TheTrueTom/GLINCS-KiCAD-Libraries/3D/BBL-105-G-E.stp

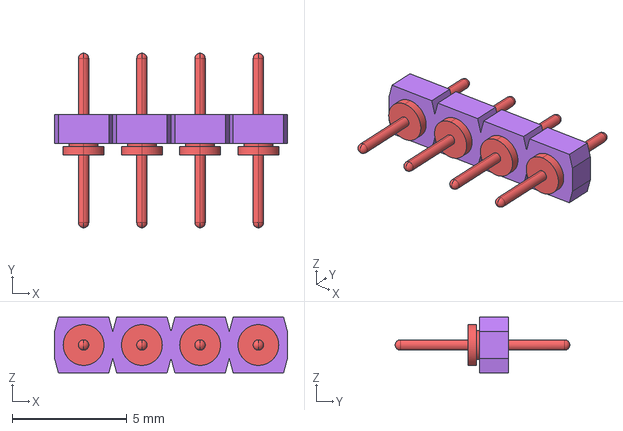
[picture p1: CAD file, 2020-01-22]
3D/BBL-105-G-E.stp
10.2 x 7.62 x 2.44 mm
