TheTrueTom/GLINCS-KiCAD-Libraries/3D/centrale AXINTDETECT/disjoncteur_legrand_007850.stp

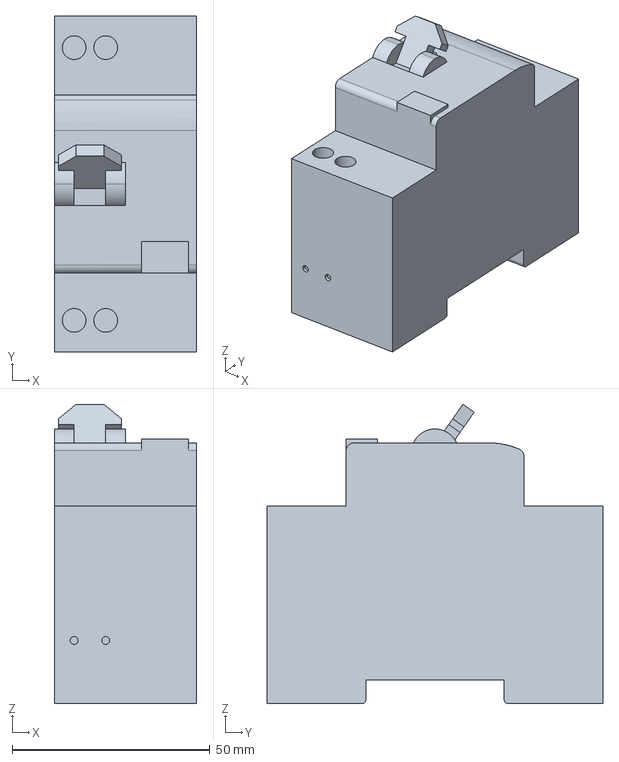
[picture p2: CAD file, 2023-04-24]
3D/centrale AXINTDETECT/disjoncteur_legrand_007850.stp
36.0 x 85.0 x 75.7 mm
