TheTrueTom/GLINCS-KiCAD-Libraries/3D/GLINCS/EVQ-Q2D03W.stp

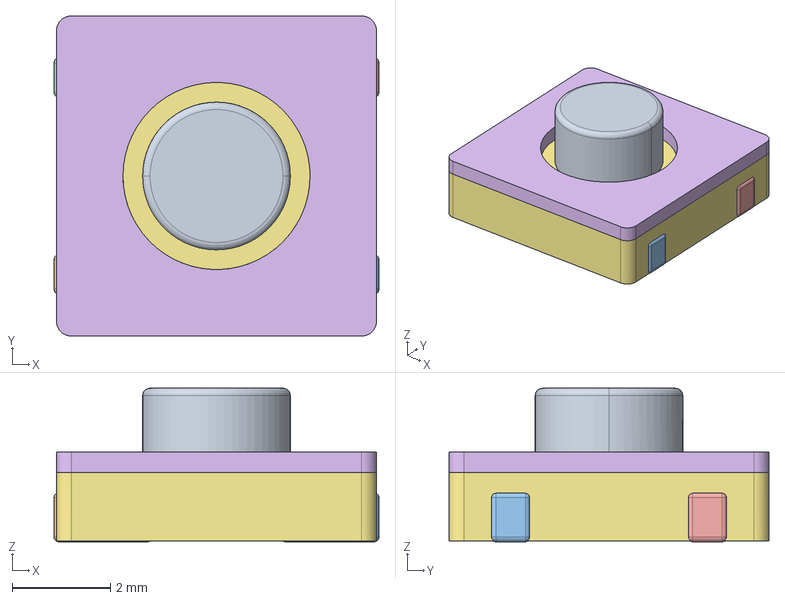
[picture p3: CAD file, 2026-05-20]
3D/GLINCS/EVQ-Q2D03W.stp
6.60 x 6.50 x 3.12 mm
