TheTrueTom/GLINCS-KiCAD-Libraries/3D/GLINCS_C/CAPA0603.step

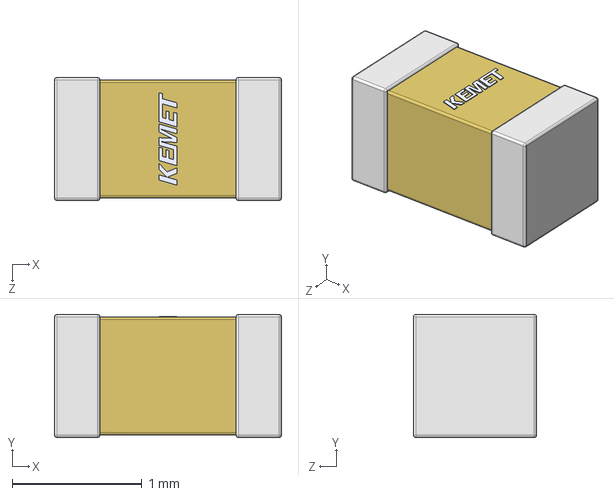
[picture p4: CAD file, 2025-09-26]
3D/GLINCS_C/CAPA0603.step
1.75 x 0.95 x 0.95 mm
