TheTrueTom/GLINCS-KiCAD-Libraries/3D/GLINCS_Connectors/B3B-ZR.STEP

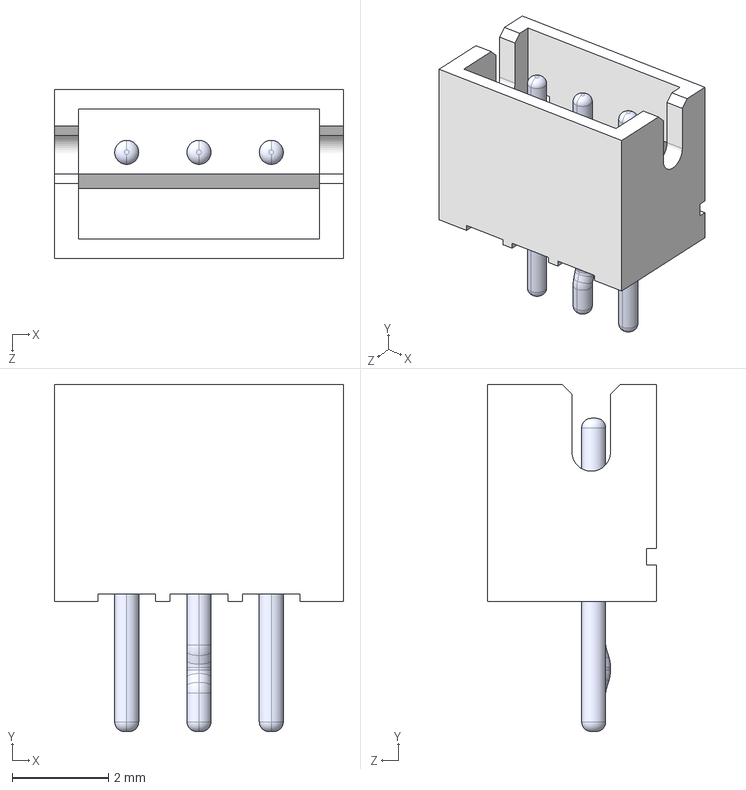
[picture p5: CAD file, 2026-04-17]
3D/GLINCS_Connectors/B3B-ZR.STEP
6.00 x 7.20 x 3.50 mm
BxB-ZR_3
pin_straight x 2
pin_Bent
