TheTrueTom/GLINCS-KiCAD-Libraries/3D/GLINCS_Connectors/JST-GH/BM02B-GHS-TBT/BM02B-GHS-TBT.STEP

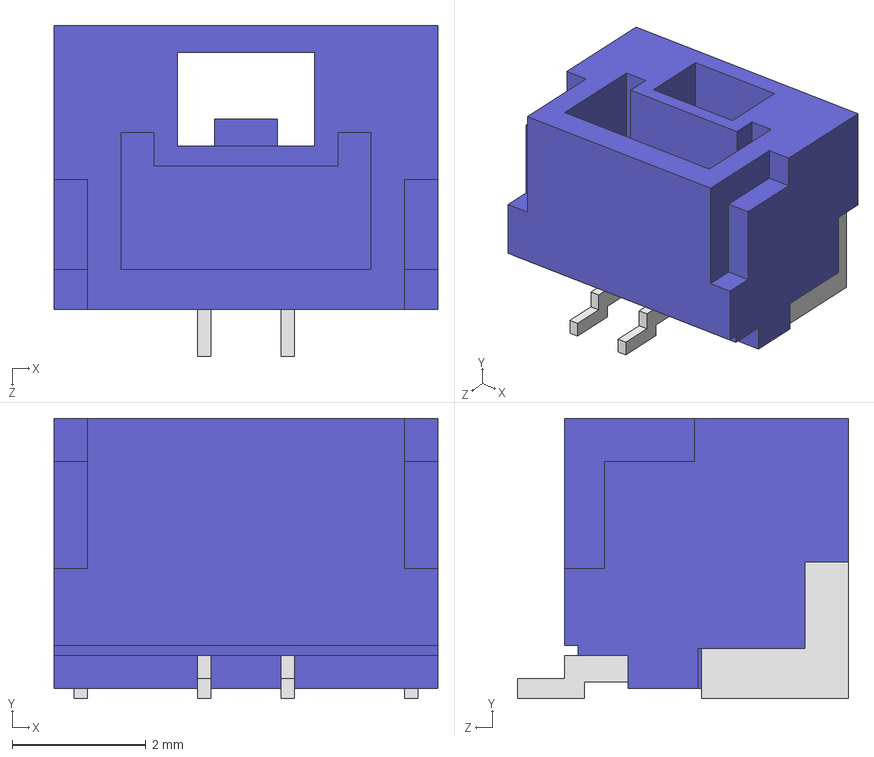
[picture p6: CAD file, 2021-05-18]
3D/GLINCS_Connectors/JST-GH/BM02B-GHS-TBT/BM02B-GHS-TBT.STEP
5.75 x 4.20 x 4.95 mm
