TheTrueTom/GLINCS-KiCAD-Libraries/3D/GLINCS_Connectors/JST-GH/BM03B-GHS-TBT/BM03B-GHS-TBT.STEP

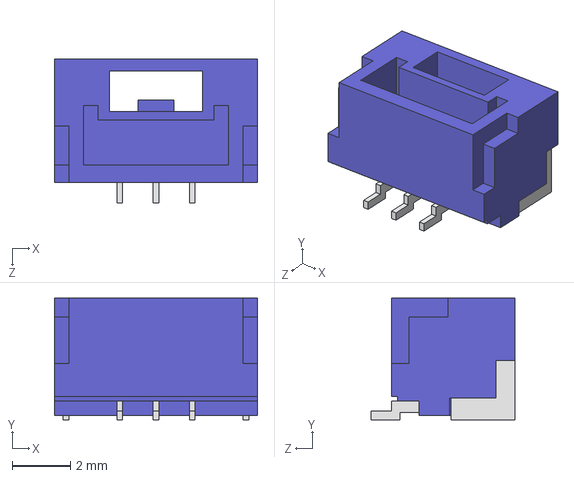
[picture p7: CAD file, 2021-05-18]
3D/GLINCS_Connectors/JST-GH/BM03B-GHS-TBT/BM03B-GHS-TBT.STEP
7.00 x 4.20 x 4.95 mm
