TheTrueTom/GLINCS-KiCAD-Libraries/3D/GLINCS_Connectors/JST-GH/BM04B-GHS-TBT/BM04B-GHS-TBT.STEP

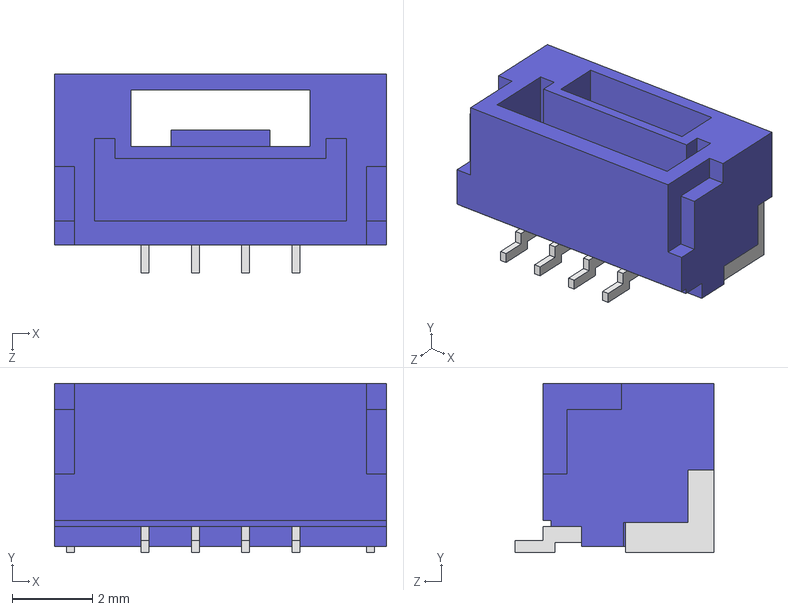
[picture p8: CAD file, 2021-05-18]
3D/GLINCS_Connectors/JST-GH/BM04B-GHS-TBT/BM04B-GHS-TBT.STEP
8.25 x 4.20 x 4.95 mm
