TheTrueTom/GLINCS-KiCAD-Libraries/3D/GLINCS_Connectors/JST-GH/GHR-02V-S/GHR-02V-S.STEP

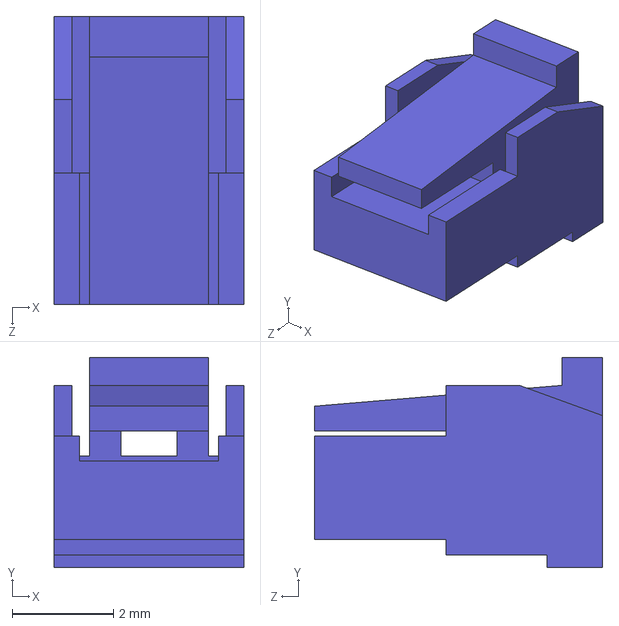
[picture p9: CAD file, 2021-05-18]
3D/GLINCS_Connectors/JST-GH/GHR-02V-S/GHR-02V-S.STEP
3.75 x 4.15 x 5.70 mm
