TheTrueTom/GLINCS-KiCAD-Libraries/3D/GLINCS_Connectors/JST-GH/GHR-03V-S/GHR-03V-S.STEP

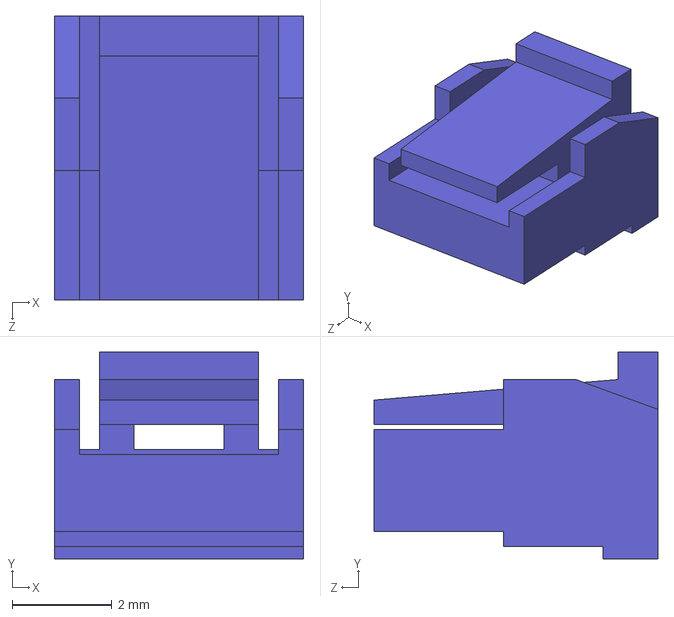
[picture p10: CAD file, 2021-05-18]
3D/GLINCS_Connectors/JST-GH/GHR-03V-S/GHR-03V-S.STEP
5.00 x 4.15 x 5.70 mm
