TheTrueTom/GLINCS-KiCAD-Libraries/3D/GLINCS_Connectors/JST-GH/GHR-04V-S/GHR-04V-S.STEP

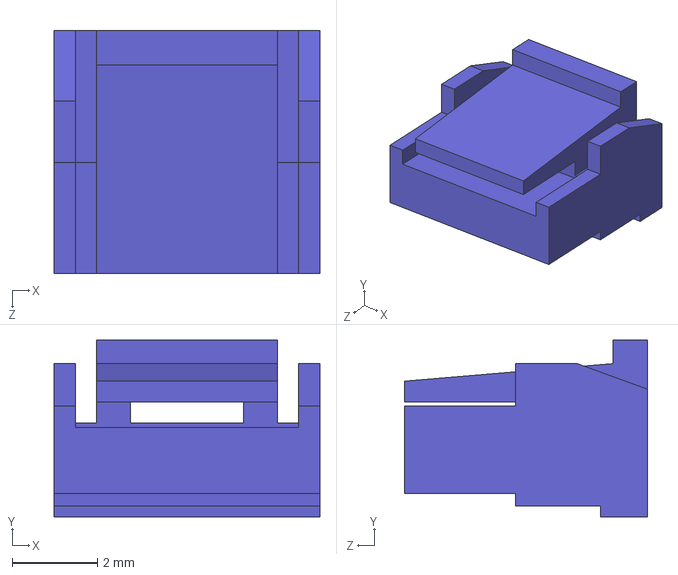
[picture p11: CAD file, 2021-05-18]
3D/GLINCS_Connectors/JST-GH/GHR-04V-S/GHR-04V-S.STEP
6.25 x 4.15 x 5.70 mm
