TheTrueTom/GLINCS-KiCAD-Libraries/3D/GLINCS_Connectors/JST-GH/SM02B-GHS-TB/SM02B-GHS-TB.STEP

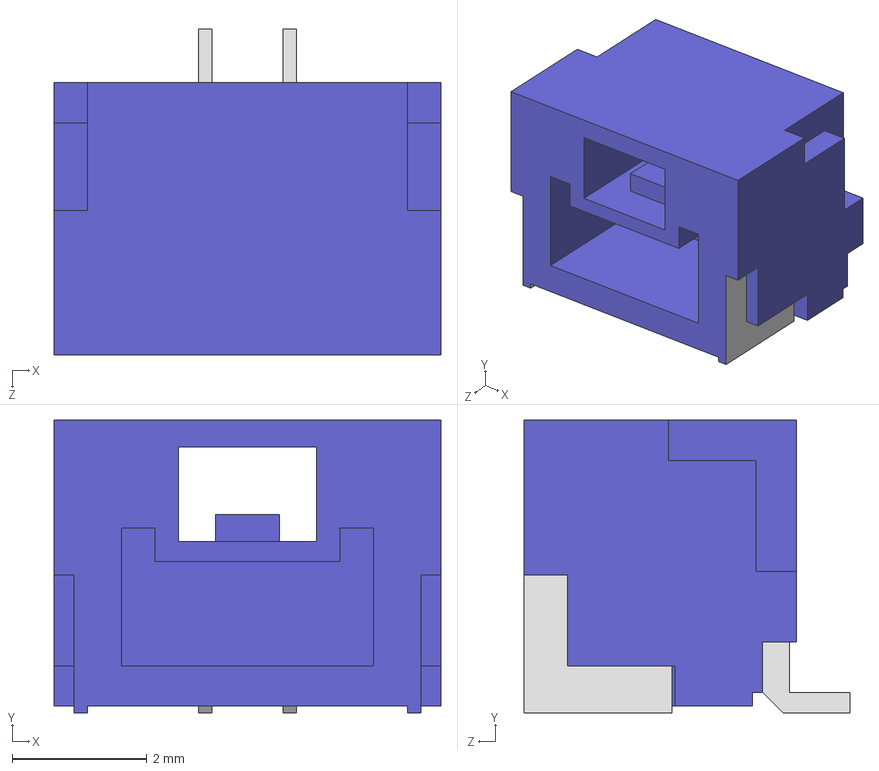
[picture p12: CAD file, 2021-05-18]
3D/GLINCS_Connectors/JST-GH/SM02B-GHS-TB/SM02B-GHS-TB.STEP
5.75 x 4.35 x 4.85 mm
