TheTrueTom/GLINCS-KiCAD-Libraries/3D/GLINCS_Connectors/JST-GH/SM03B-GHS-TB/SM03B-GHS-TB.STEP

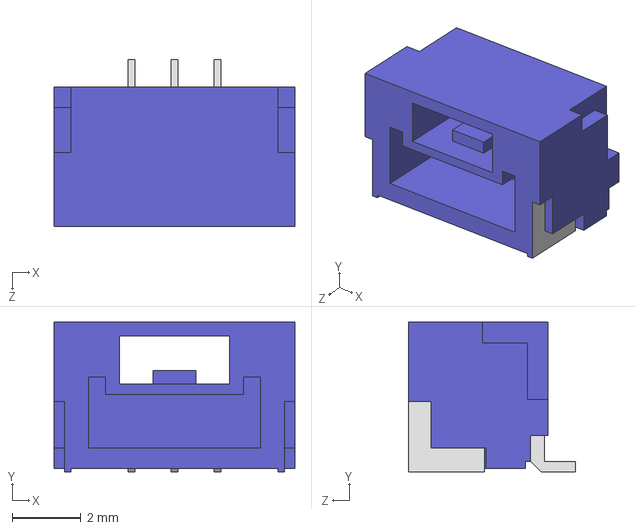
[picture p13: CAD file, 2021-05-18]
3D/GLINCS_Connectors/JST-GH/SM03B-GHS-TB/SM03B-GHS-TB.STEP
7.00 x 4.35 x 4.85 mm
