TheTrueTom/GLINCS-KiCAD-Libraries/3D/GLINCS_Connectors/JST-GH/SM04B-GHS-TB/SM08B-GHS-TB.STEP

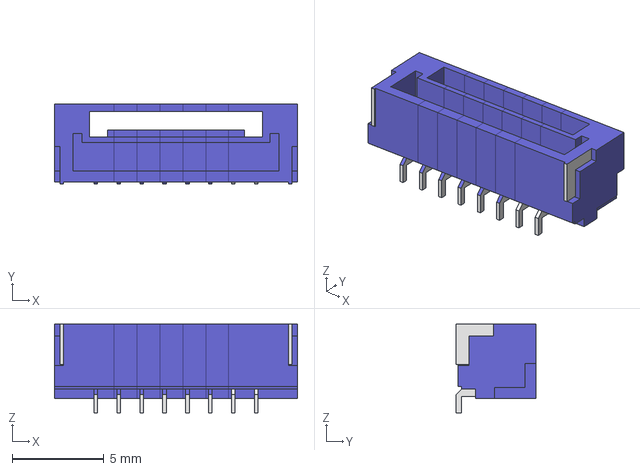
[picture p14: CAD file, 2021-05-18]
3D/GLINCS_Connectors/JST-GH/SM04B-GHS-TB/SM08B-GHS-TB.STEP
13.2 x 4.35 x 4.85 mm
