TheTrueTom/GLINCS-KiCAD-Libraries/3D/GLINCS_Connectors/JST-GH/SM06B-GHS-TB(LF)(SN)--3DModel-STEP-56544.STEP

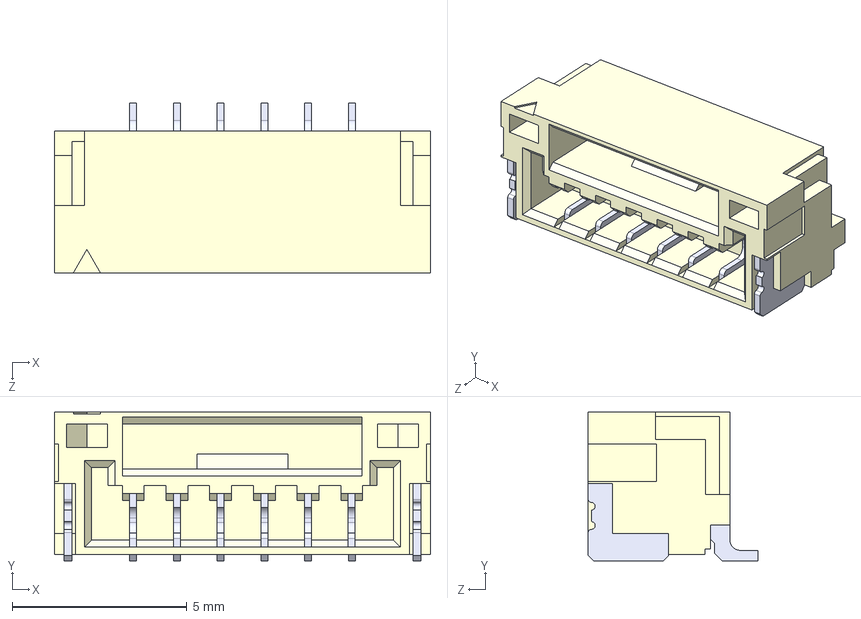
[picture p15: CAD file, 2021-05-18]
3D/GLINCS_Connectors/JST-GH/SM06B-GHS-TB(LF)(SN)--3DModel-STEP-56544.STEP
10.8 x 4.25 x 4.85 mm
