TheTrueTom/GLINCS-KiCAD-Libraries/3D/GLINCS_D/ESD5Z5V0.STEP

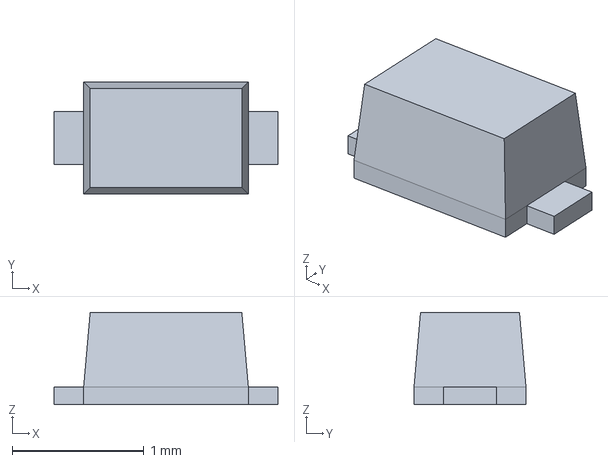
[picture p16: CAD file, 2026-05-20]
3D/GLINCS_D/ESD5Z5V0.STEP
1.70 x 0.85 x 0.7 mm
