TheTrueTom/GLINCS-KiCAD-Libraries/3D/GLINCS_R/RES0603.step

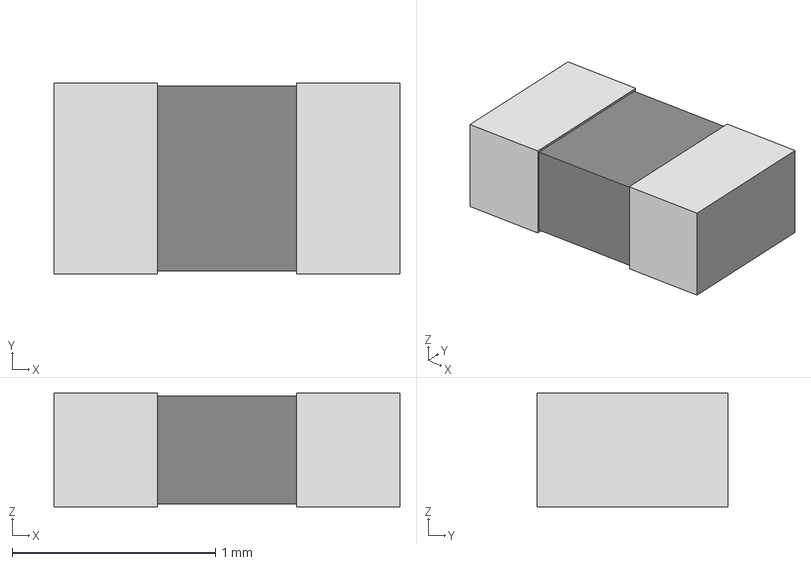
[picture p17: CAD file, 2025-09-26]
3D/GLINCS_R/RES0603.step
1.70 x 0.94 x 0.559 mm
