TheTrueTom/GLINCS-KiCAD-Libraries/3D/centrale AXINTDETECT/ 2320306_Batterie_24V_3.4AH.stp

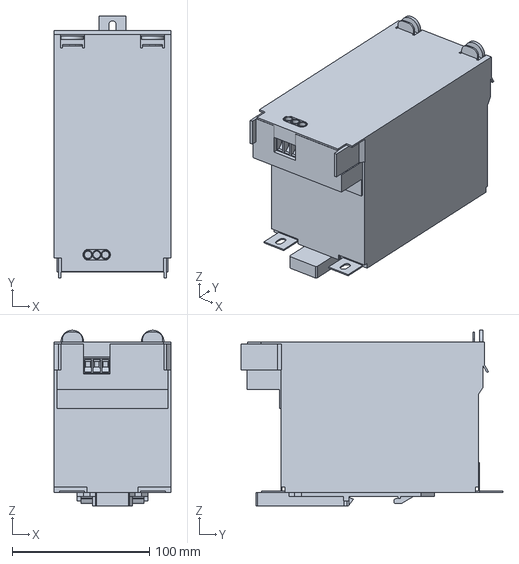
[picture p18: CAD file, 2023-04-24]
3D/centrale AXINTDETECT/ 2320306_Batterie_24V_3.4AH.stp
85.0 x 191.0 x 128.0 mm
