TheTrueTom/GLINCS-KiCAD-Libraries/3D/GLINCS/RKA2SGM055SMTR_LFS.stp

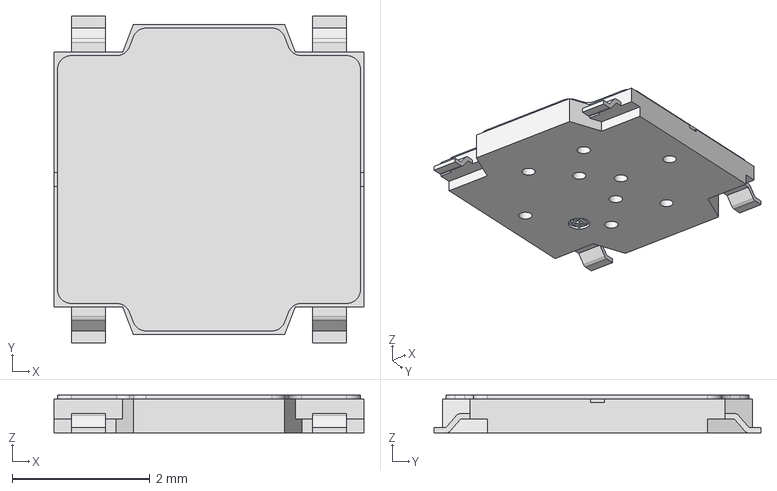
[picture p19: CAD file, 2026-05-20]
3D/GLINCS/RKA2SGM055SMTR_LFS.stp
4.50 x 4.75 x 0.55 mm
