TheTrueTom/GLINCS-KiCAD-Libraries/3D/GLINCS_Connectors/JST-GH/BM06B-GHS-TBT.stp

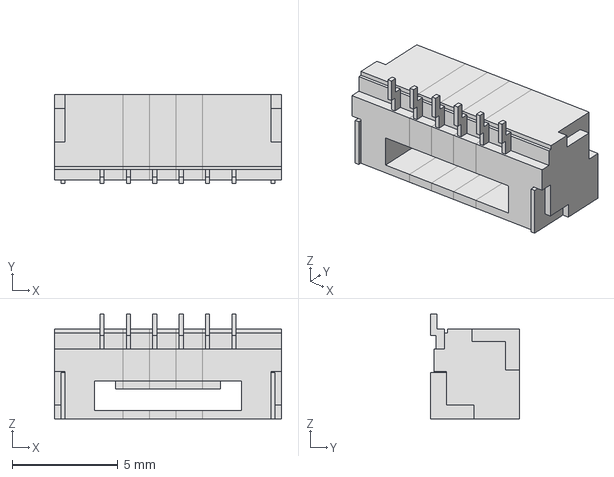
[picture p20: CAD file, 2020-12-03]
3D/GLINCS_Connectors/JST-GH/BM06B-GHS-TBT.stp
10.8 x 4.20 x 4.95 mm
