TheTrueTom/GLINCS-KiCAD-Libraries/3D/GLINCS_Connectors/JST-GH/SM04B-GHS-TB/SM04B-GHS-TB.STEP

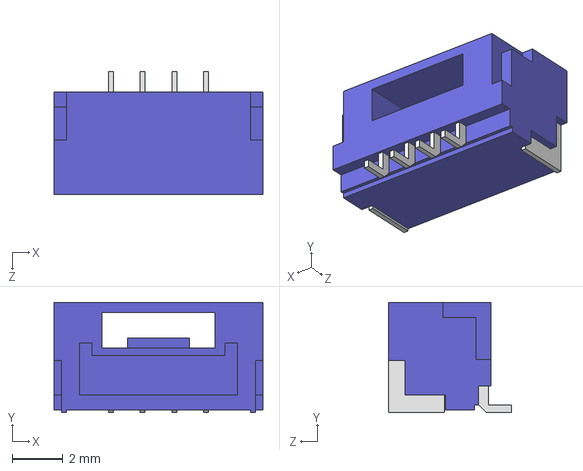
[picture p21: CAD file, 2021-05-18]
3D/GLINCS_Connectors/JST-GH/SM04B-GHS-TB/SM04B-GHS-TB.STEP
8.25 x 4.35 x 4.85 mm
