TheTrueTom/GLINCS-KiCAD-Libraries/3D/GLINCS_L/IND_1210-WE-LQ_WRE.step

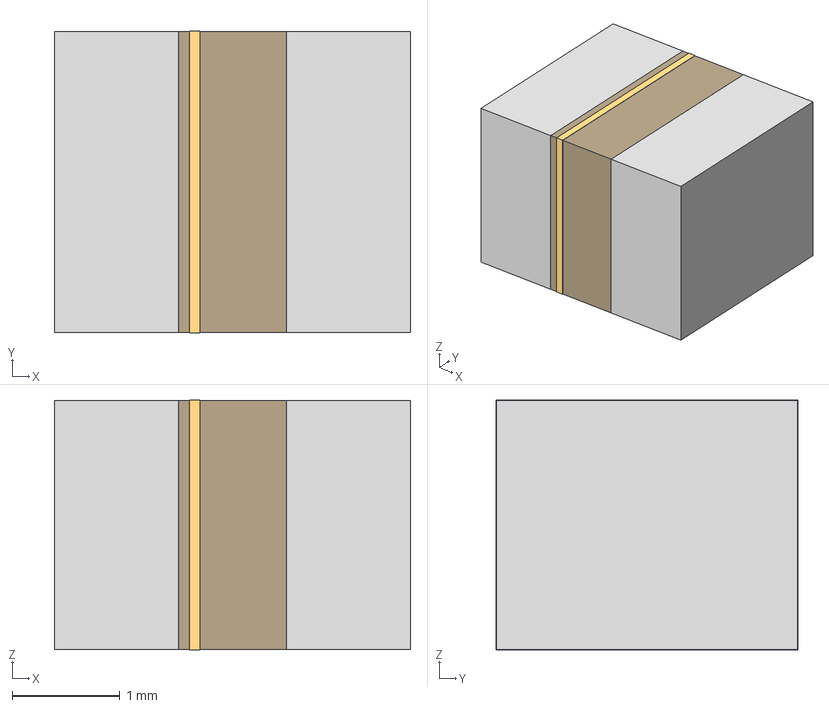
[picture p22: CAD file, 2023-04-24]
3D/GLINCS_L/IND_1210-WE-LQ_WRE.step
3.30 x 2.80 x 2.32 mm
