TheTrueTom/GLINCS-KiCAD-Libraries/3D/centrale AXINTDETECT/INTERRUPTEUR SECTEUR.stp

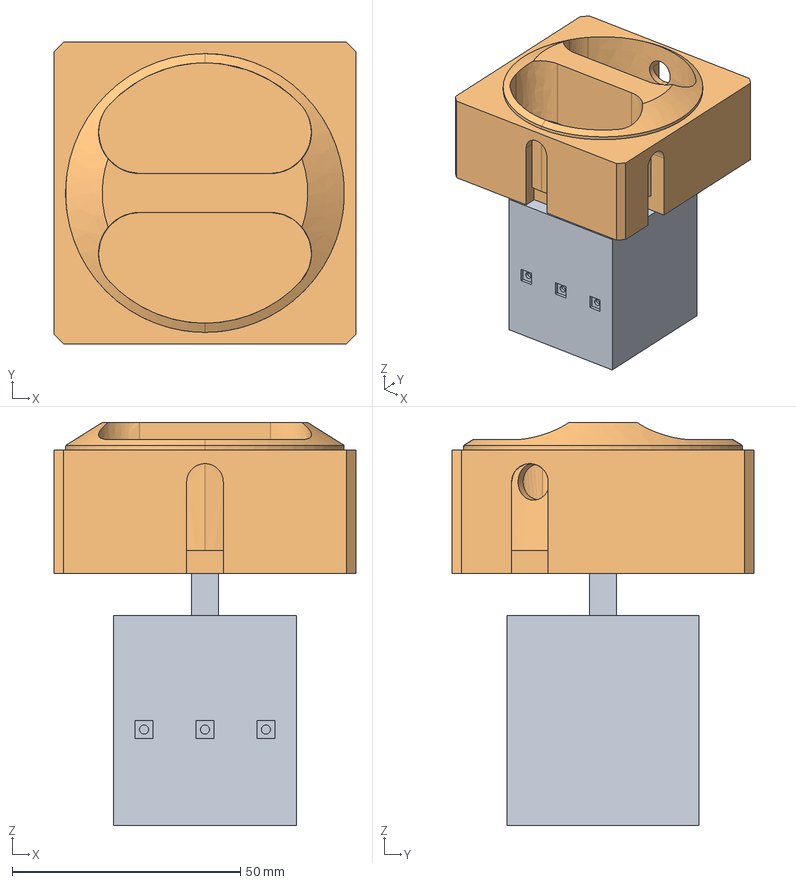
[picture p23: CAD file, 2023-04-24]
3D/centrale AXINTDETECT/INTERRUPTEUR SECTEUR.stp
66.0 x 66.0 x 88.2 mm
