TheTrueTom/GLINCS-KiCAD-Libraries/3D/GLINCS/MICROFJ_60035_COLOR.stp

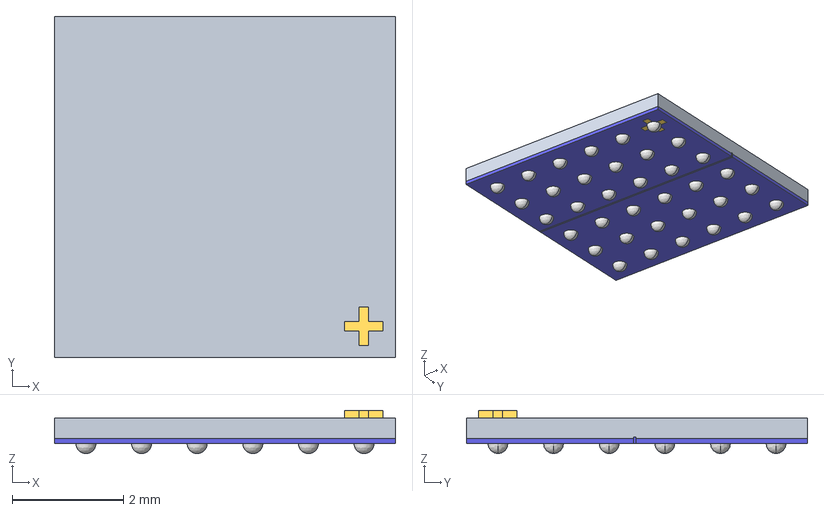
[picture p24: CAD file, 2026-03-02]
3D/GLINCS/MICROFJ_60035_COLOR.stp
6.13 x 6.13 x 0.776 mm
