TheTrueTom/GLINCS-KiCAD-Libraries/3D/GLINCS_L/IND_TAIYO_NRS4018_TAY.step

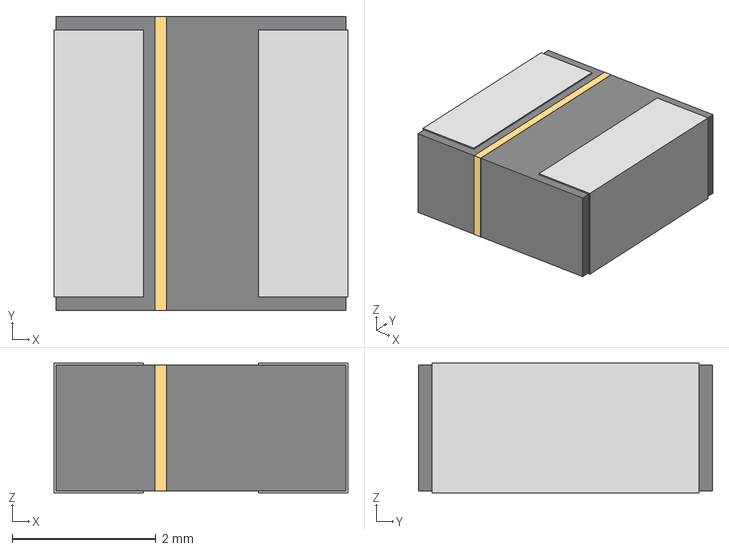
[picture p25: CAD file, 2022-11-09]
3D/GLINCS_L/IND_TAIYO_NRS4018_TAY.step
4.09 x 4.09 x 1.80 mm
