TheTrueTom/GLINCS-KiCAD-Libraries/3D/centrale AXINTDETECT/VOYANT_SOUS_TENSION_023770.stp

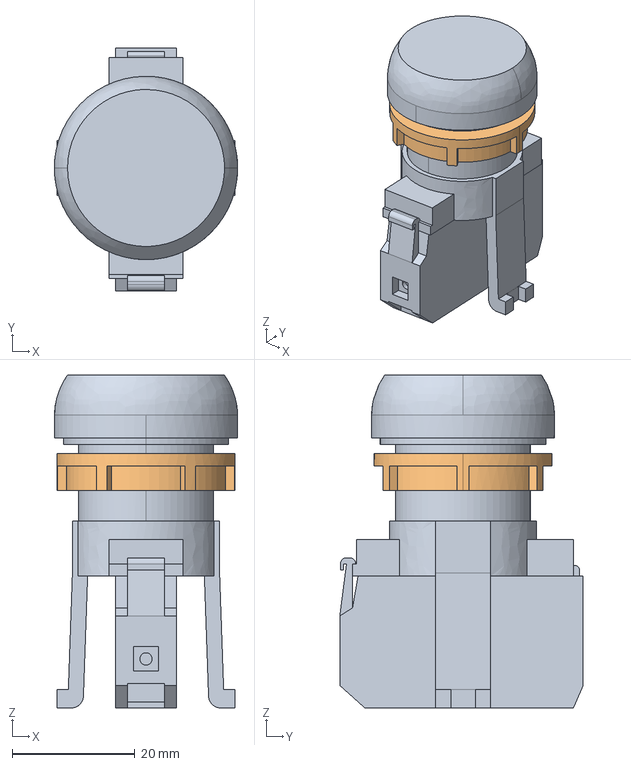
[picture p26: CAD file, 2023-04-24]
3D/centrale AXINTDETECT/VOYANT_SOUS_TENSION_023770.stp
29.9 x 39.7 x 54.3 mm
