TheTrueTom/GLINCS-KiCAD-Libraries/3D/GLINCS_L/srr5018.stp

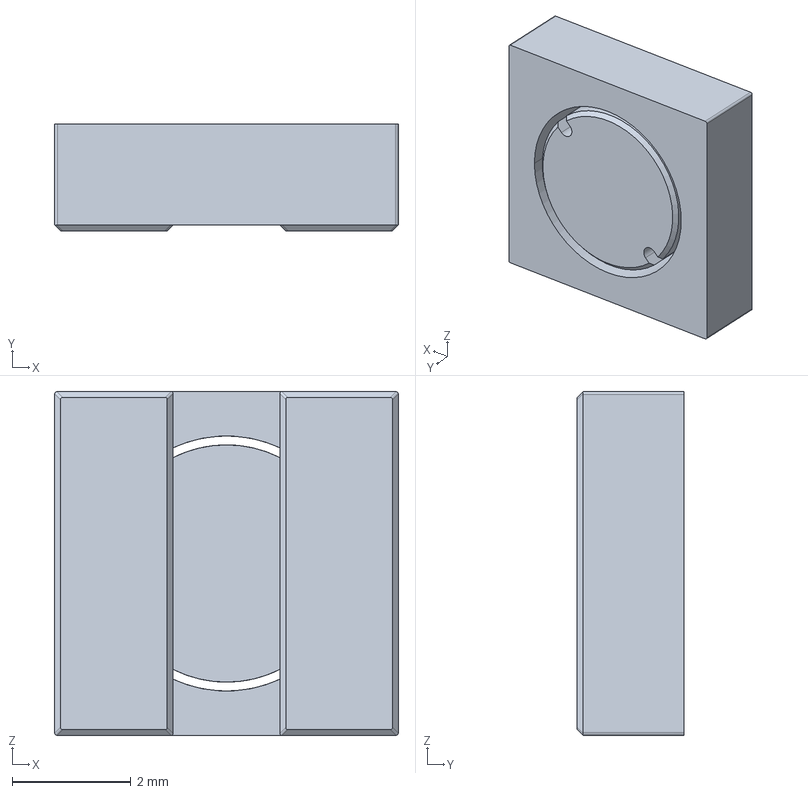
[picture p27: CAD file, 2021-05-18]
3D/GLINCS_L/srr5018.stp
5.80 x 1.80 x 5.80 mm
