TheTrueTom/GLINCS-KiCAD-Libraries/3D/centrale AXINTDETECT/disjoncteurDC_scbhneider_MGN61506.stp

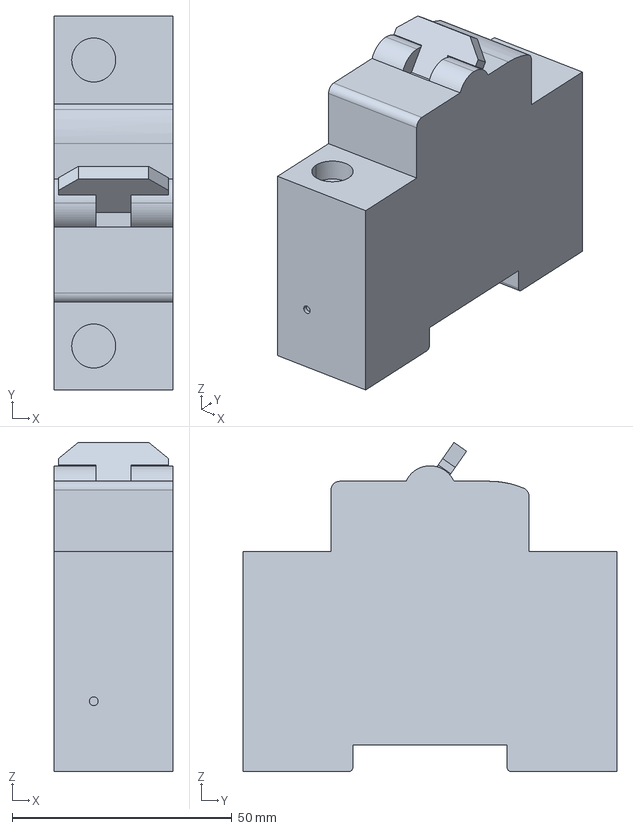
[picture p28: CAD file, 2023-04-24]
3D/centrale AXINTDETECT/disjoncteurDC_scbhneider_MGN61506.stp
27.0 x 85.0 x 74.8 mm
