TheTrueTom/GLINCS-KiCAD-Libraries/3D/GLINCS/D0008A.stp

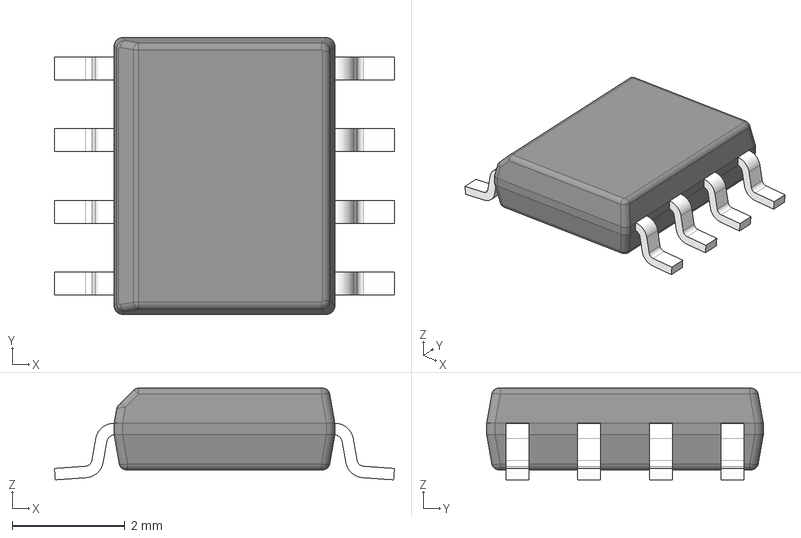
[picture p29: CAD file, 2025-09-26]
3D/GLINCS/D0008A.stp
6.02 x 4.90 x 1.63 mm
BODY-SO
LEAD-D0008A x 8
