TheTrueTom/GLINCS-KiCAD-Libraries/3D/GLINCS_Connectors/B10B-ZR-SM4-TF--3DModel-STEP-56544.STEP

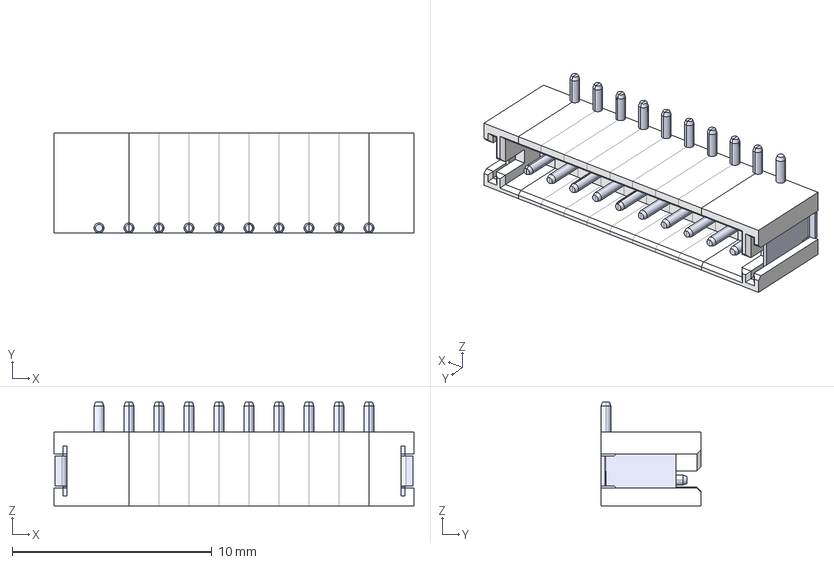
[picture p30: CAD file, 2026-04-14]
3D/GLINCS_Connectors/B10B-ZR-SM4-TF--3DModel-STEP-56544.STEP
18.0 x 5.00 x 5.20 mm
