TheTrueTom/GLINCS-KiCAD-Libraries/3D/GLINCS/RU_24_ADI.step

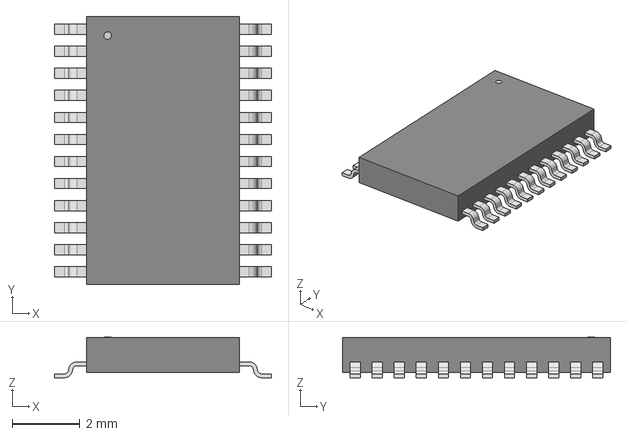
[picture p31: CAD file, 2025-09-26]
3D/GLINCS/RU_24_ADI.step
6.40 x 7.90 x 1.20 mm
