TheTrueTom/GLINCS-KiCAD-Libraries/3D/GLINCS_Connectors/BM03B-SRSS-TB-LFSN.STEP

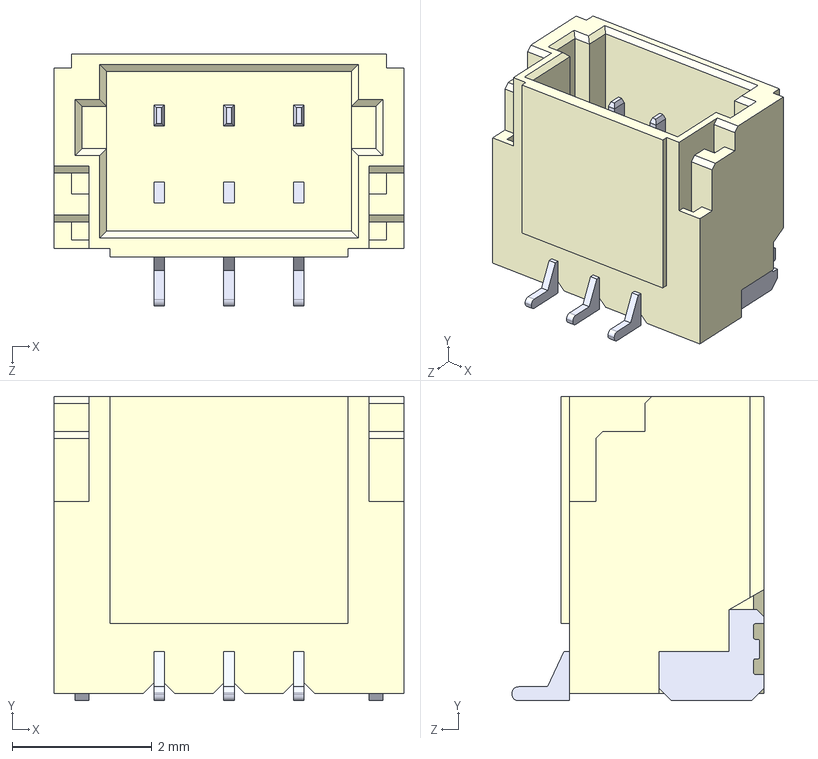
[picture p32: CAD file, 2026-04-14]
3D/GLINCS_Connectors/BM03B-SRSS-TB-LFSN.STEP
5.00 x 4.35 x 3.60 mm
