TheTrueTom/GLINCS-KiCAD-Libraries/3D/GLINCS_L/MSS1260-104MLD.stp

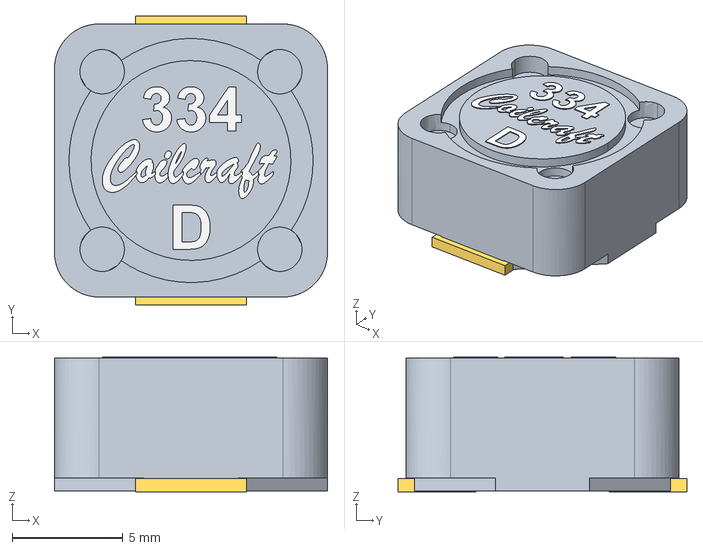
[picture p33: CAD file, 2020-12-03]
3D/GLINCS_L/MSS1260-104MLD.stp
12.3 x 13.0 x 6.07 mm
