TheTrueTom/GLINCS-KiCAD-Libraries/3D/GLINCS/SOT23_3_BC817.step

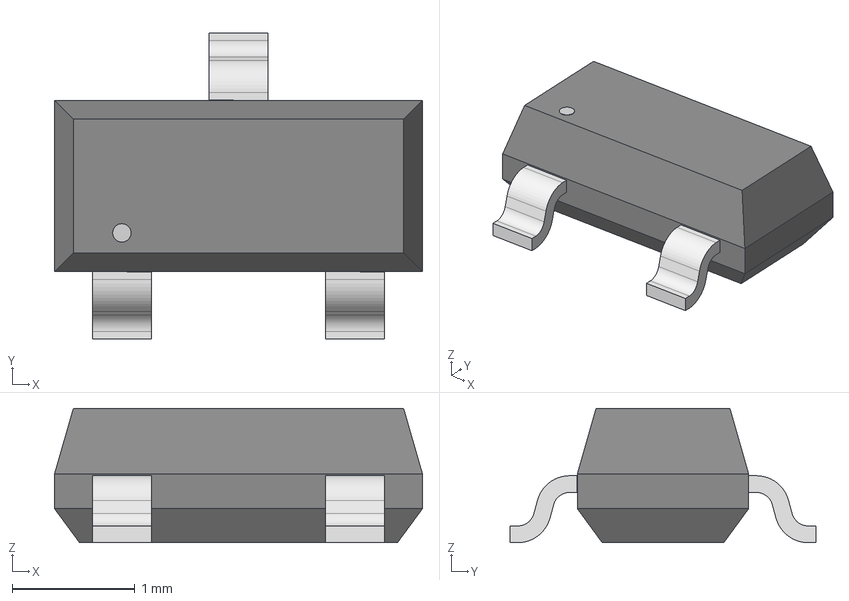
[picture p34: CAD file, 2025-09-26]
3D/GLINCS/SOT23_3_BC817.step
3.00 x 2.49 x 1.09 mm
