TheTrueTom/GLINCS-KiCAD-Libraries/3D/GLINCS_Connectors/SFW16S-2STE1LF.step

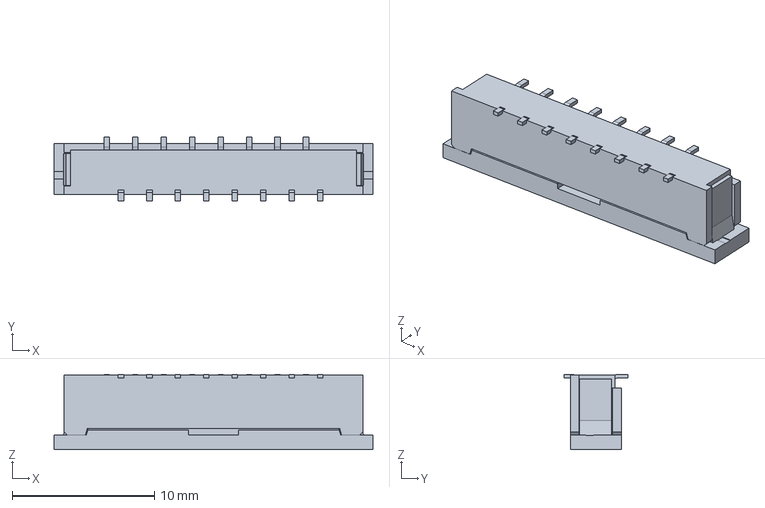
[picture p35: CAD file, 2026-04-14]
3D/GLINCS_Connectors/SFW16S-2STE1LF.step
22.4 x 4.50 x 5.30 mm
