TheTrueTom/GLINCS-KiCAD-Libraries/3D/GLINCS_L/TCK-048.stp

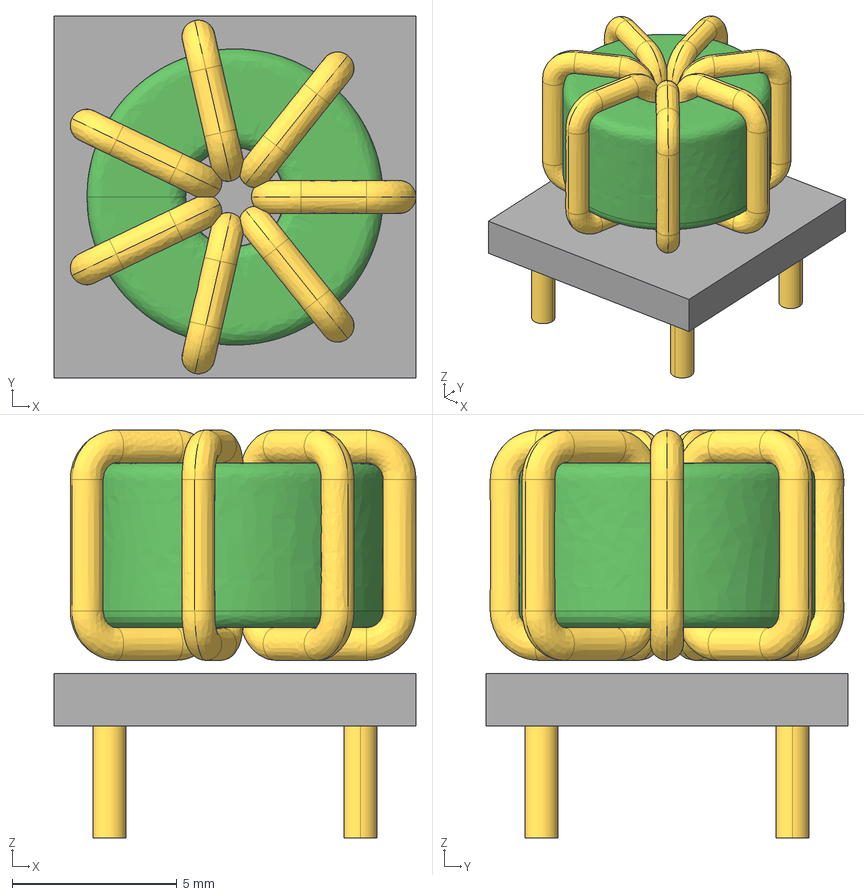
[picture p36: CAD file, 2019-10-25]
3D/GLINCS_L/TCK-048.stp
11.0 x 11.0 x 12.4 mm
