TheTrueTom/GLINCS-KiCAD-Libraries/3D/GLINCS/21-0041B_8.step

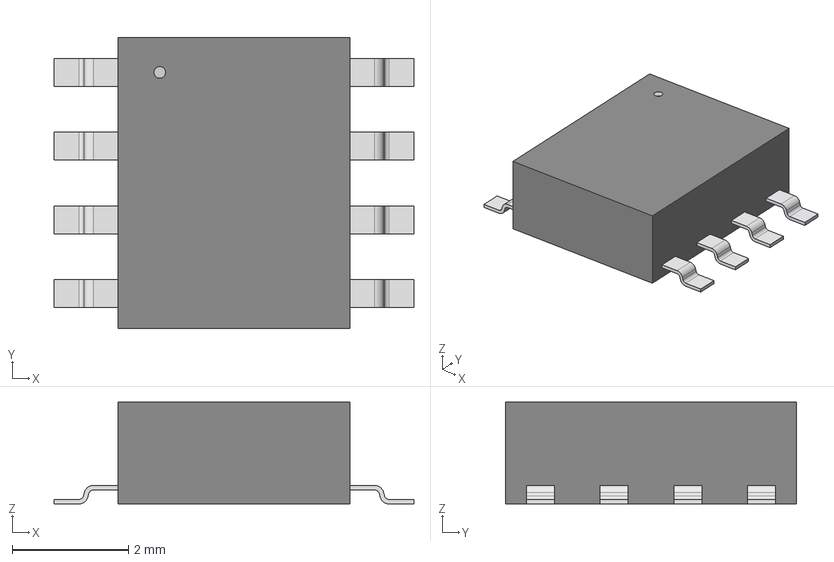
[picture p37: CAD file, 2025-09-26]
3D/GLINCS/21-0041B_8.step
6.20 x 5.00 x 1.75 mm
