TheTrueTom/GLINCS-KiCAD-Libraries/3D/GLINCS_Connectors/SFW16R-2STE1LF.step

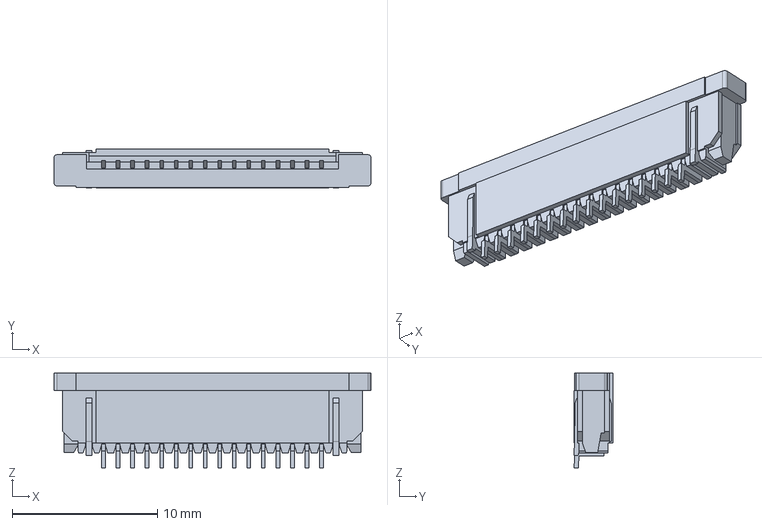
[picture p38: CAD file, 2026-04-14]
3D/GLINCS_Connectors/SFW16R-2STE1LF.step
21.8 x 2.70 x 6.50 mm
