TheTrueTom/GLINCS-KiCAD-Libraries/3D/GLINCS_L/BOURNS SDR1006.stp

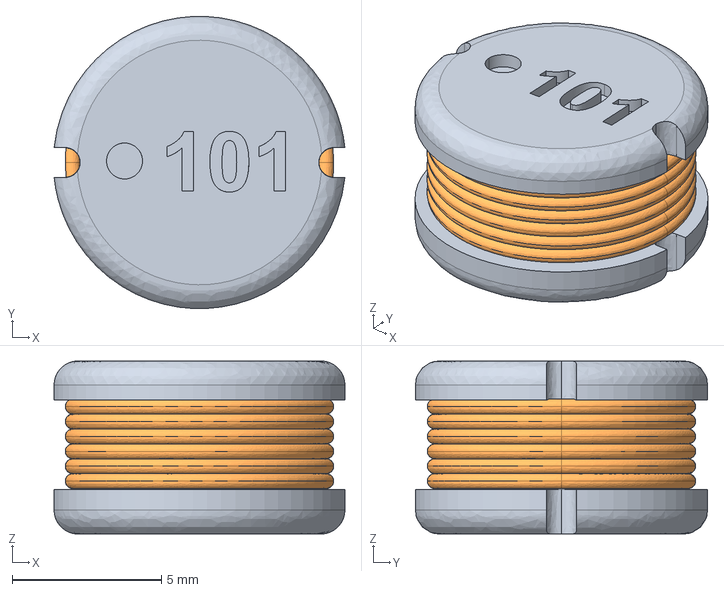
[picture p39: CAD file, 2019-08-28]
3D/GLINCS_L/BOURNS SDR1006.stp
9.75 x 9.79 x 5.80 mm
