TheTrueTom/GLINCS-KiCAD-Libraries/3D/GLINCS/DSBGA8-YBG_TEX.step

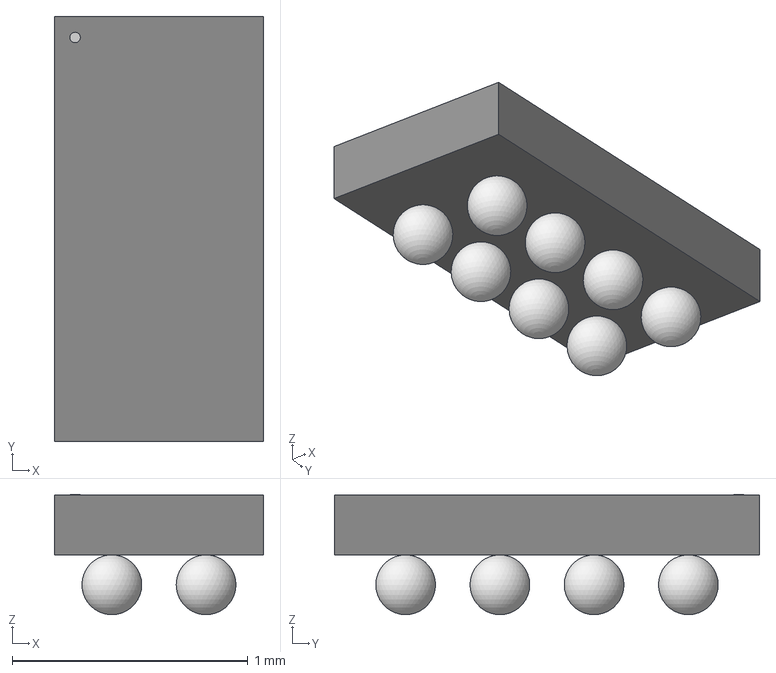
[picture p40: CAD file, 2025-09-26]
3D/GLINCS/DSBGA8-YBG_TEX.step
0.888 x 1.80 x 0.511 mm
