TheTrueTom/GLINCS-KiCAD-Libraries/3D/GLINCS_Connectors/SFW16R-1STE1LF.STEP

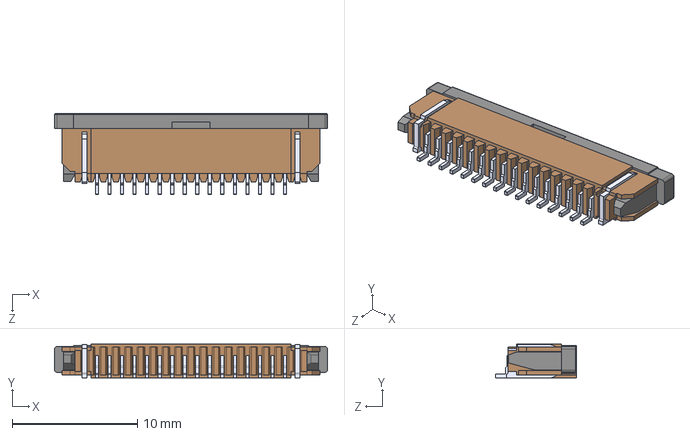
[picture p41: CAD file, 2026-04-14]
3D/GLINCS_Connectors/SFW16R-1STE1LF.STEP
21.8 x 2.70 x 6.50 mm
