TheTrueTom/GLINCS-KiCAD-Libraries/3D/GLINCS_L/bobine Tayo yuden.stp

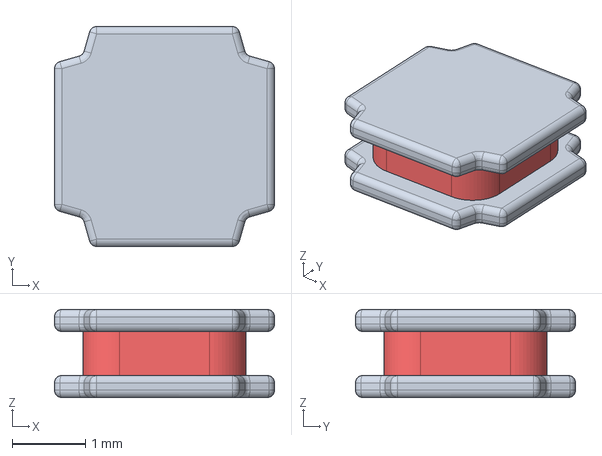
[picture p42: CAD file, 2019-08-28]
3D/GLINCS_L/bobine Tayo yuden.stp
3.00 x 3.00 x 1.20 mm
