TheTrueTom/GLINCS-KiCAD-Libraries/3D/GLINCS/SOT26-420_DIO.step

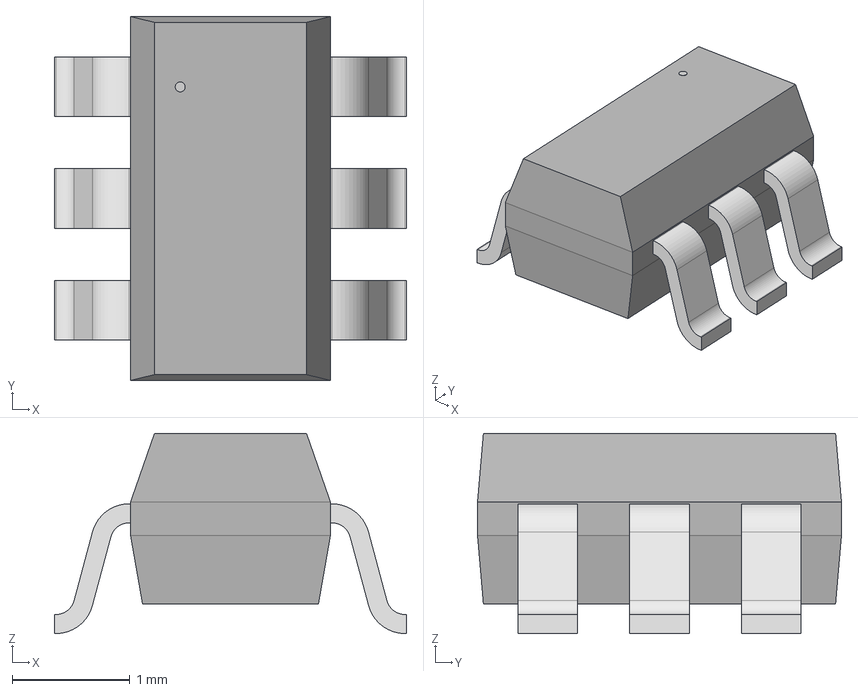
[picture p43: CAD file, 2025-09-26]
3D/GLINCS/SOT26-420_DIO.step
3.00 x 3.10 x 1.70 mm
