TheTrueTom/GLINCS-KiCAD-Libraries/3D/GLINCS_L/Coilcraft-XAL1010.step

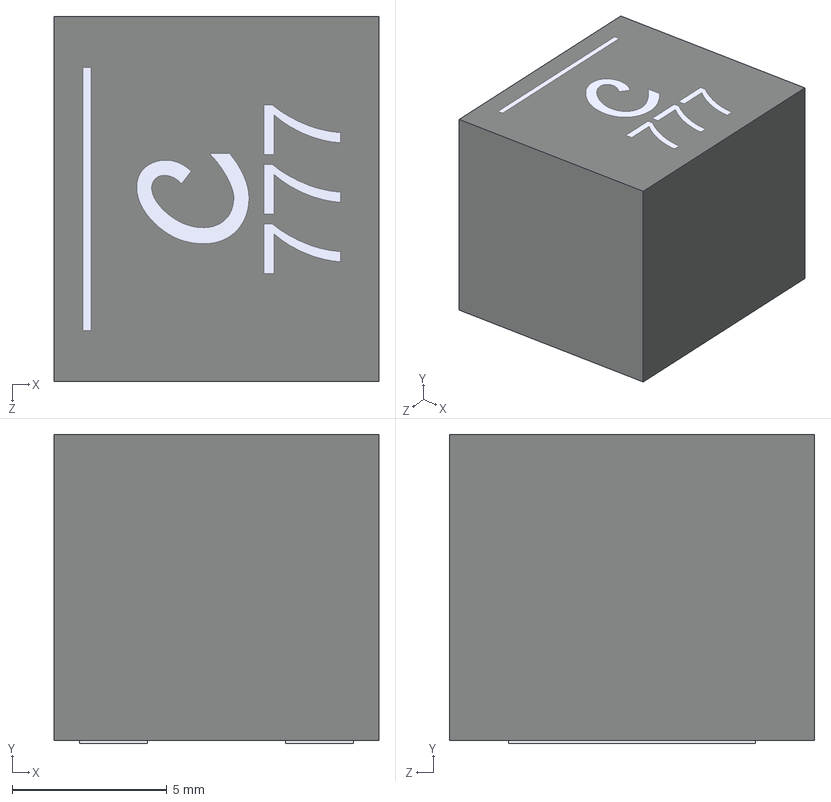
[picture p44: CAD file, 2018-11-21]
3D/GLINCS_L/Coilcraft-XAL1010.step
10.5 x 10.0 x 11.8 mm
