TheTrueTom/GLINCS-KiCAD-Libraries/3D/GLINCS/Analog_LFCSP-16-1EP_4x4mm_P0.65mm_EP2.1x2.1mm.step

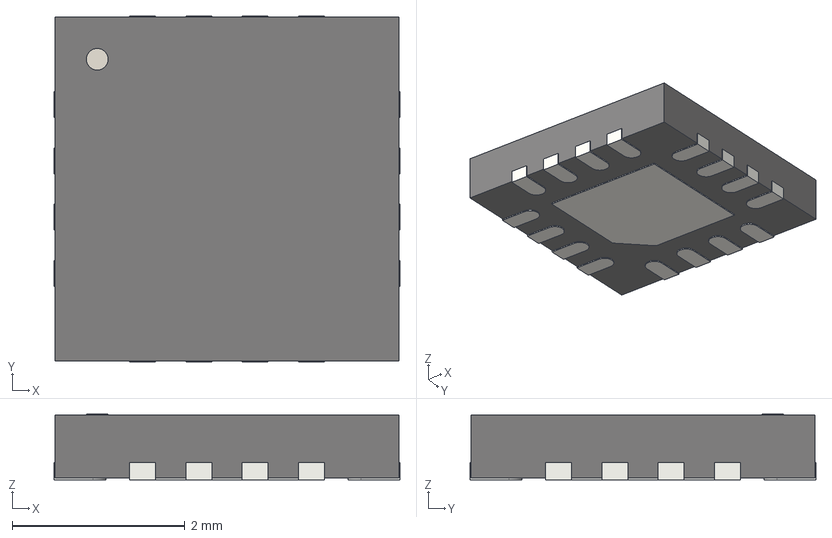
[picture p45: CAD file, 2025-09-26]
3D/GLINCS/Analog_LFCSP-16-1EP_4x4mm_P0.65mm_EP2.1x2.1mm.step
4.00 x 4.00 x 0.76 mm
1dbc6228-aab6-11ed-a8a3-acde48001122_part
1dbc66ba-aab6-11ed-a8a3-acde48001122_part
1dbc6796-aab6-11ed-a8a3-acde48001122_part
1dbc6822-aab6-11ed-a8a3-acde48001122_part
