TheTrueTom/GLINCS-KiCAD-Libraries/3D/GLINCS_Connectors/housing.stp

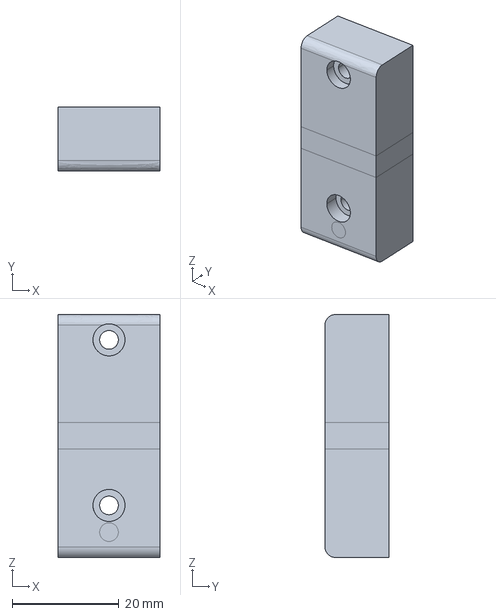
[picture p46: CAD file, 2026-04-14]
3D/GLINCS_Connectors/housing.stp
19.1 x 12.0 x 45.5 mm
