TheTrueTom/GLINCS-KiCAD-Libraries/3D/GLINCS/TL2233OA.stp

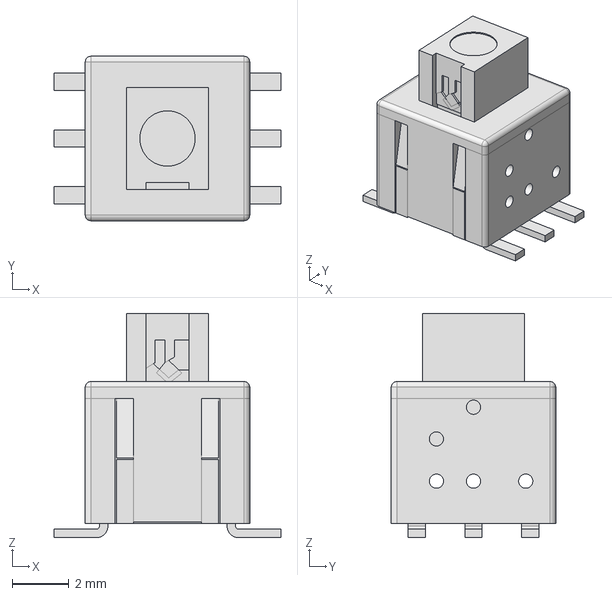
[picture p47: CAD file, 2025-09-26]
3D/GLINCS/TL2233OA.stp
8.00 x 5.80 x 7.90 mm
