TheTrueTom/GLINCS-KiCAD-Libraries/3D/GLINCS_Connectors/B3B-ZR-SM4-TF--3DModel-STEP-56544.STEP

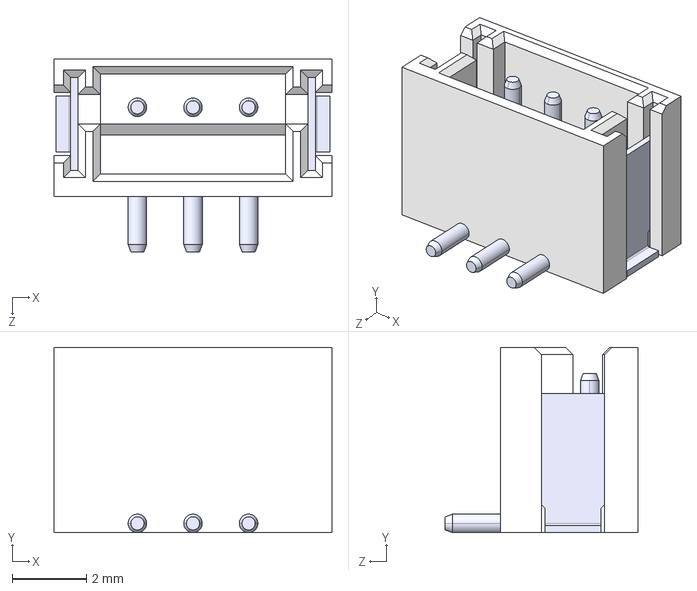
[picture p48: CAD file, 2026-03-03]
3D/GLINCS_Connectors/B3B-ZR-SM4-TF--3DModel-STEP-56544.STEP
7.50 x 5.00 x 5.20 mm
BxB-ZR-SM4_3
BxB-ZR-SM4 pins_3
