TheTrueTom/GLINCS-KiCAD-Libraries/3D/GLINCS/RJ_8_ADI.step

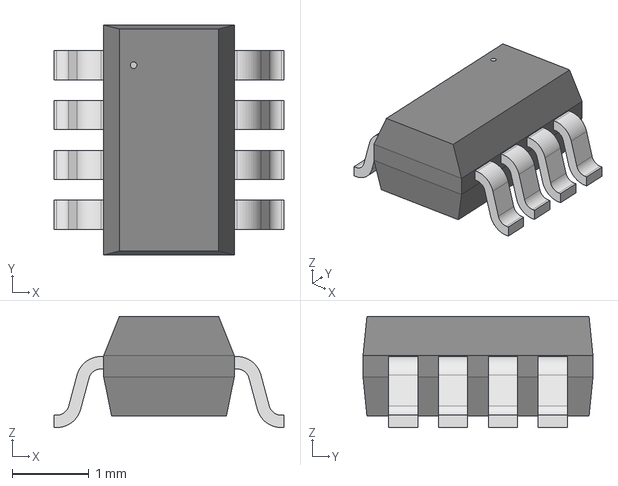
[picture p49: CAD file, 2025-09-26]
3D/GLINCS/RJ_8_ADI.step
3.00 x 3.00 x 1.45 mm
