TheTrueTom/GLINCS-KiCAD-Libraries/3D/GLINCS_Connectors/S3B-ZR-SM4A-TF.STEP.stl

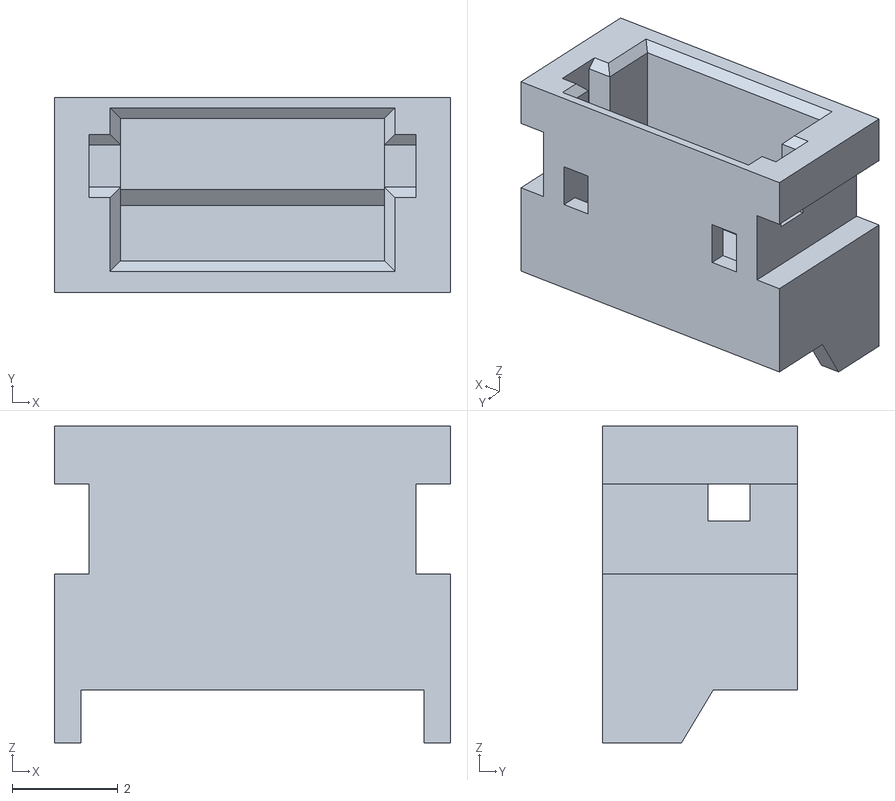
[picture p50: CAD file, 2026-03-02]
3D/GLINCS_Connectors/S3B-ZR-SM4A-TF.STEP.stl
7.50 x 3.70 x 6.00
