TheTrueTom/GLINCS-KiCAD-Libraries/3D/GLINCS/G3VM_61VR.step

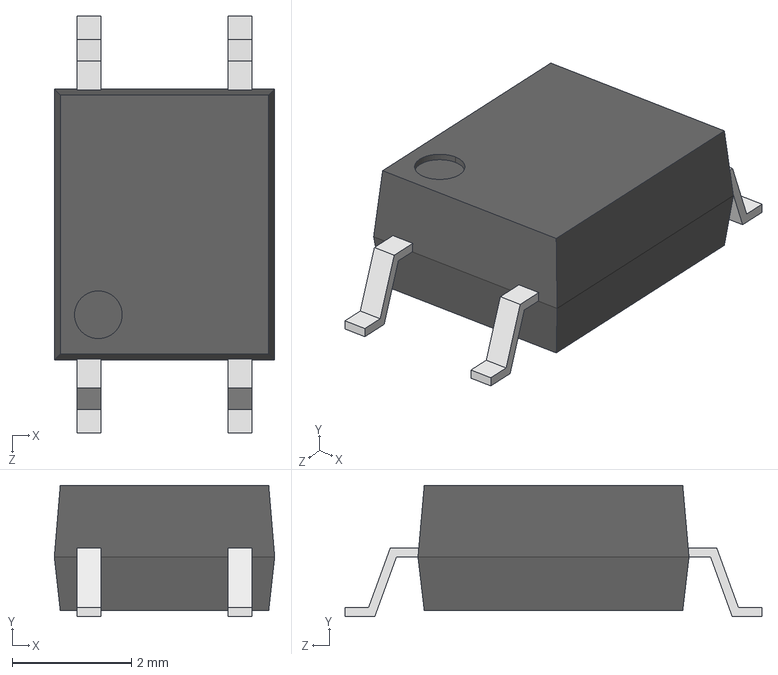
[picture p51: CAD file, 2025-09-26]
3D/GLINCS/G3VM_61VR.step
3.70 x 2.20 x 7.00 mm
