TheTrueTom/GLINCS-KiCAD-Libraries/3D/GLINCS_Connectors/S3B-ZR-SM4A-TF-rhino.stp

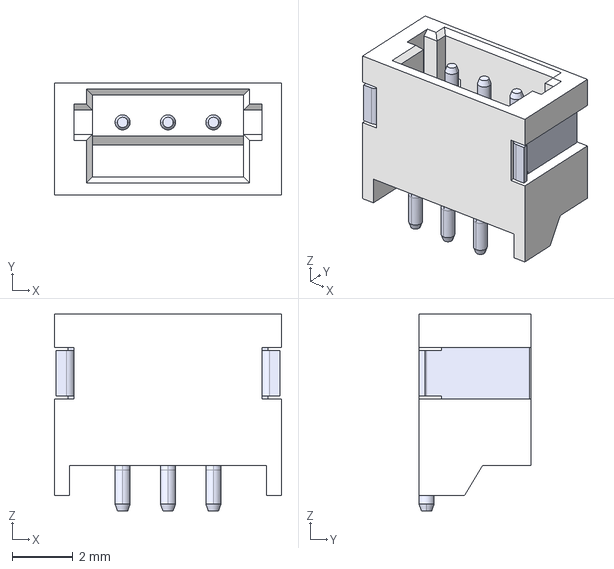
[picture p52: CAD file, 2026-03-02]
3D/GLINCS_Connectors/S3B-ZR-SM4A-TF-rhino.stp
7.50 x 3.70 x 6.50 mm
