TheTrueTom/GLINCS-KiCAD-Libraries/3D/GLINCS/MSE_12_ADI.step

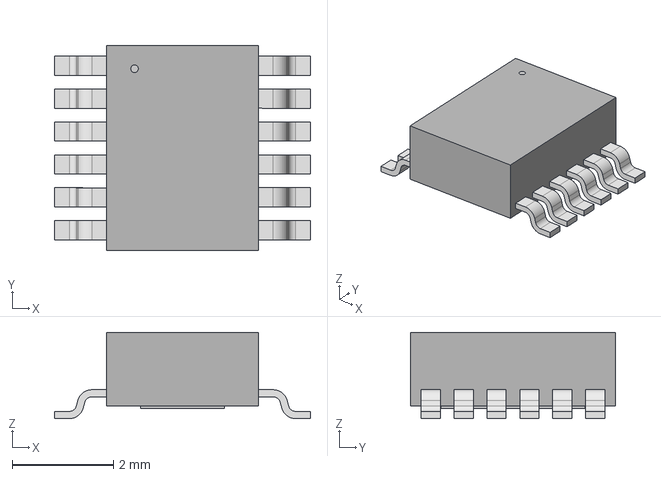
[picture p53: CAD file, 2025-09-26]
3D/GLINCS/MSE_12_ADI.step
5.05 x 4.04 x 1.70 mm
