TheTrueTom/GLINCS-KiCAD-Libraries/3D/GLINCS/QFN20_4x4MC_MCH.step

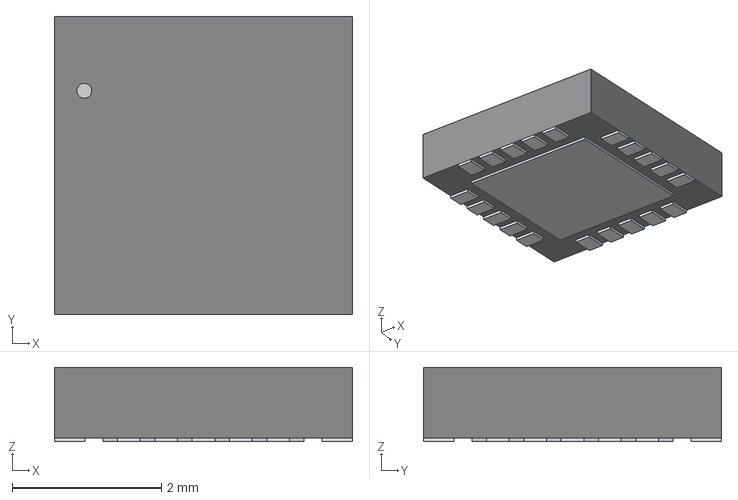
[picture p54: CAD file, 2025-09-26]
3D/GLINCS/QFN20_4x4MC_MCH.step
3.99 x 3.99 x 0.993 mm
