TheTrueTom/GLINCS-KiCAD-Libraries/3D/GLINCS_Connectors/pcb_connector_802-10-004-30-507101.stp

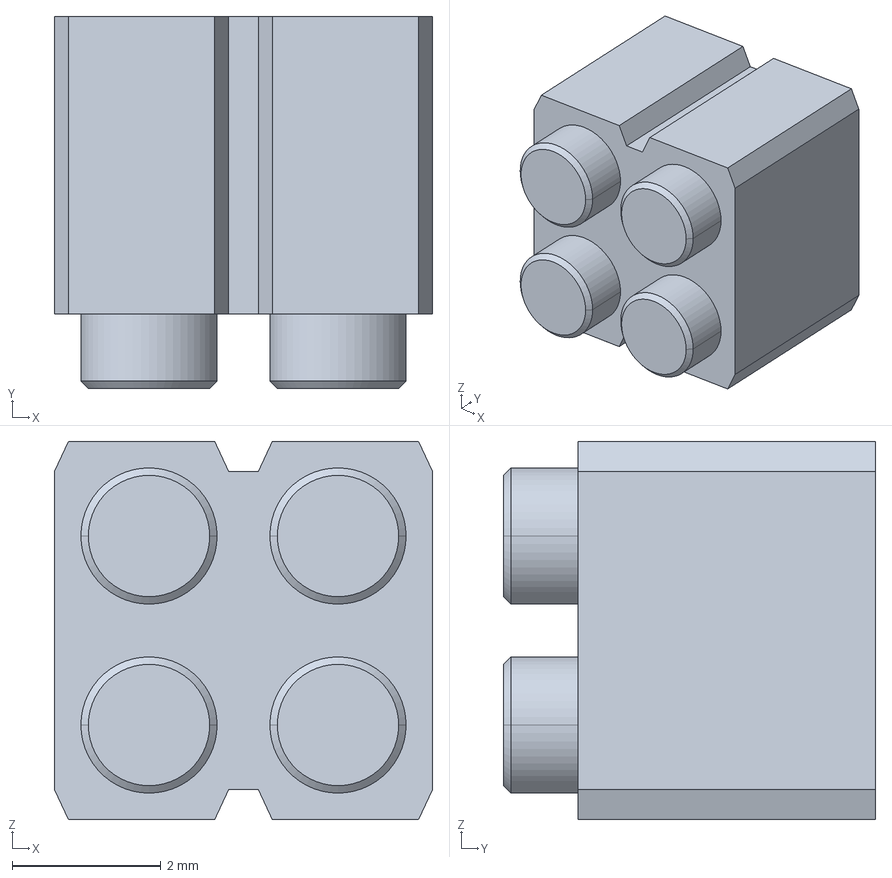
[picture p55: CAD file, 2025-09-26]
3D/GLINCS_Connectors/pcb_connector_802-10-004-30-507101.stp
5.08 x 5.00 x 5.08 mm
