TheTrueTom/GLINCS-KiCAD-Libraries/3D/GLINCS/SPW0878LR5H-1.stp

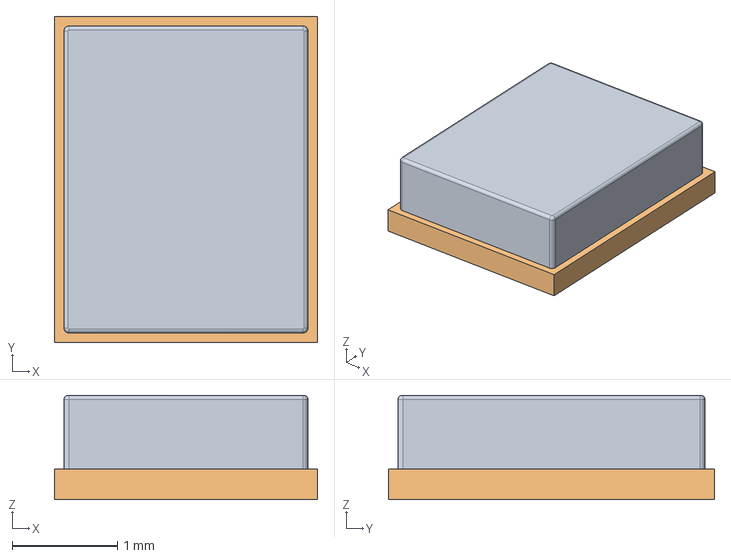
[picture p56: CAD file, 2025-09-26]
3D/GLINCS/SPW0878LR5H-1.stp
2.50 x 3.10 x 0.99 mm
