TheTrueTom/GLINCS-KiCAD-Libraries/3D/GLINCS_Connectors/S6B-XH-A.STEP

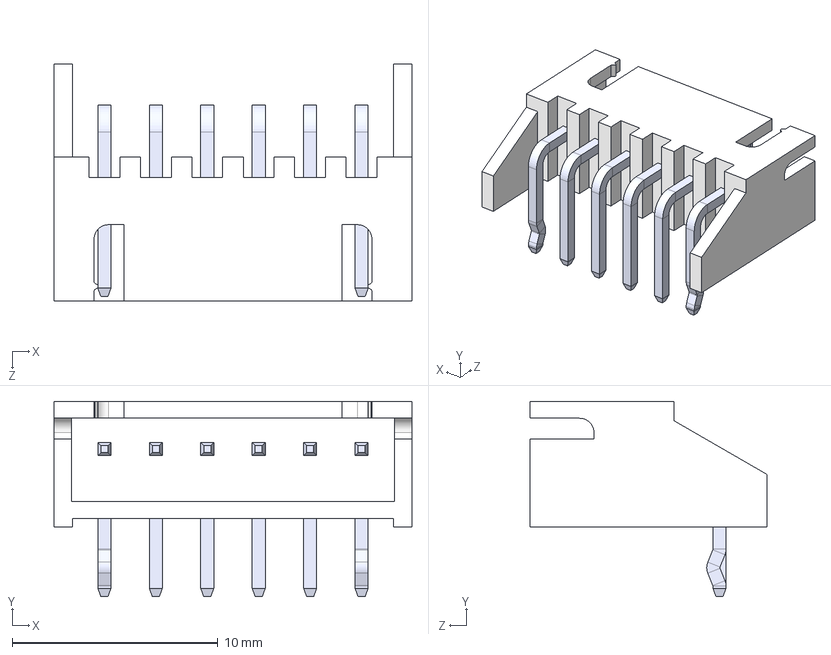
[picture p57: CAD file, 2025-09-26]
3D/GLINCS_Connectors/S6B-XH-A.STEP
17.4 x 9.50 x 11.5 mm
SxB-XH-A_6
pin^SxB-XH-A ass_bent x 2
pin^SxB-XH-A ass x 4
