TheTrueTom/GLINCS-KiCAD-Libraries/3D/GLINCS/SOT-23-5_MC_MCH.step

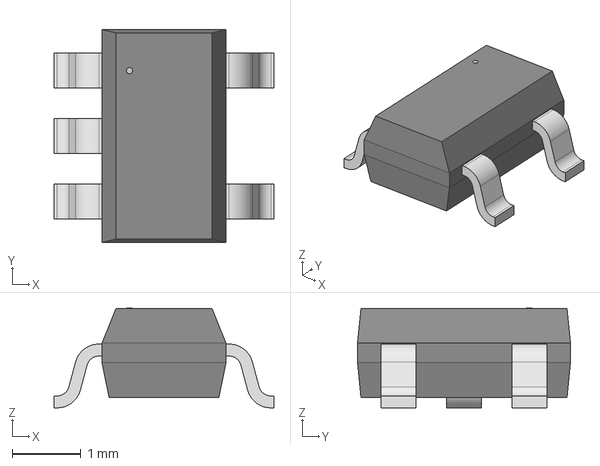
[picture p58: CAD file, 2025-09-26]
3D/GLINCS/SOT-23-5_MC_MCH.step
3.20 x 3.10 x 1.45 mm
