TheTrueTom/GLINCS-KiCAD-Libraries/3D/GLINCS_Connectors/Sans titre.stp

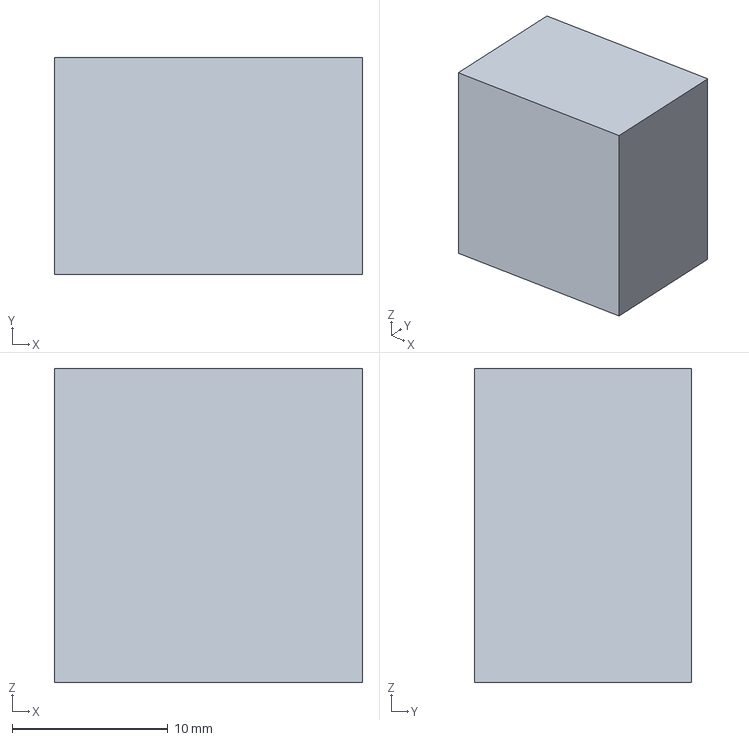
[picture p59: CAD file, 2025-09-26]
3D/GLINCS_Connectors/Sans titre.stp
19.8 x 14.0 x 20.2 mm
