TheTrueTom/GLINCS-KiCAD-Libraries/3D/GLINCS/LGA.stp

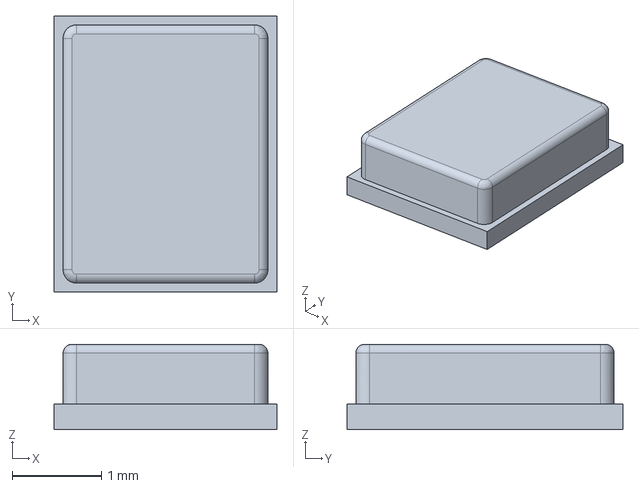
[picture p60: CAD file, 2025-09-26]
3D/GLINCS/LGA.stp
2.50 x 3.10 x 0.96 mm
