TheTrueTom/GLINCS-KiCAD-Libraries/3D/GLINCS_Connectors/SM02B-SRSS-TB.step

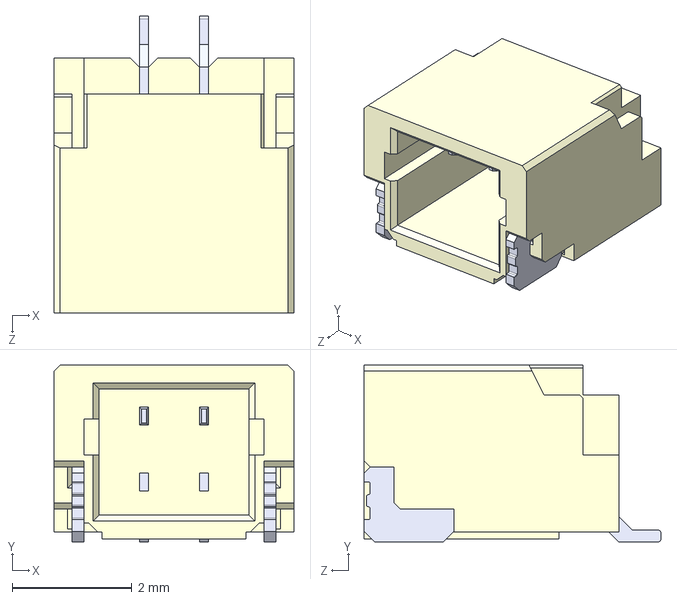
[picture p61: CAD file, 2025-09-26]
3D/GLINCS_Connectors/SM02B-SRSS-TB.step
4.00 x 2.95 x 4.95 mm
