TheTrueTom/GLINCS-KiCAD-Libraries/3D/GLINCS/820M1-0100.stp

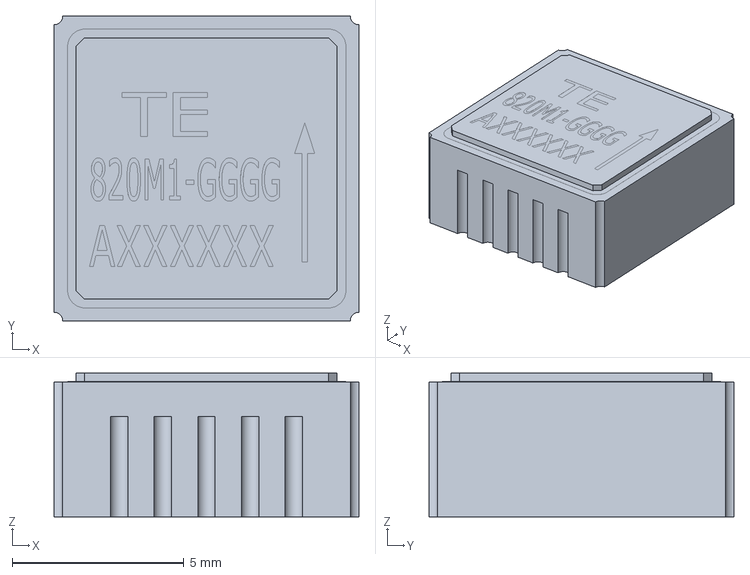
[picture p62: CAD file, 2025-09-26]
3D/GLINCS/820M1-0100.stp
8.89 x 8.89 x 4.20 mm
