TheTrueTom/GLINCS-KiCAD-Libraries/3D/GLINCS_Connectors/70AAJ-4-MO.stp

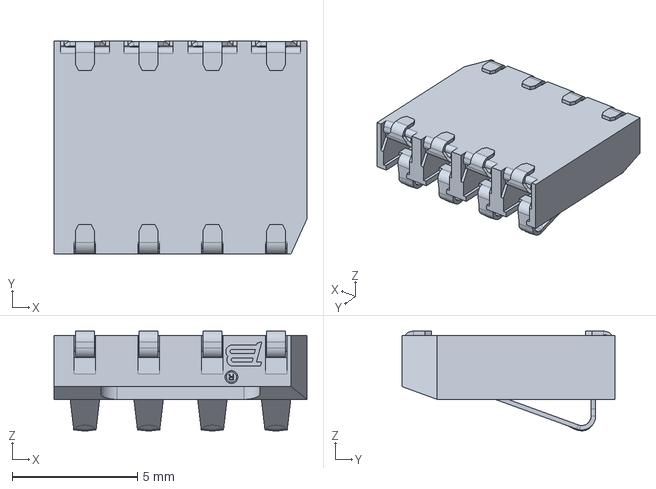
[picture p63: CAD file, 2025-09-26]
3D/GLINCS_Connectors/70AAJ-4-MO.stp
10.1 x 8.48 x 3.97 mm
