TheTrueTom/GLINCS-KiCAD-Libraries/3D/GLINCS/QFN-16_UD_LIT.step

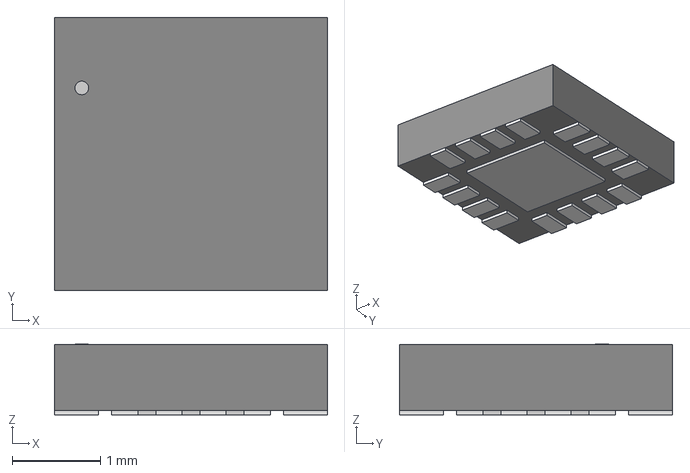
[picture p64: CAD file, 2025-09-26]
3D/GLINCS/QFN-16_UD_LIT.step
3.10 x 3.10 x 0.803 mm
