TheTrueTom/GLINCS-KiCAD-Libraries/3D/GLINCS/T1_34.STEP

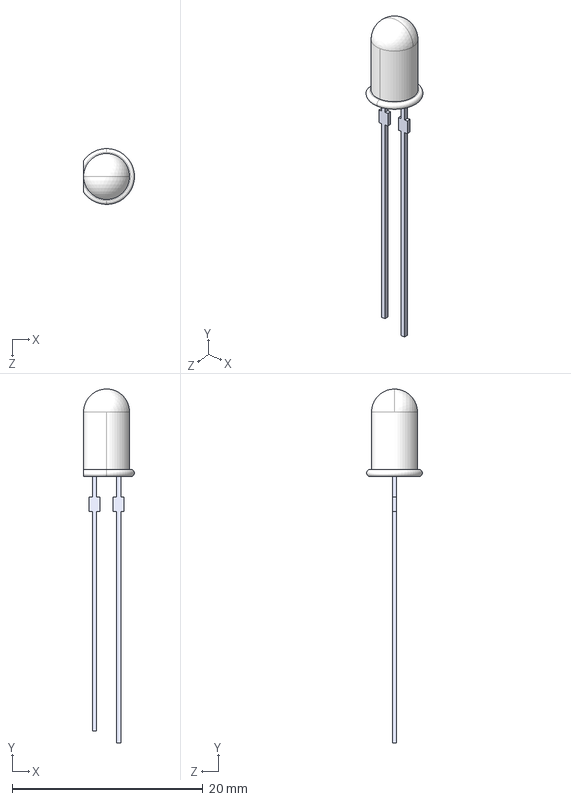
[picture p66: CAD file, 2025-09-26]
3D/GLINCS/T1_34.STEP
5.34 x 37.1 x 5.85 mm
