TheTrueTom/GLINCS-KiCAD-Libraries/3D/GLINCS_Connectors/orange3.stp

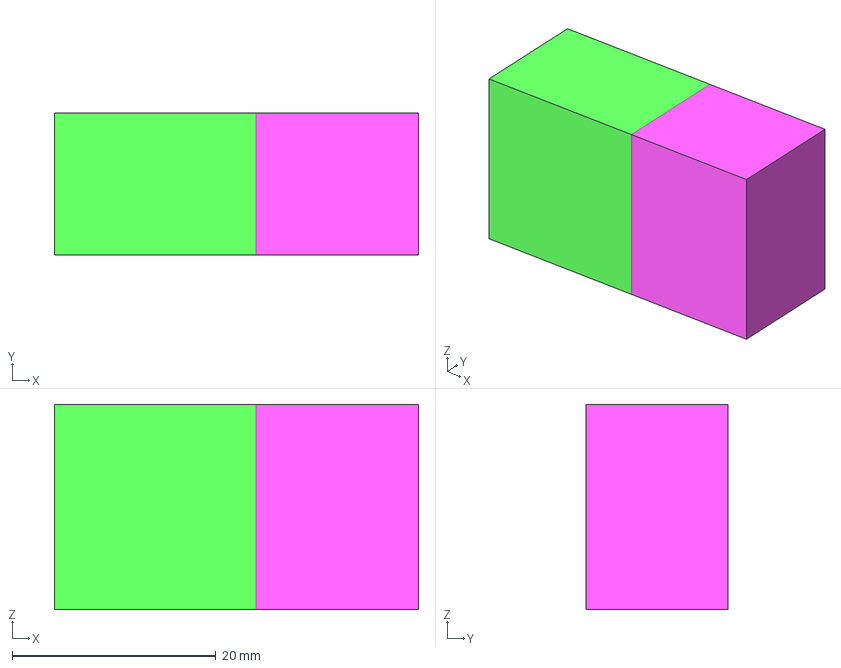
[picture p67: CAD file, 2025-09-26]
3D/GLINCS_Connectors/orange3.stp
35.8 x 14.0 x 20.2 mm
