TheTrueTom/GLINCS-KiCAD-Libraries/3D/GLINCS/TMC5130-BOB.stp

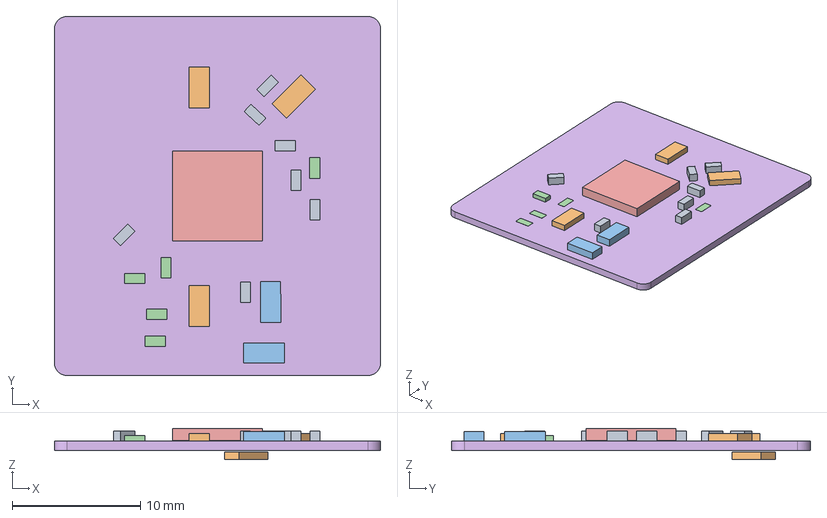
[picture p68: CAD file, 2023-06-19]
3D/GLINCS/TMC5130-BOB.stp
25.4 x 27.9 x 2.44 mm
