TheTrueTom/GLINCS-KiCAD-Libraries/3D/GLINCS_Connectors/S4B-PH-SM4-TB.STEP

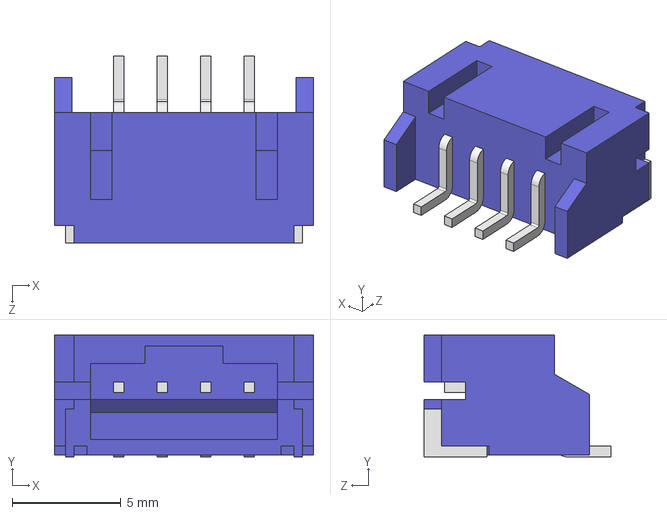
[picture p69: CAD file, 2025-09-26]
3D/GLINCS_Connectors/S4B-PH-SM4-TB.STEP
11.9 x 5.60 x 8.60 mm
