TheTrueTom/GLINCS-KiCAD-Libraries/3D/GLINCS/PW0014A.stp

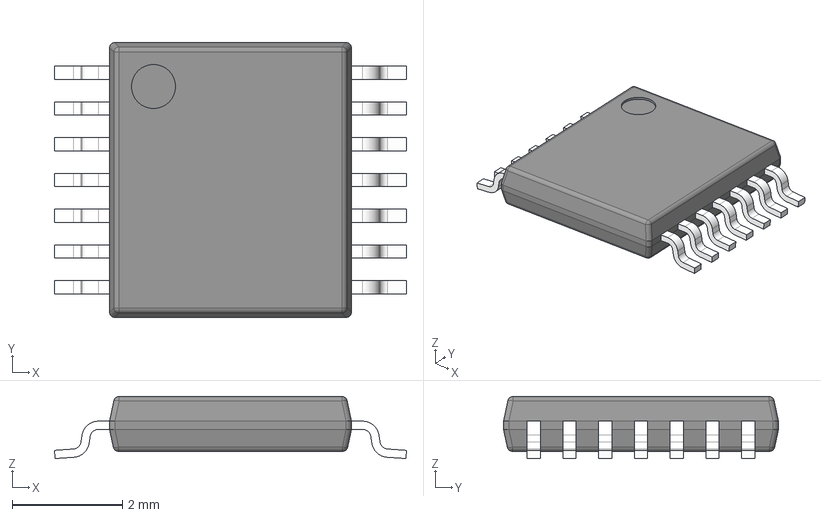
[picture p70: CAD file, 2023-06-19]
3D/GLINCS/PW0014A.stp
6.40 x 5.00 x 1.13 mm
BODY-TSSOP
LEAD-TSSOP x 14
PIN1
