TheTrueTom/GLINCS-KiCAD-Libraries/3D/GLINCS/DW0024B.stp

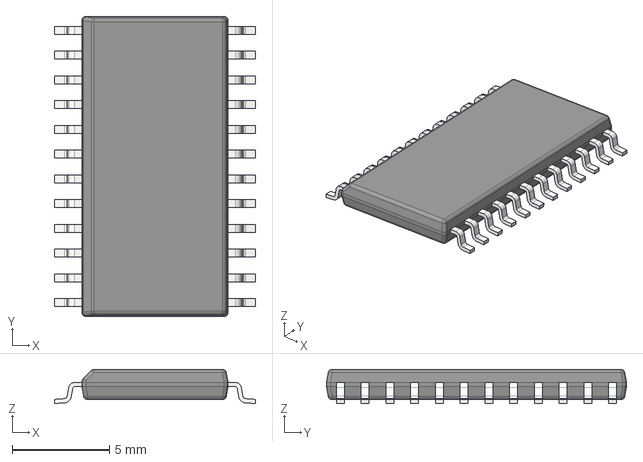
[picture p71: CAD file, 2023-06-19]
3D/GLINCS/DW0024B.stp
10.3 x 15.4 x 1.75 mm
BODY-SO
LEAD-SO x 24
