TheTrueTom/GLINCS-KiCAD-Libraries/3D/GLINCS/TSOT-23-6_D6_MCH.step

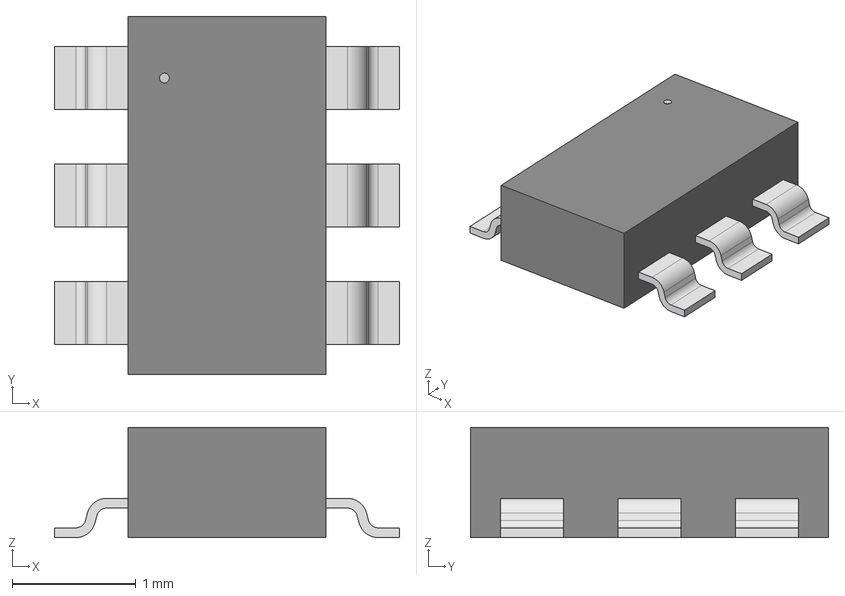
[picture p72: CAD file, 2023-04-24]
3D/GLINCS/TSOT-23-6_D6_MCH.step
2.79 x 2.90 x 0.892 mm
