TheTrueTom/GLINCS-KiCAD-Libraries/3D/GLINCS_Connectors/BM02B-SRSS-TB_LF__SN_.step

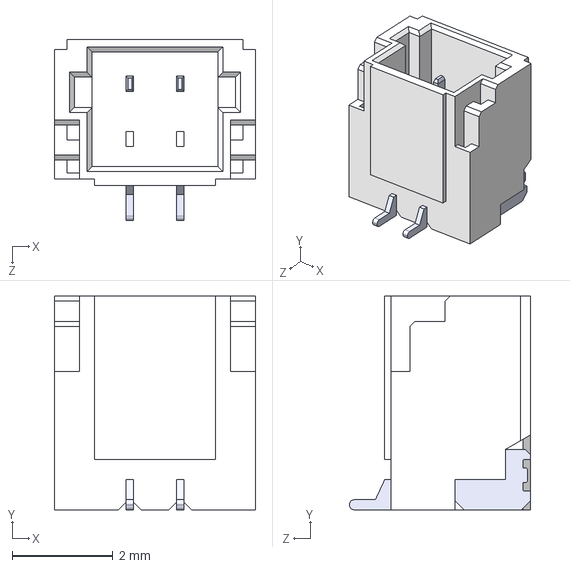
[picture p73: CAD file, 2025-09-26]
3D/GLINCS_Connectors/BM02B-SRSS-TB_LF__SN_.step
4.00 x 4.25 x 3.60 mm
