TheTrueTom/GLINCS-KiCAD-Libraries/3D/GLINCS/RS3_RCP.step

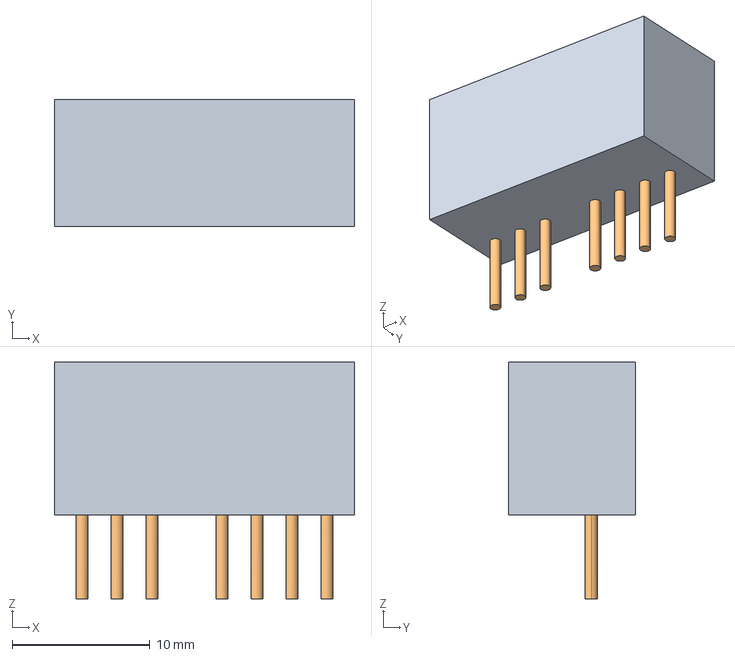
[picture p74: CAD file, 2023-04-24]
3D/GLINCS/RS3_RCP.step
21.8 x 9.19 x 17.2 mm
