TheTrueTom/GLINCS-KiCAD-Libraries/3D/GLINCS/THN-2030-2425WIR.STEP

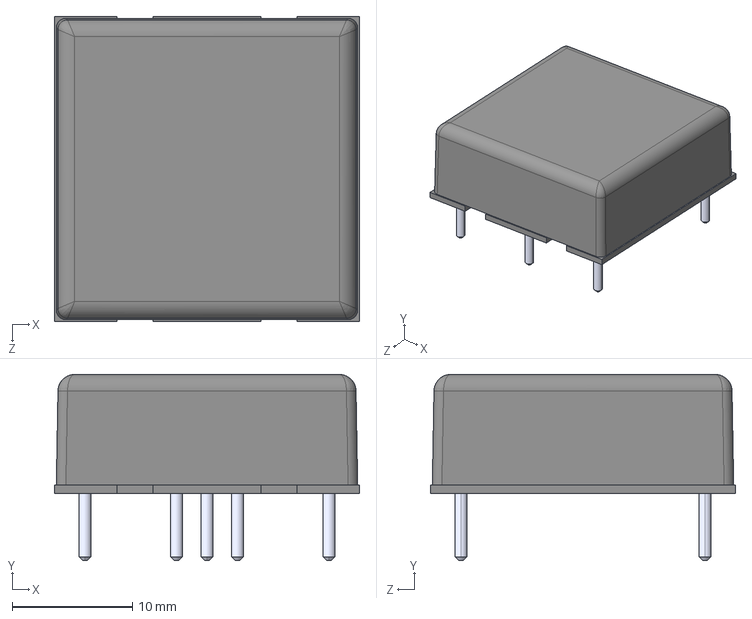
[picture p75: CAD file, 2023-04-24]
3D/GLINCS/THN-2030-2425WIR.STEP
25.4 x 15.5 x 25.4 mm
