TheTrueTom/GLINCS-KiCAD-Libraries/3D/GLINCS_Connectors/BM03B-SRSS-TB.STEP

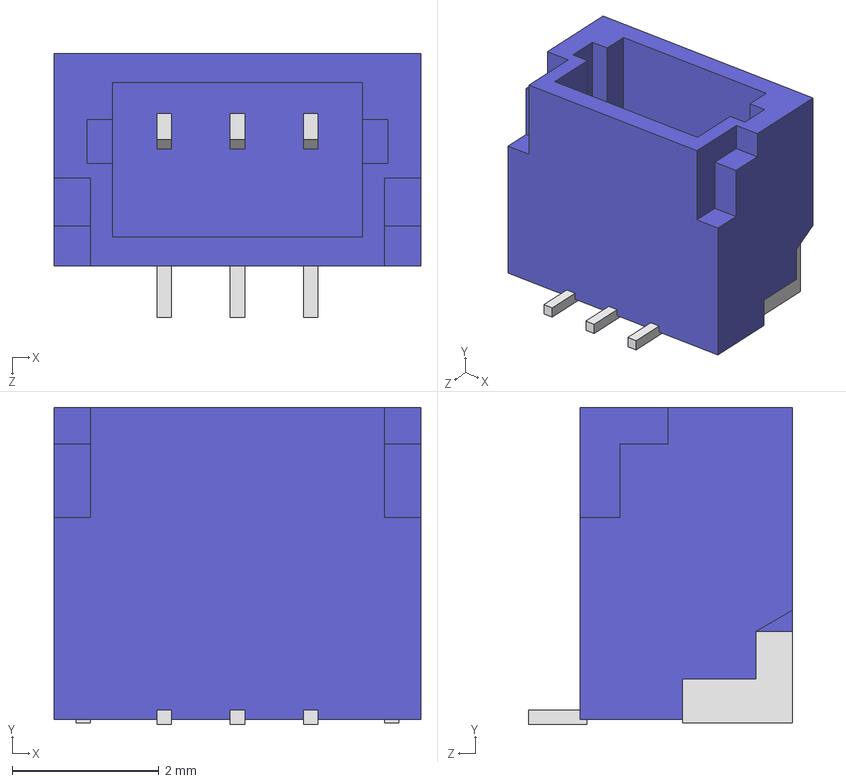
[picture p76: CAD file, 2025-09-26]
3D/GLINCS_Connectors/BM03B-SRSS-TB.STEP
5.00 x 4.32 x 3.60 mm
