TheTrueTom/GLINCS-KiCAD-Libraries/3D/GLINCS/SSOP-16_GN_LIT.step

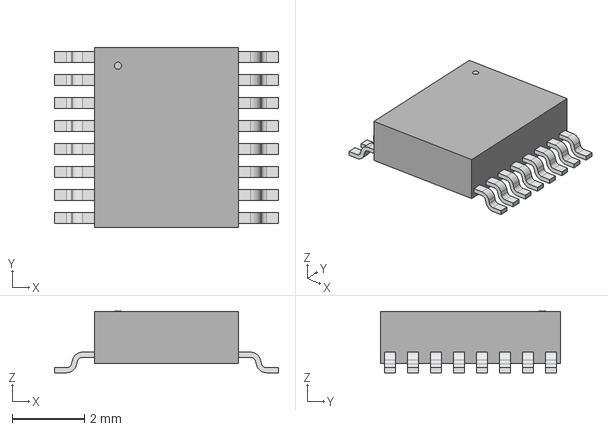
[picture p77: CAD file, 2023-04-24]
3D/GLINCS/SSOP-16_GN_LIT.step
6.20 x 4.98 x 1.70 mm
