TheTrueTom/GLINCS-KiCAD-Libraries/3D/GLINCS_Connectors/70AAJ-4-F0.stp

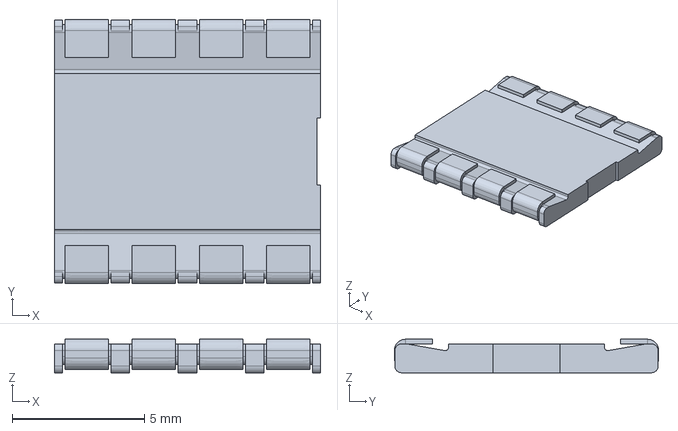
[picture p78: CAD file, 2025-09-26]
3D/GLINCS_Connectors/70AAJ-4-F0.stp
10.1 x 10.00 x 1.27 mm
