TheTrueTom/GLINCS-KiCAD-Libraries/3D/GLINCS/R0.25D-053.3.step

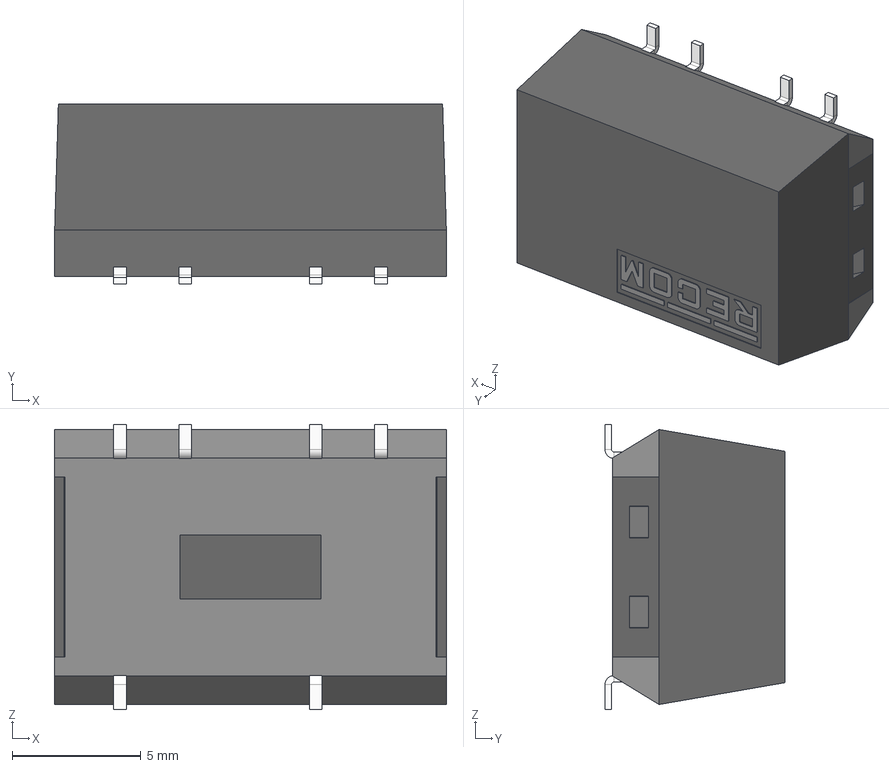
[picture p79: CAD file, 2023-04-24]
3D/GLINCS/R0.25D-053.3.step
15.2 x 7.00 x 11.1 mm
