TheTrueTom/GLINCS-KiCAD-Libraries/3D/GLINCS/IND_TCK-097_TRP.step

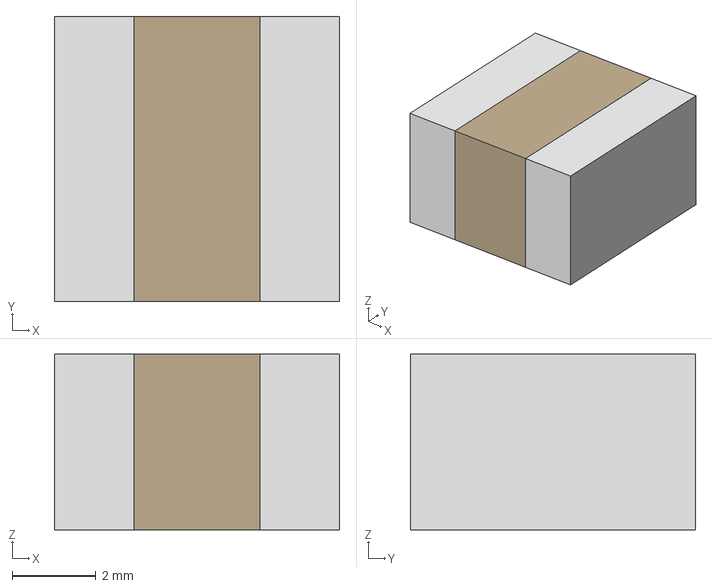
[picture p80: CAD file, 2023-04-24]
3D/GLINCS/IND_TCK-097_TRP.step
6.81 x 6.81 x 4.20 mm
