TheTrueTom/GLINCS-KiCAD-Libraries/3D/GLINCS_Connectors/USB4125-GF-A.stp

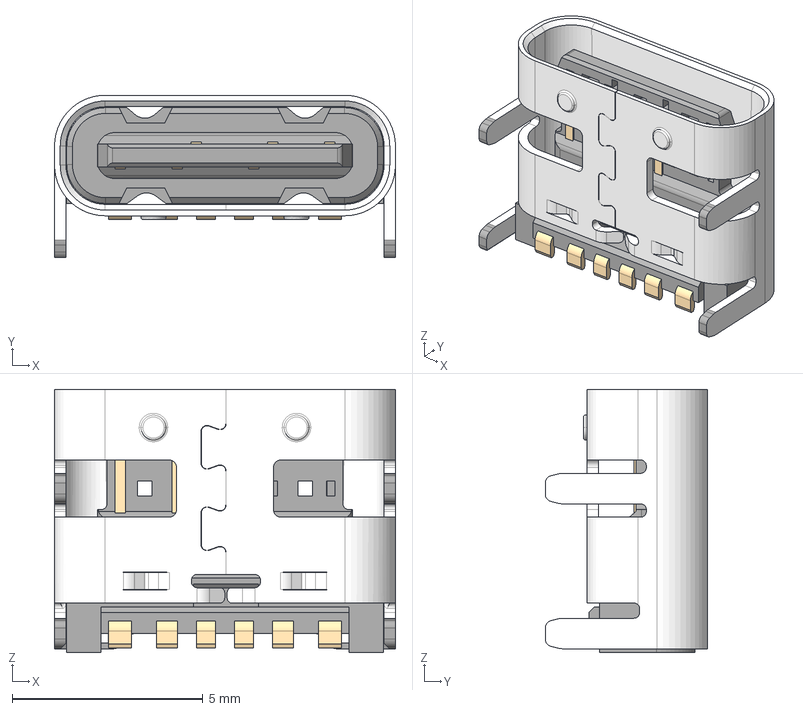
[picture p81: CAD file, 2025-09-26]
3D/GLINCS_Connectors/USB4125-GF-A.stp
8.94 x 4.26 x 6.90 mm
