TheTrueTom/GLINCS-KiCAD-Libraries/3D/GLINCS/LED_PA01_PLL.step

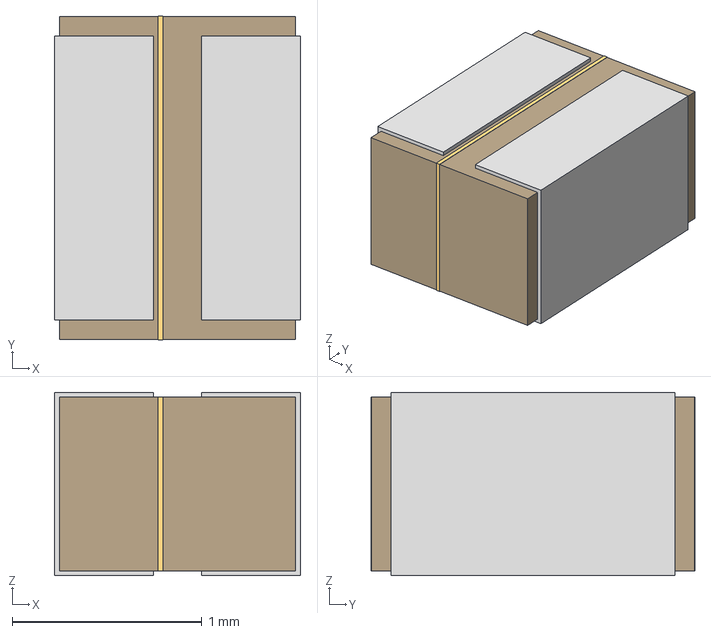
[picture p82: CAD file, 2022-11-09]
3D/GLINCS/LED_PA01_PLL.step
1.30 x 1.71 x 0.965 mm
