TheTrueTom/GLINCS-KiCAD-Libraries/3D/GLINCS_Connectors/SW4POS.stp

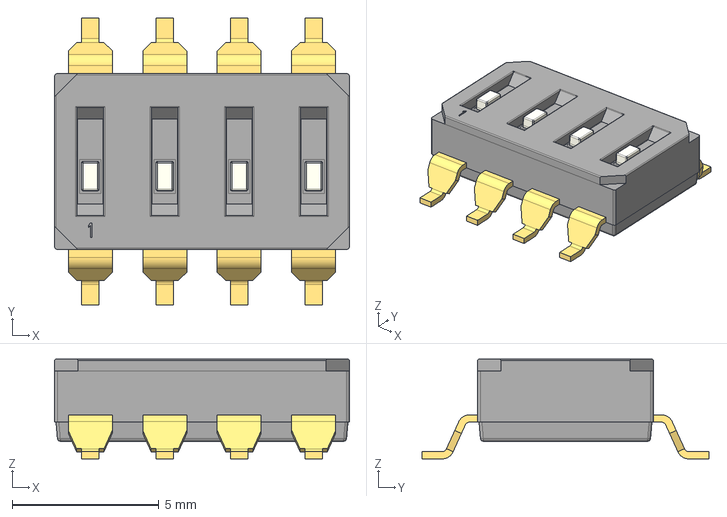
[picture p83: CAD file, 2025-09-26]
3D/GLINCS_Connectors/SW4POS.stp
10.1 x 9.80 x 3.40 mm
