TheTrueTom/GLINCS-KiCAD-Libraries/3D/GLINCS/LED_APT1608_KNB.step

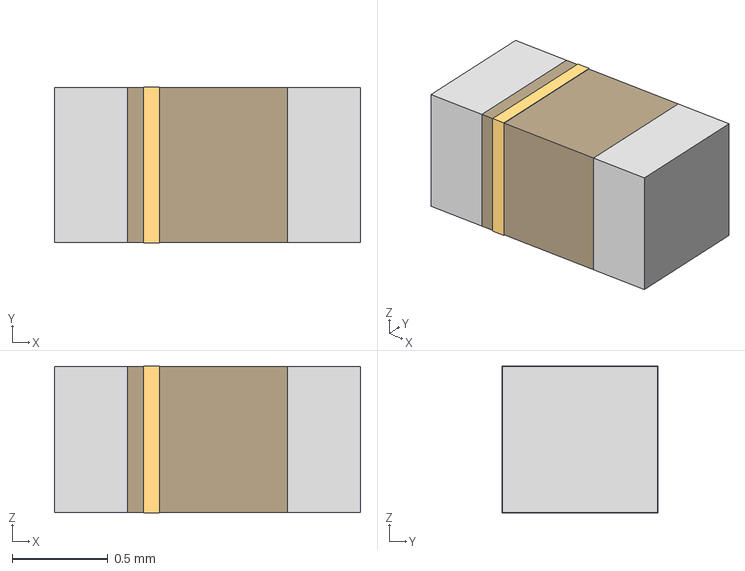
[picture p84: CAD file, 2022-11-09]
3D/GLINCS/LED_APT1608_KNB.step
1.60 x 0.818 x 0.768 mm
