TheTrueTom/GLINCS-KiCAD-Libraries/3D/GLINCS_Connectors/TSM-104-01-L-SV-P-TR.step

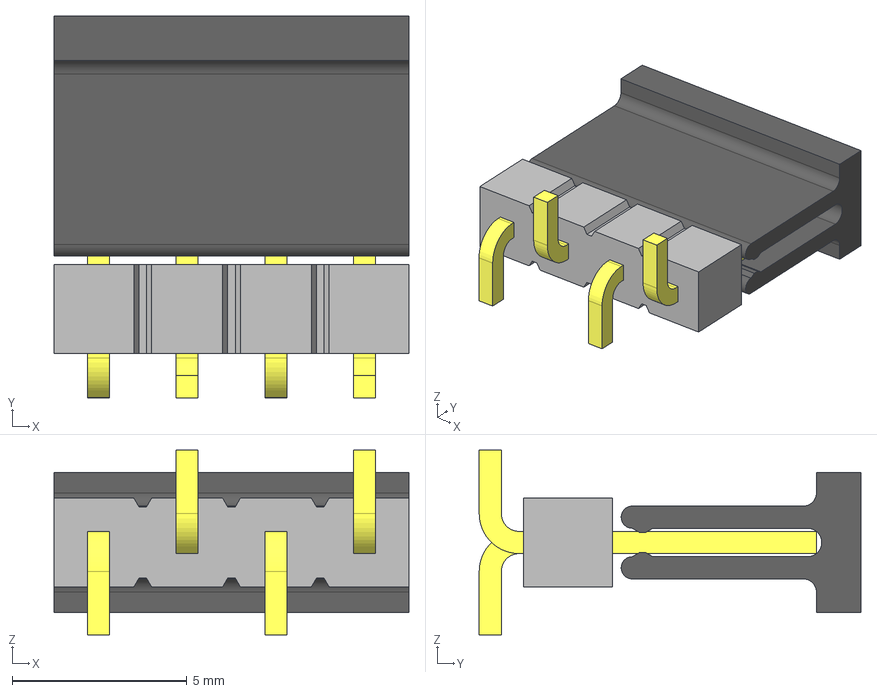
[picture p85: CAD file, 2025-09-26]
3D/GLINCS_Connectors/TSM-104-01-L-SV-P-TR.step
10.2 x 10.9 x 5.28 mm
T-1S6-16(-01-4-SV)
PPP-07-01-4--SV
TSM-104-01-SV_body
