TheTrueTom/GLINCS-KiCAD-Libraries/3D/GLINCS/DBV0005A.stp

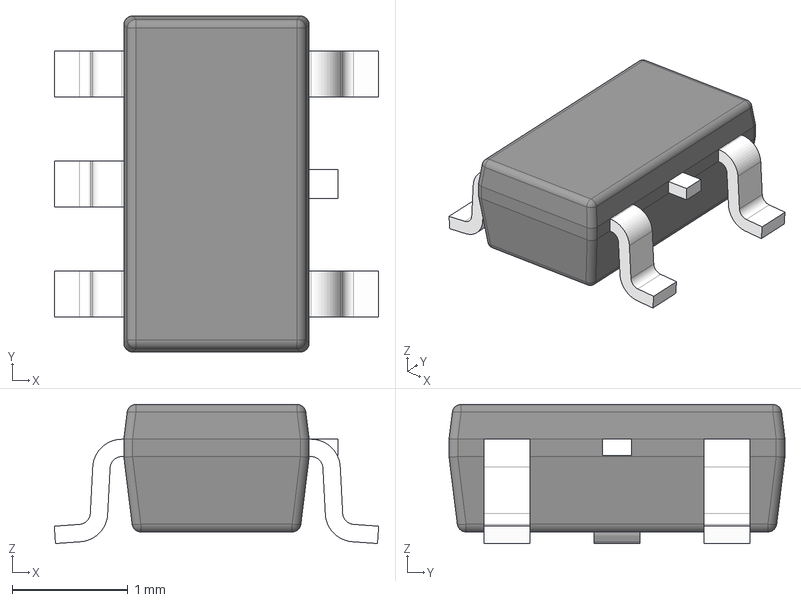
[picture p86: CAD file, 2022-11-09]
3D/GLINCS/DBV0005A.stp
2.80 x 2.90 x 1.20 mm
BODY-SOT
LEAD-SOT x 5
LEAD-DUMMY
