TheTrueTom/GLINCS-KiCAD-Libraries/3D/GLINCS_Connectors/S2B-ZR-SM4A-TF.step

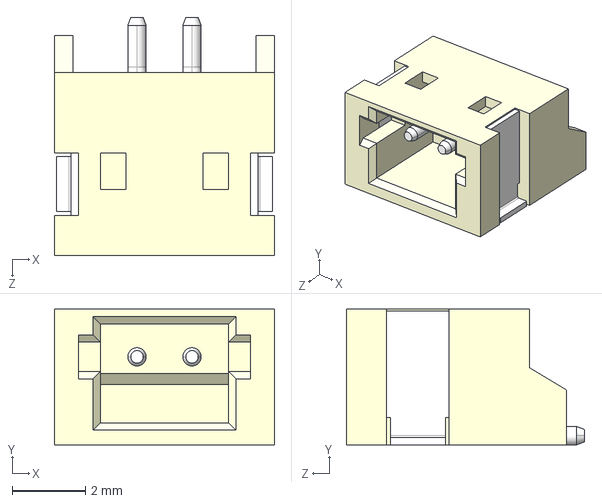
[picture p87: CAD file, 2025-09-26]
3D/GLINCS_Connectors/S2B-ZR-SM4A-TF.step
6.00 x 3.70 x 6.50 mm
