TheTrueTom/GLINCS-KiCAD-Libraries/3D/GLINCS/CAP_1206.step

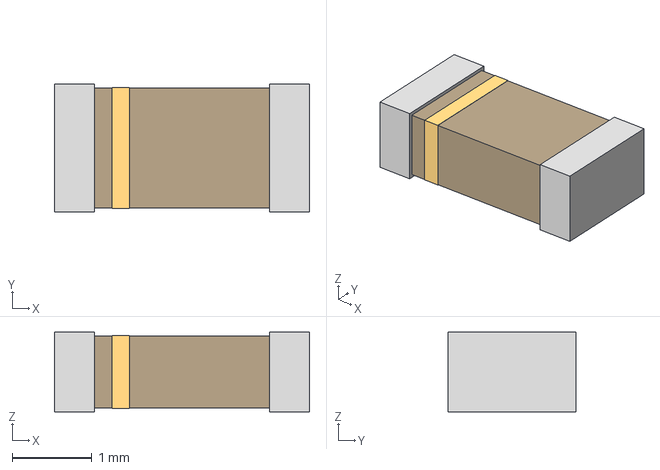
[picture p88: CAD file, 2022-11-09]
3D/GLINCS/CAP_1206.step
3.20 x 1.60 x 1.00 mm
