TheTrueTom/GLINCS-KiCAD-Libraries/3D/GLINCS_Connectors/B12B-PH-SM4-TB.STEP

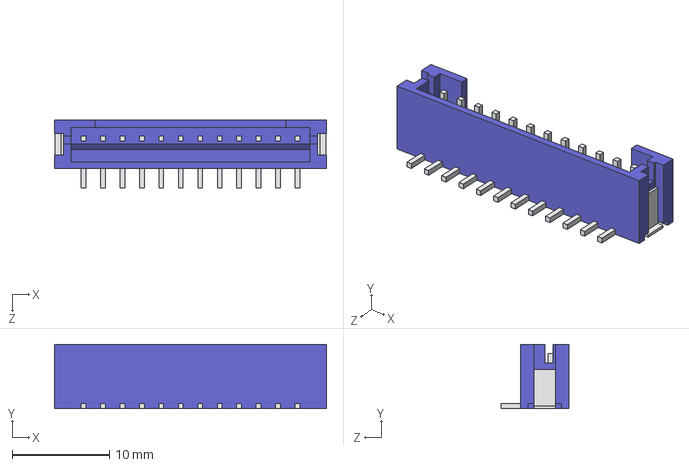
[picture p89: CAD file, 2025-09-26]
3D/GLINCS_Connectors/B12B-PH-SM4-TB.STEP
28.0 x 6.60 x 7.00 mm
