TheTrueTom/GLINCS-KiCAD-Libraries/3D/GLINCS/R_8_ADI.step

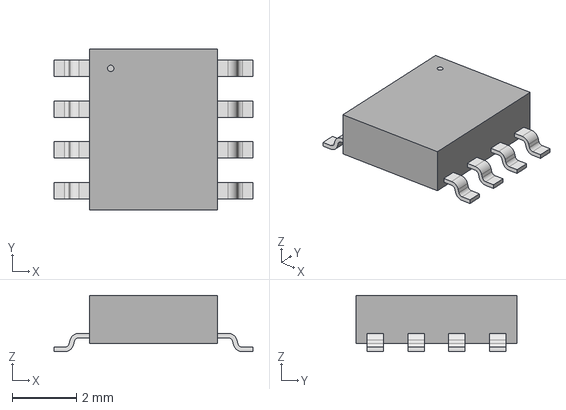
[picture p90: CAD file, 2022-11-09]
3D/GLINCS/R_8_ADI.step
6.20 x 5.00 x 1.75 mm
