TheTrueTom/GLINCS-KiCAD-Libraries/3D/GLINCS/LXZ1-PR01 with reflector.stp

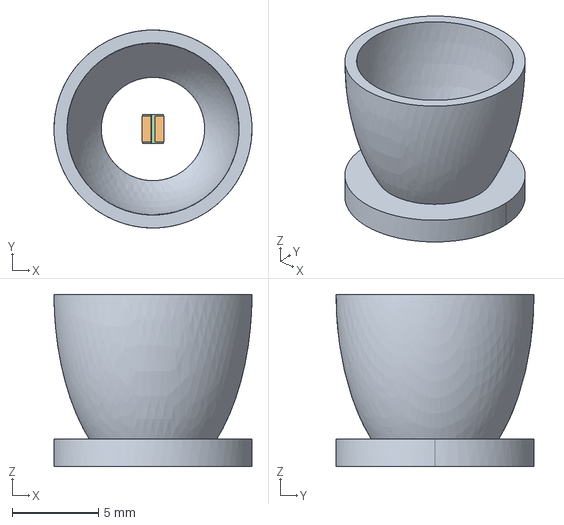
[picture p91: CAD file, 2022-11-09]
3D/GLINCS/LXZ1-PR01 with reflector.stp
11.5 x 11.5 x 10.0 mm
