TheTrueTom/GLINCS-KiCAD-Libraries/3D/GLINCS/IRFZ34PBF.stp

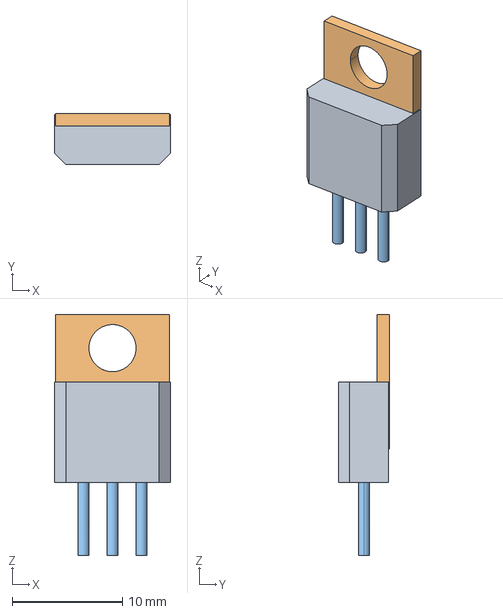
[picture p92: CAD file, 2022-11-09]
3D/GLINCS/IRFZ34PBF.stp
10.5 x 4.65 x 21.8 mm
