TheTrueTom/GLINCS-KiCAD-Libraries/3D/GLINCS/RCD-24.stp

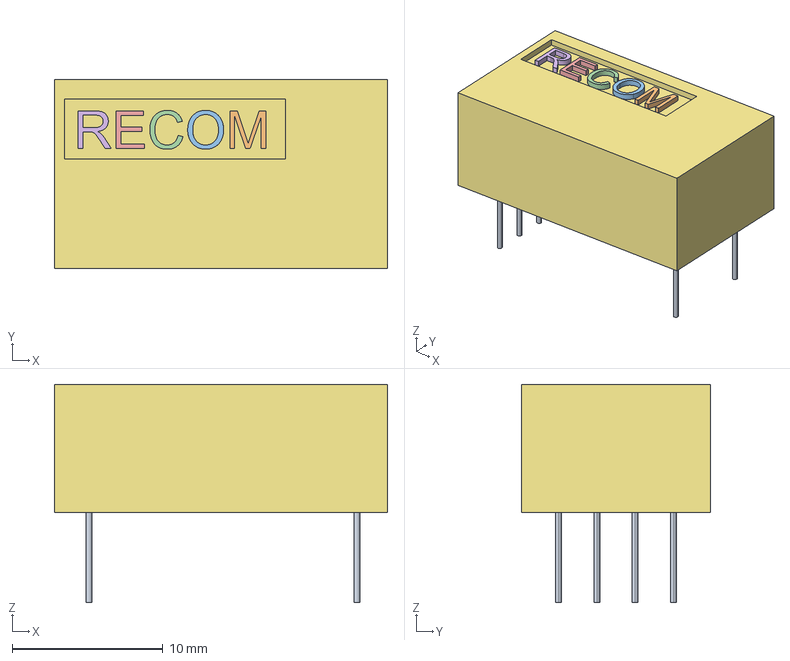
[picture p93: CAD file, 2022-11-09]
3D/GLINCS/RCD-24.stp
22.1 x 12.6 x 14.5 mm
