TheTrueTom/GLINCS-KiCAD-Libraries/3D/GLINCS/ptr901.stp

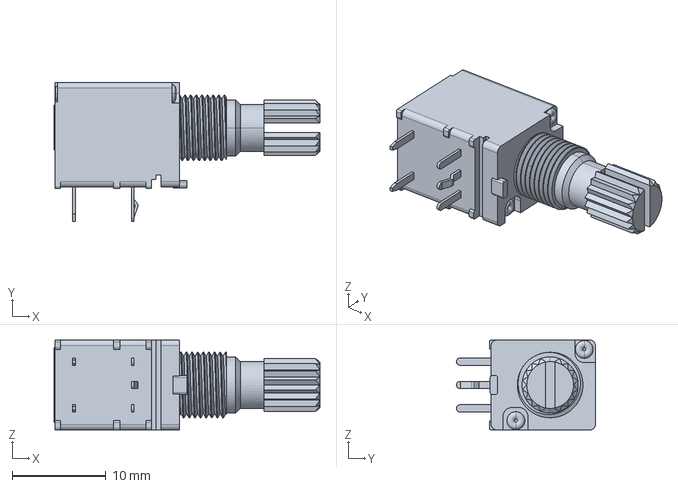
[picture p94: CAD file, 2022-11-09]
3D/GLINCS/ptr901.stp
28.4 x 14.9 x 9.60 mm
