TheTrueTom/GLINCS-KiCAD-Libraries/3D/GLINCS_Connectors/813-S1-004-10-014101.stp

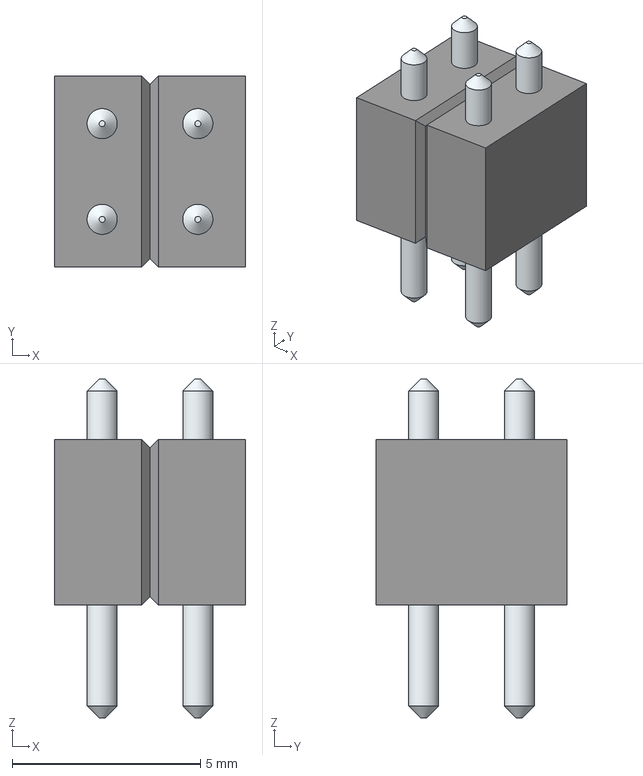
[picture p95: CAD file, 2025-09-26]
3D/GLINCS_Connectors/813-S1-004-10-014101.stp
5.08 x 5.08 x 9.00 mm
LeadsArray
