TheTrueTom/GLINCS-KiCAD-Libraries/3D/GLINCS/TO-236_VIS.step

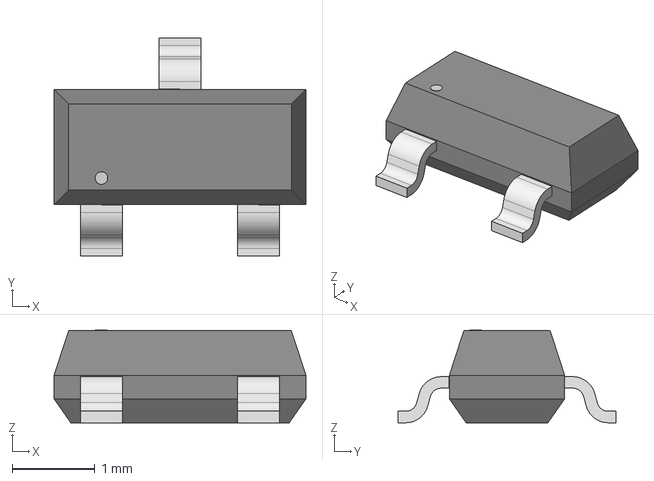
[picture p96: CAD file, 2022-11-09]
3D/GLINCS/TO-236_VIS.step
3.05 x 2.64 x 1.12 mm
