TheTrueTom/GLINCS-KiCAD-Libraries/3D/GLINCS/Relay_Module.stp

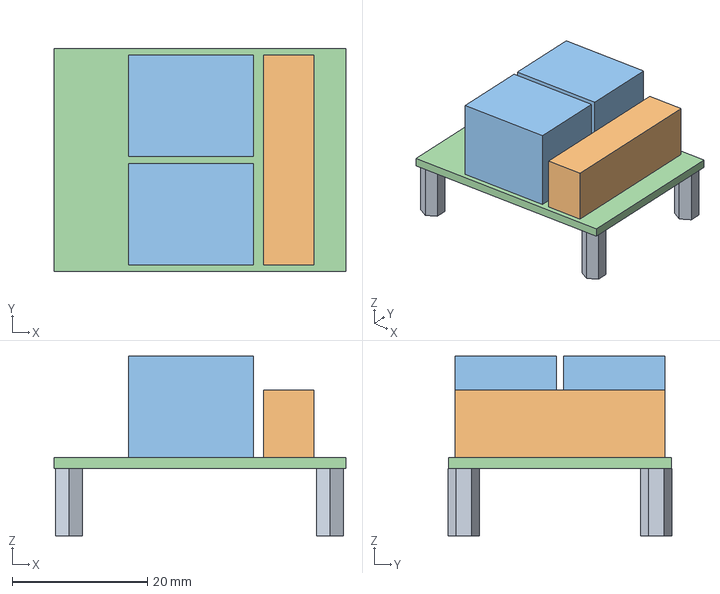
[picture p97: CAD file, 2022-04-06]
3D/GLINCS/Relay_Module.stp
43.2 x 33.1 x 26.6 mm
