TheTrueTom/GLINCS-KiCAD-Libraries/3D/GLINCS_Connectors/POGO receptacle.stp

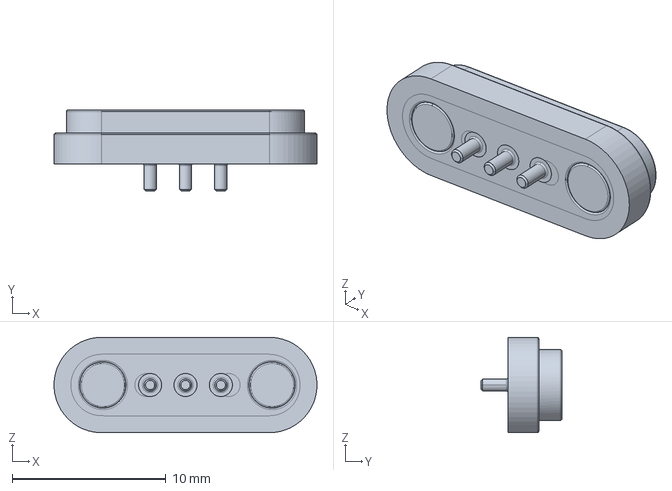
[picture p98: CAD file, 2025-09-26]
3D/GLINCS_Connectors/POGO receptacle.stp
17.1 x 5.25 x 6.20 mm
