TheTrueTom/GLINCS-KiCAD-Libraries/3D/GLINCS/LTC1983-6.step

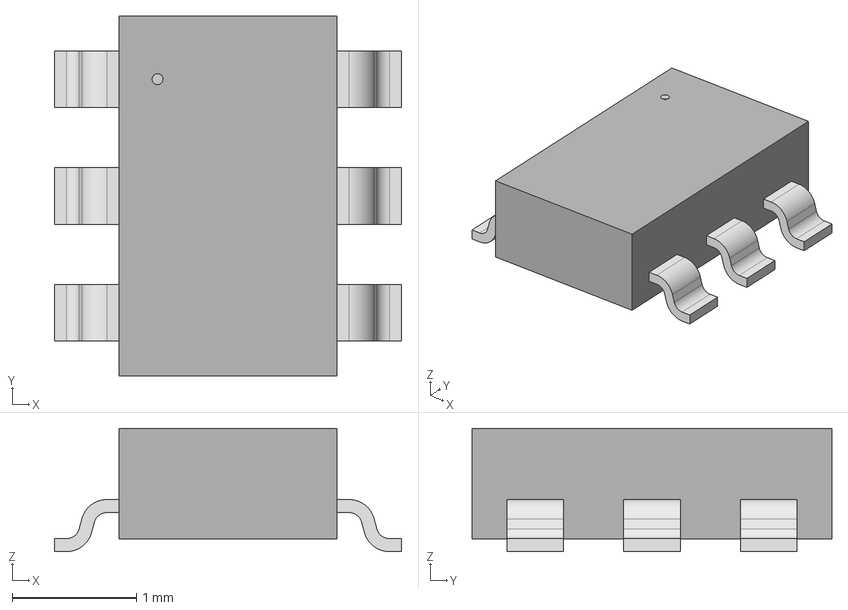
[picture p99: CAD file, 2022-04-06]
3D/GLINCS/LTC1983-6.step
2.79 x 2.90 x 0.993 mm
