TheTrueTom/GLINCS-KiCAD-Libraries/3D/GLINCS_Connectors/S2B-PH-SM4-TB.STEP

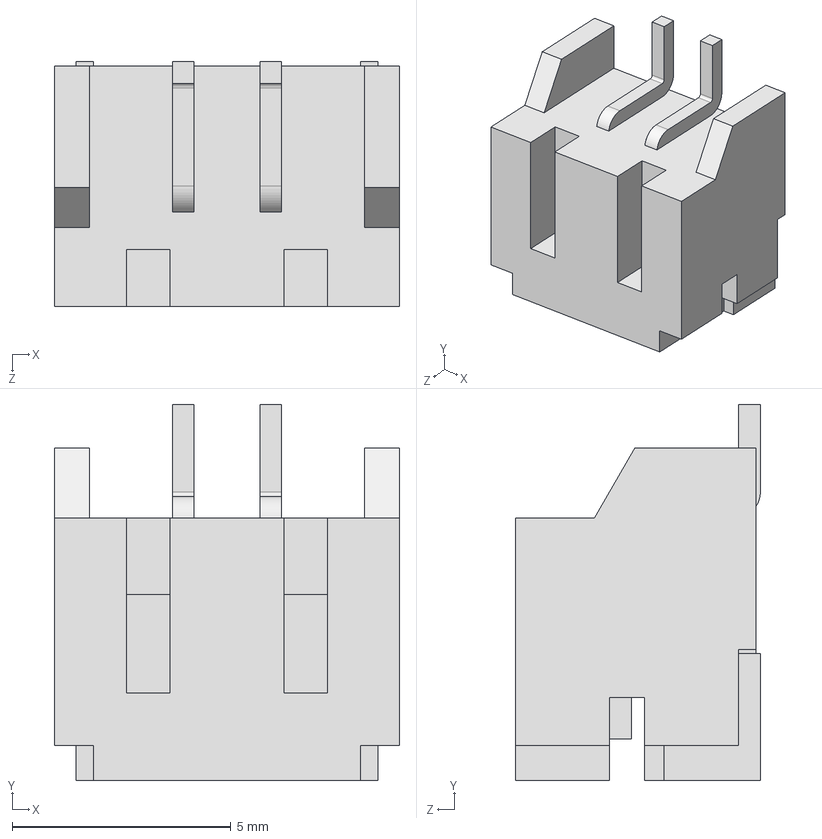
[picture p100: CAD file, 2025-09-26]
3D/GLINCS_Connectors/S2B-PH-SM4-TB.STEP
7.90 x 8.60 x 5.60 mm
