TheTrueTom/GLINCS-KiCAD-Libraries/3D/GLINCS/LED _3MM_RA.stp

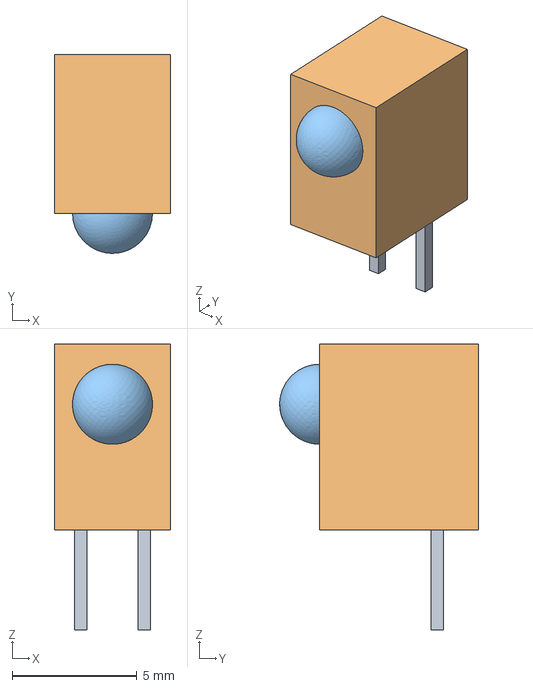
[picture p101: CAD file, 2021-11-29]
3D/GLINCS/LED _3MM_RA.stp
4.65 x 7.95 x 11.4 mm
