TheTrueTom/GLINCS-KiCAD-Libraries/3D/GLINCS_Connectors/B12B-PH-K-S.STEP

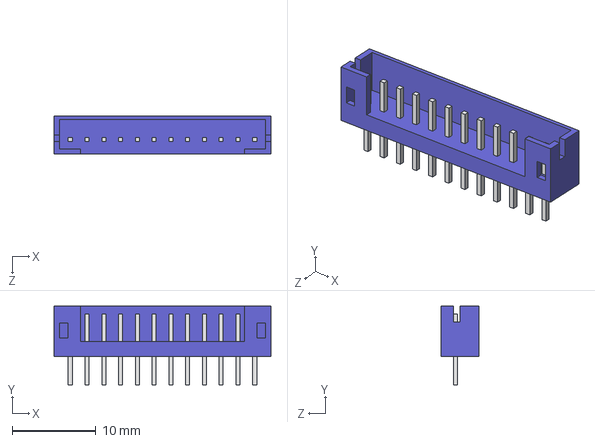
[picture p102: CAD file, 2025-09-26]
3D/GLINCS_Connectors/B12B-PH-K-S.STEP
25.9 x 9.40 x 4.50 mm
