TheTrueTom/GLINCS-KiCAD-Libraries/3D/GLINCS/TQFP44_10x10MC_MCH.step

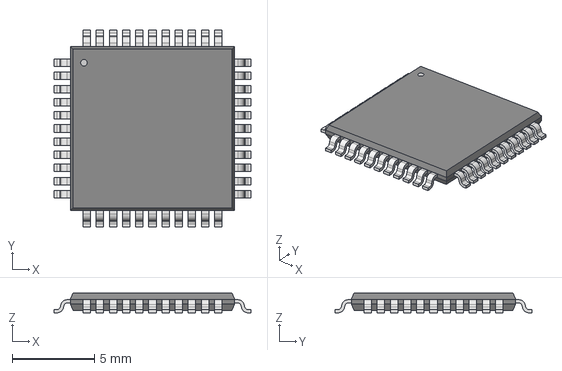
[picture p103: CAD file, 2021-10-29]
3D/GLINCS/TQFP44_10x10MC_MCH.step
12.0 x 12.0 x 1.20 mm
