TheTrueTom/GLINCS-KiCAD-Libraries/3D/GLINCS_Connectors/POGO pins.stp

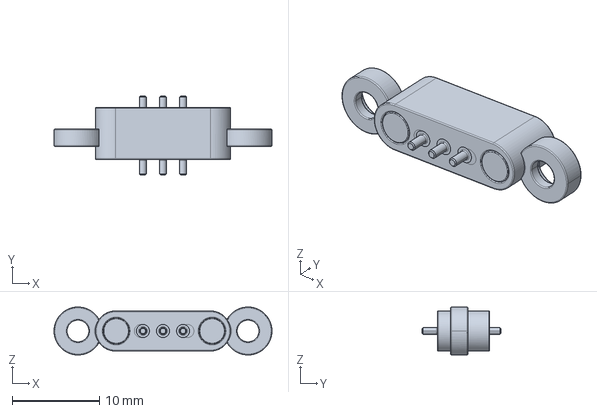
[picture p104: CAD file, 2025-09-26]
3D/GLINCS_Connectors/POGO pins.stp
25.0 x 9.02 x 5.50 mm
