TheTrueTom/GLINCS-KiCAD-Libraries/3D/GLINCS/ten40e_3d_drawing.stp

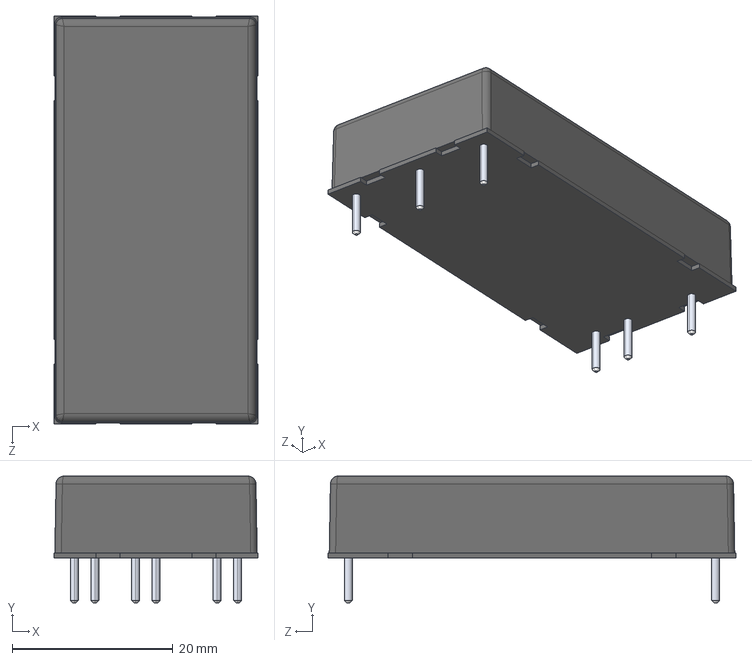
[picture p105: CAD file, 2021-10-29]
3D/GLINCS/ten40e_3d_drawing.stp
25.4 x 15.8 x 50.8 mm
