TheTrueTom/GLINCS-KiCAD-Libraries/3D/GLINCS_Connectors/S8B-PH-SM4-TB.STEP

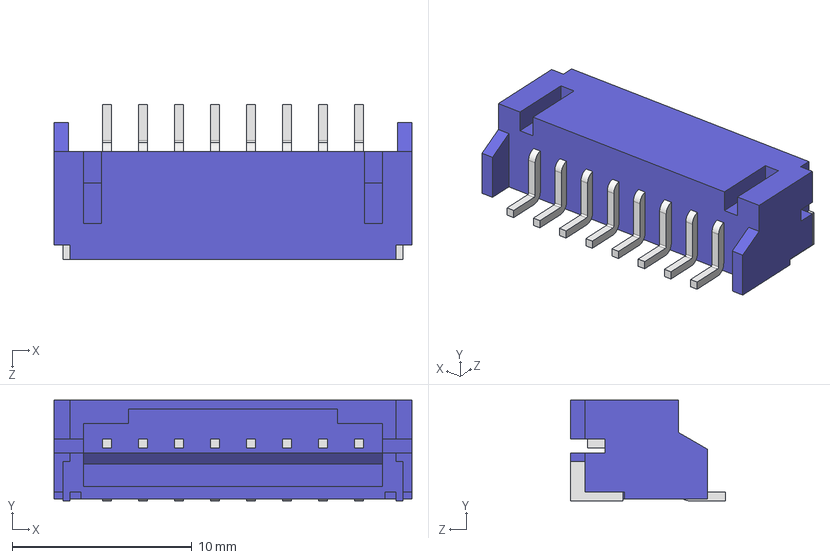
[picture p106: CAD file, 2023-06-19]
3D/GLINCS_Connectors/S8B-PH-SM4-TB.STEP
19.9 x 5.60 x 8.60 mm
