TheTrueTom/GLINCS-KiCAD-Libraries/3D/GLINCS/QFN-S28_6x6MC_MCH.step

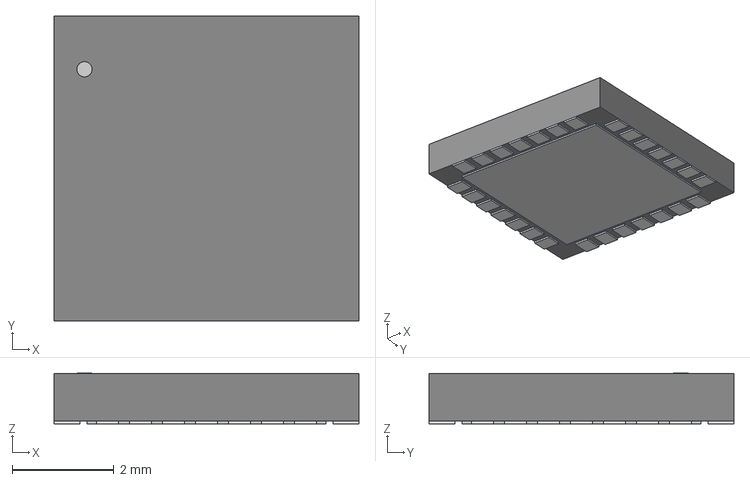
[picture p108: CAD file, 2021-10-21]
3D/GLINCS/QFN-S28_6x6MC_MCH.step
5.99 x 5.99 x 0.993 mm
