TheTrueTom/GLINCS-KiCAD-Libraries/3D/GLINCS_Connectors/B4B-PH-SM4-TB.STEP

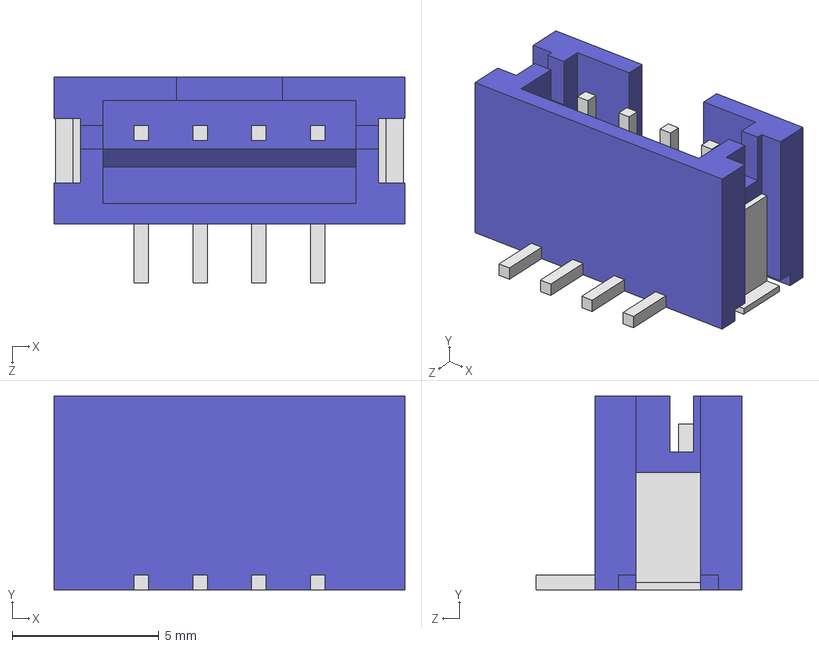
[picture p109: CAD file, 2023-06-19]
3D/GLINCS_Connectors/B4B-PH-SM4-TB.STEP
12.0 x 6.60 x 7.00 mm
