TheTrueTom/GLINCS-KiCAD-Libraries/3D/GLINCS/tmr4_3d_drawing.step

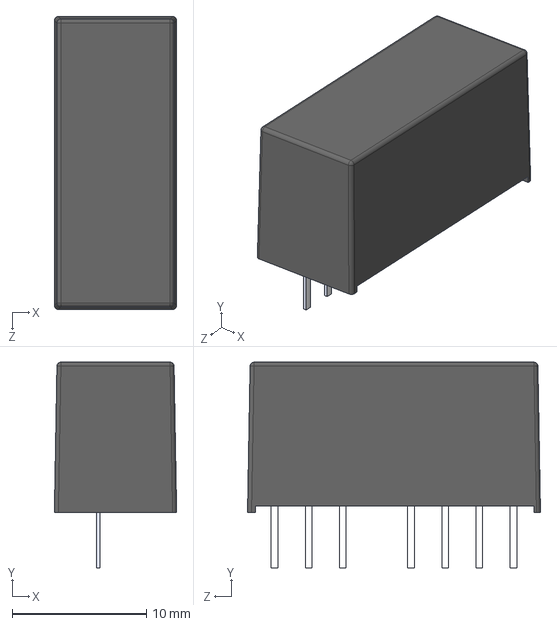
[picture p110: CAD file, 2021-05-18]
3D/GLINCS/tmr4_3d_drawing.step
9.10 x 15.3 x 21.8 mm
