TheTrueTom/GLINCS-KiCAD-Libraries/3D/GLINCS/S5160.stp

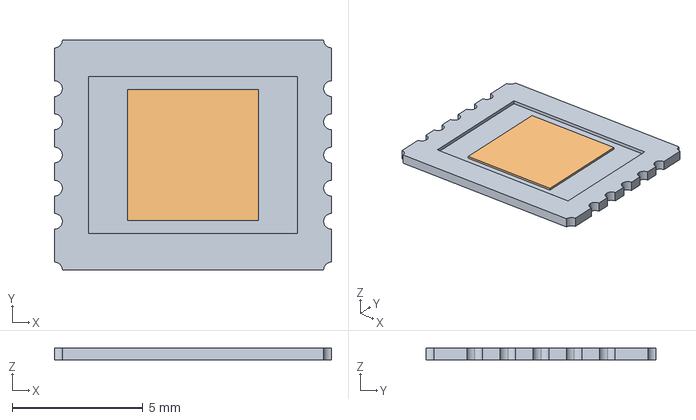
[picture p111: CAD file, 2021-05-18]
3D/GLINCS/S5160.stp
10.6 x 8.80 x 0.46 mm
