TheTrueTom/GLINCS-KiCAD-Libraries/3D/GLINCS_Connectors/Switch_2_pos.stp

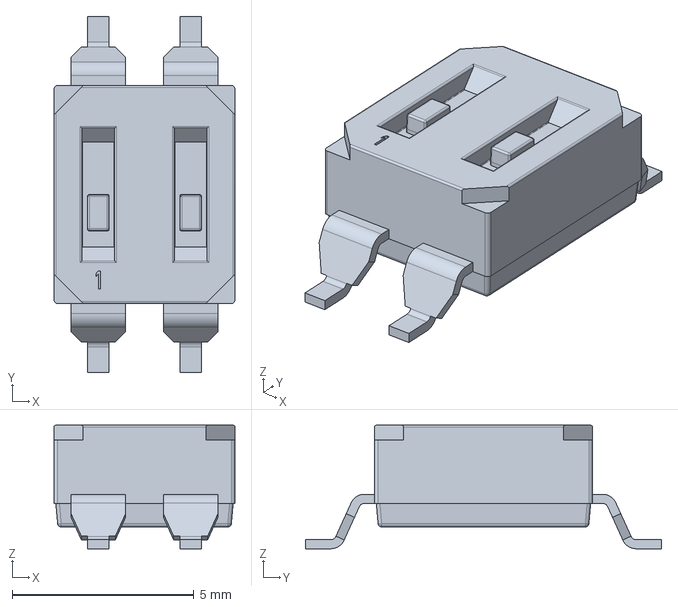
[picture p112: CAD file, 2022-04-06]
3D/GLINCS_Connectors/Switch_2_pos.stp
4.98 x 9.80 x 3.40 mm
