TheTrueTom/GLINCS-KiCAD-Libraries/3D/GLINCS/KS_6_ADI.step

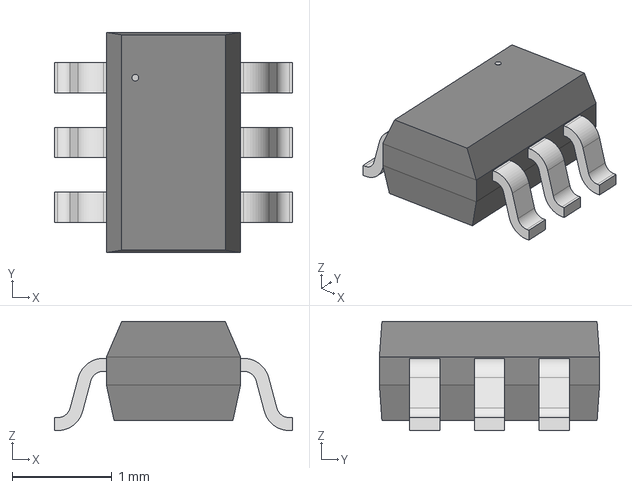
[picture p113: CAD file, 2021-05-18]
3D/GLINCS/KS_6_ADI.step
2.39 x 2.21 x 1.09 mm
