TheTrueTom/GLINCS-KiCAD-Libraries/3D/GLINCS_Connectors/HARTING_64_M.stp

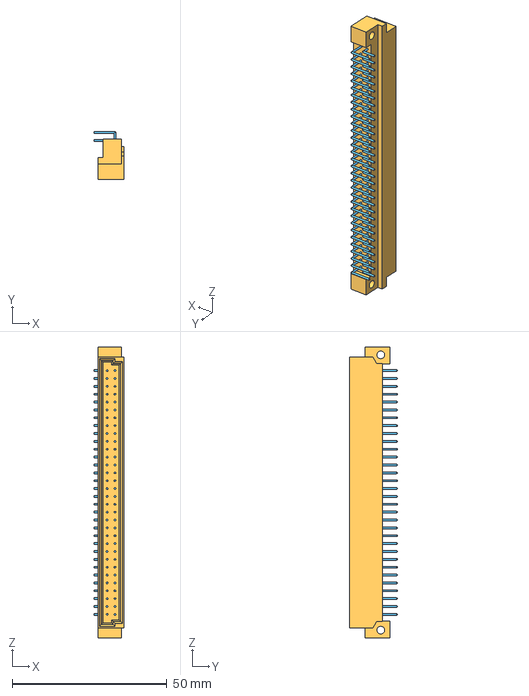
[picture p114: CAD file, 2021-11-29]
3D/GLINCS_Connectors/HARTING_64_M.stp
9.83 x 15.5 x 94.0 mm
