TheTrueTom/GLINCS-KiCAD-Libraries/3D/GLINCS/KS_5_ADI.step

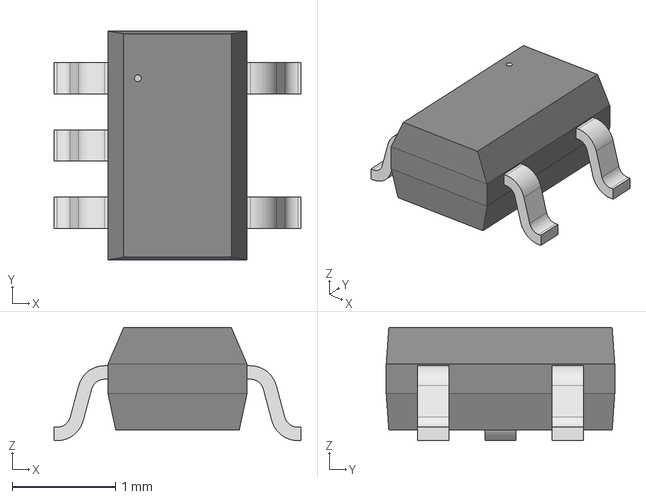
[picture p115: CAD file, 2021-05-18]
3D/GLINCS/KS_5_ADI.step
2.39 x 2.21 x 1.09 mm
