TheTrueTom/GLINCS-KiCAD-Libraries/3D/GLINCS_Connectors/HARTING_64_F.stp

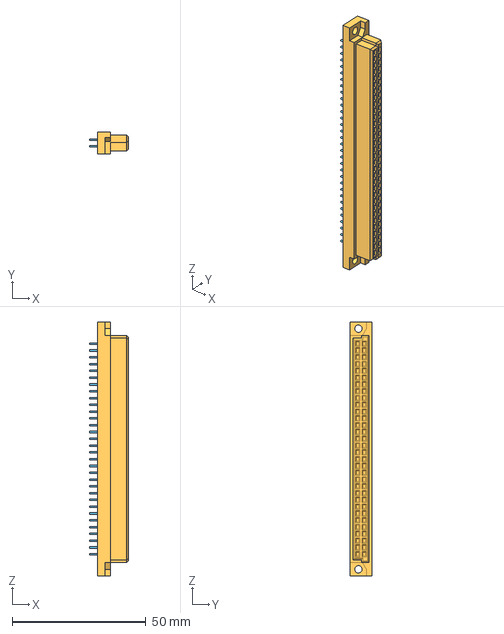
[picture p116: CAD file, 2021-11-29]
3D/GLINCS_Connectors/HARTING_64_F.stp
14.5 x 8.10 x 95.0 mm
