TheTrueTom/GLINCS-KiCAD-Libraries/3D/GLINCS/RM_8_ADI.step

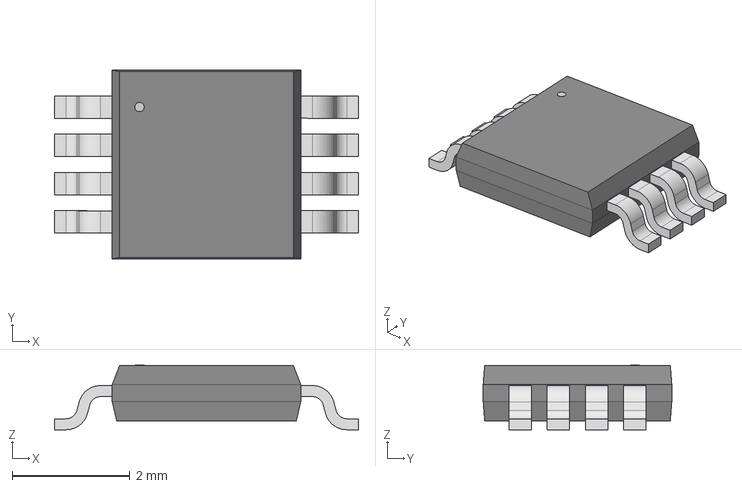
[picture p117: CAD file, 2021-05-18]
3D/GLINCS/RM_8_ADI.step
5.16 x 3.20 x 1.09 mm
