TheTrueTom/GLINCS-KiCAD-Libraries/3D/GLINCS/RU_16_ADI.step

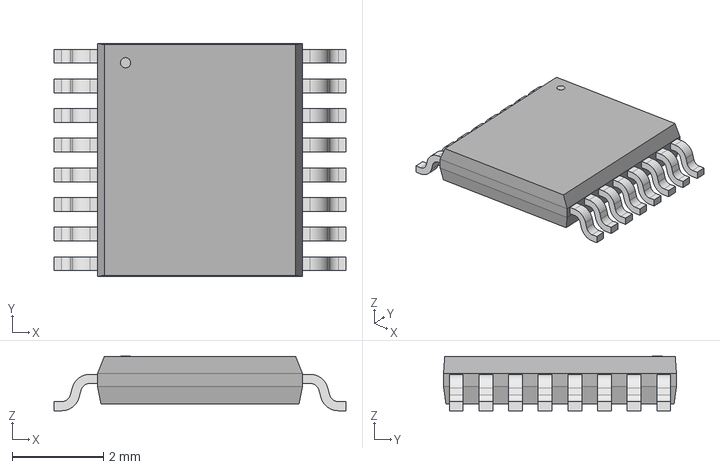
[picture p118: CAD file, 2021-05-18]
3D/GLINCS/RU_16_ADI.step
6.40 x 5.11 x 1.20 mm
