TheTrueTom/GLINCS-KiCAD-Libraries/3D/GLINCS_Connectors/CJT-T-P-HH-RA-BH1.stp

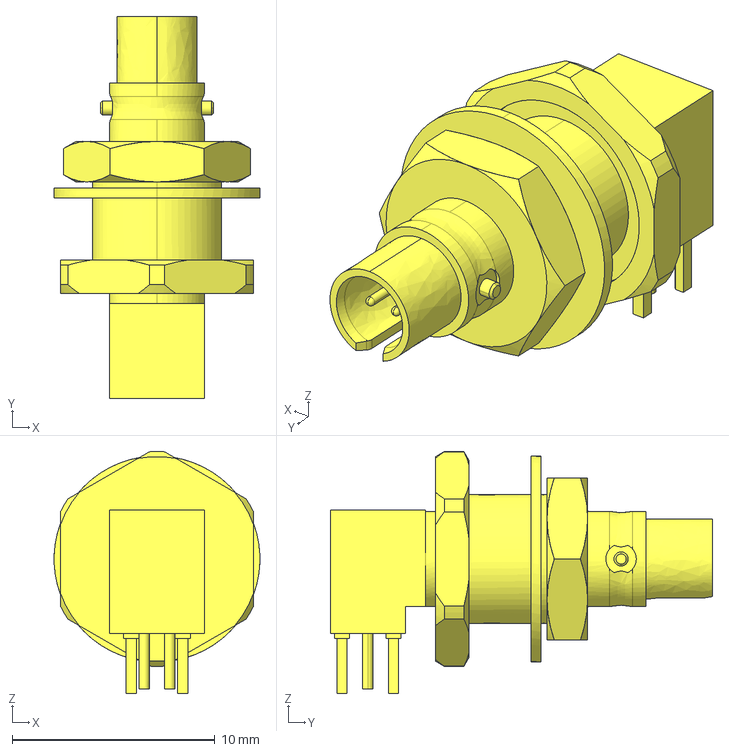
[picture p119: CAD file, 2021-05-18]
3D/GLINCS_Connectors/CJT-T-P-HH-RA-BH1.stp
10.1 x 18.9 x 11.9 mm
