TheTrueTom/GLINCS-KiCAD-Libraries/3D/GLINCS/RU_20_ADI.step

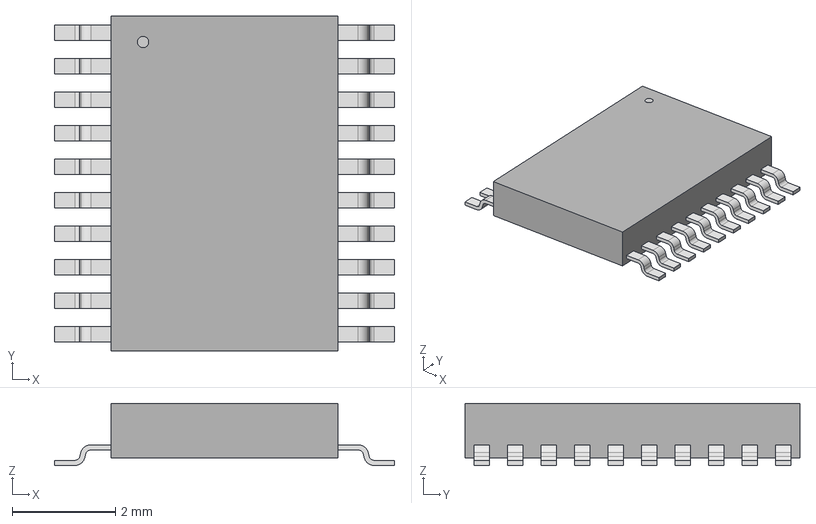
[picture p120: CAD file, 2021-05-18]
3D/GLINCS/RU_20_ADI.step
6.60 x 6.50 x 1.20 mm
