TheTrueTom/GLINCS-KiCAD-Libraries/3D/GLINCS/ARRAYC-60035-4P-BGA.stp

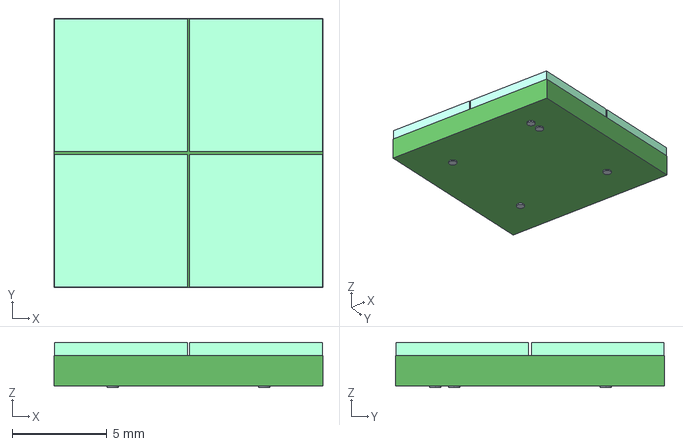
[picture p121: CAD file, 2021-05-18]
3D/GLINCS/ARRAYC-60035-4P-BGA.stp
14.2 x 14.2 x 2.40 mm
