TheTrueTom/GLINCS-KiCAD-Libraries/3D/GLINCS_Connectors/Raspberry_Pi_2_3.stp

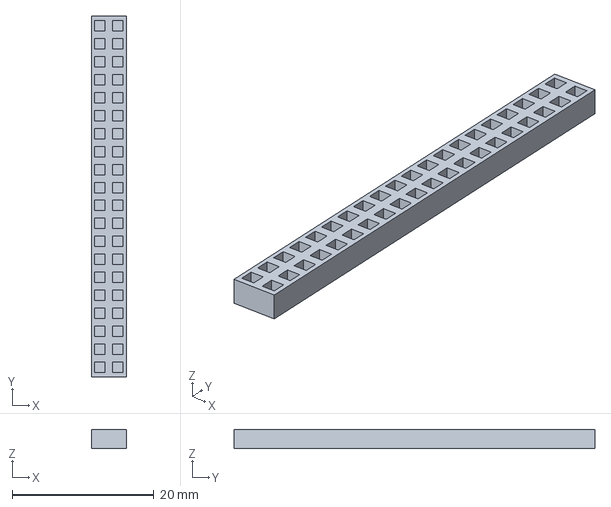
[picture p122: CAD file, 2021-05-18]
3D/GLINCS_Connectors/Raspberry_Pi_2_3.stp
5.00 x 51.0 x 2.70 mm
