TheTrueTom/GLINCS-KiCAD-Libraries/3D/GLINCS/SOIC18-W_MC_MCH.step

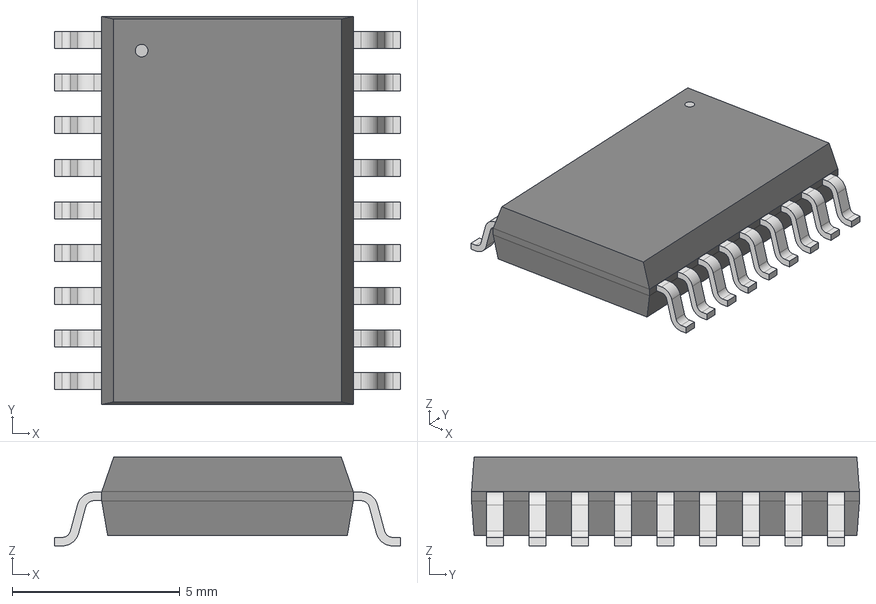
[picture p123: CAD file, 2021-05-18]
3D/GLINCS/SOIC18-W_MC_MCH.step
10.3 x 11.6 x 2.64 mm
