TheTrueTom/GLINCS-KiCAD-Libraries/3D/GLINCS/CRYSTAL_32.768kHz_6pF_SMD.step

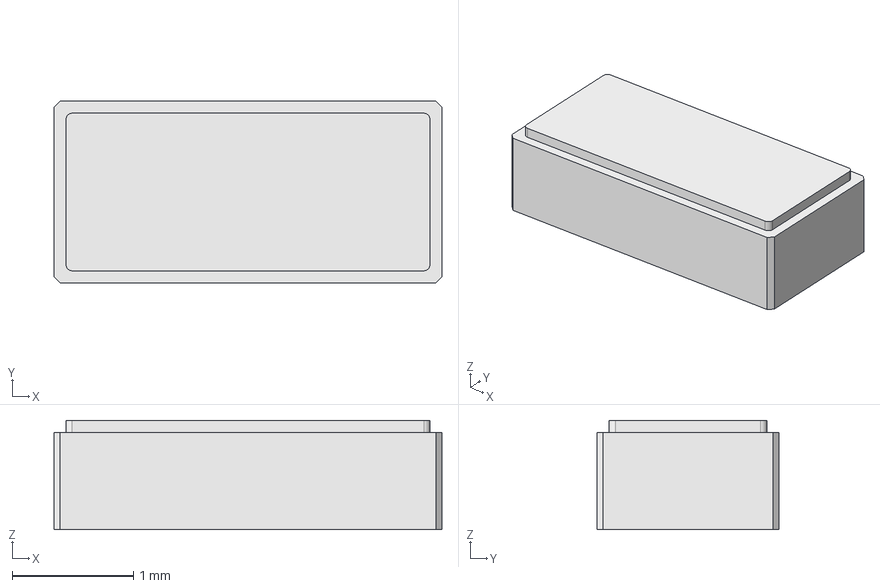
[picture p124: CAD file, 2021-05-18]
3D/GLINCS/CRYSTAL_32.768kHz_6pF_SMD.step
3.20 x 1.50 x 0.9 mm
