TheTrueTom/GLINCS-KiCAD-Libraries/3D/GLINCS_Connectors/219-6MST DIP SWITCH 6 VOIES.stp

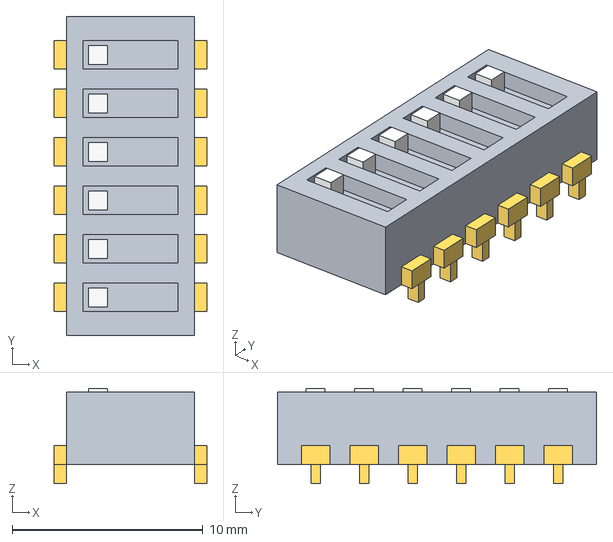
[picture p125: CAD file, 2021-05-18]
3D/GLINCS_Connectors/219-6MST DIP SWITCH 6 VOIES.stp
8.00 x 16.7 x 5.00 mm
