TheTrueTom/GLINCS-KiCAD-Libraries/3D/GLINCS/RNX0012B.stp

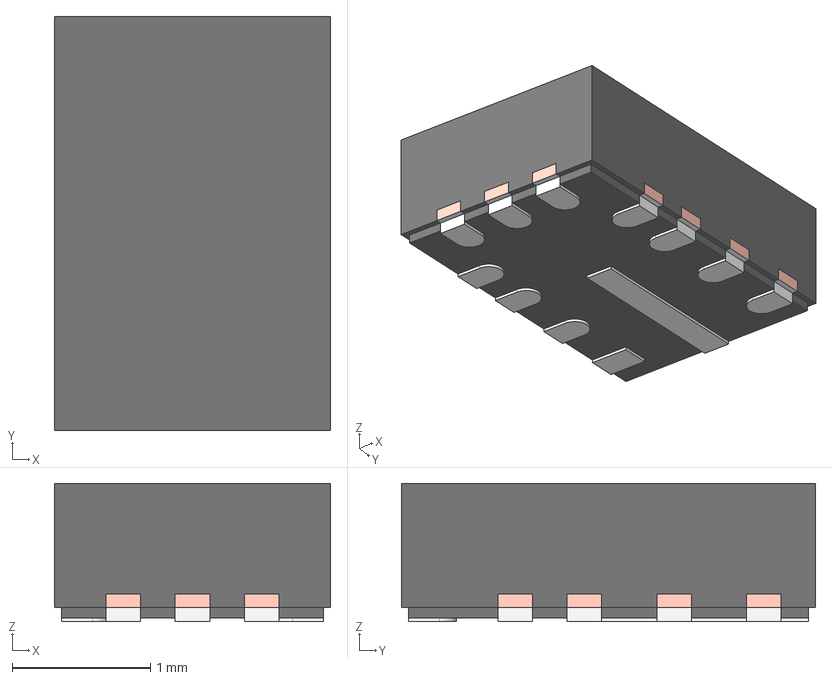
[picture p126: CAD file, 2021-05-18]
3D/GLINCS/RNX0012B.stp
2.00 x 3.00 x 1.00 mm
FRAME-RNX0012B_AF0
BODY-QFN_AF0
PIN1-ID
