TheTrueTom/GLINCS-KiCAD-Libraries/3D/GLINCS_Connectors/CJT-T-P-HH-RA-TH1.stp

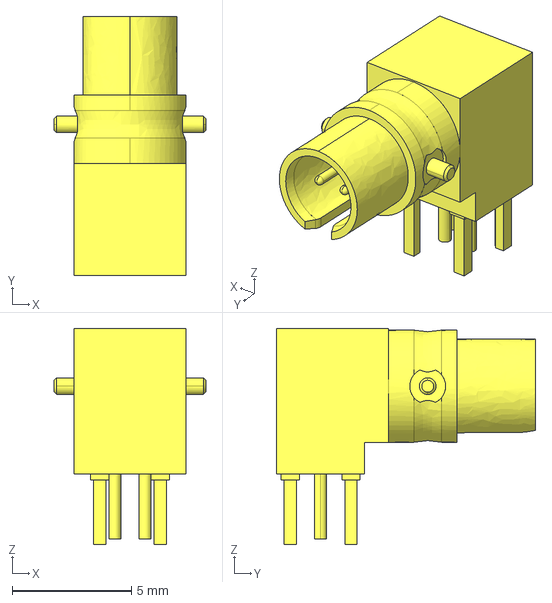
[picture p127: CAD file, 2021-05-18]
3D/GLINCS_Connectors/CJT-T-P-HH-RA-TH1.stp
6.35 x 10.9 x 9.05 mm
