TheTrueTom/GLINCS-KiCAD-Libraries/3D/GLINCS/CRYSTAL_FA-238_EPS.step

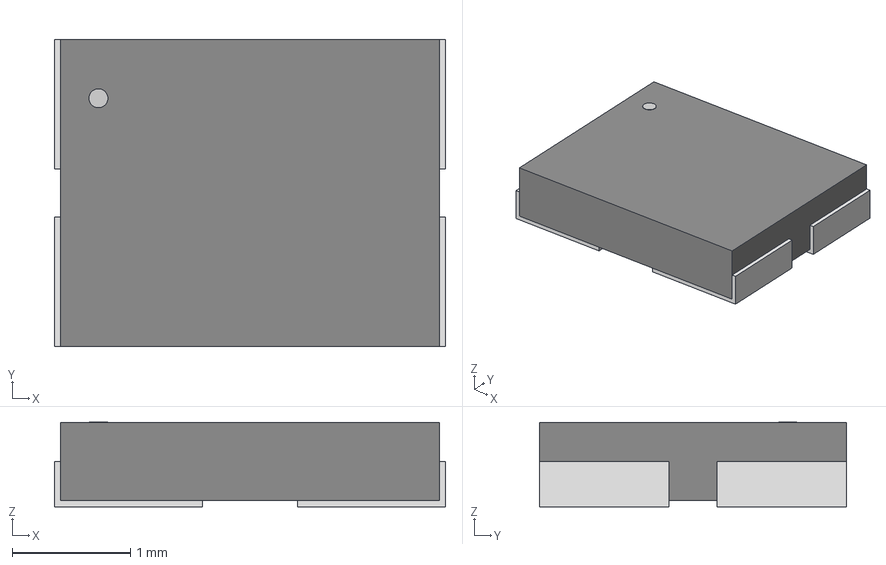
[picture p128: CAD file, 2021-05-18]
3D/GLINCS/CRYSTAL_FA-238_EPS.step
3.30 x 2.59 x 0.714 mm
