TheTrueTom/GLINCS-KiCAD-Libraries/3D/GLINCS/TDN1WI.stp

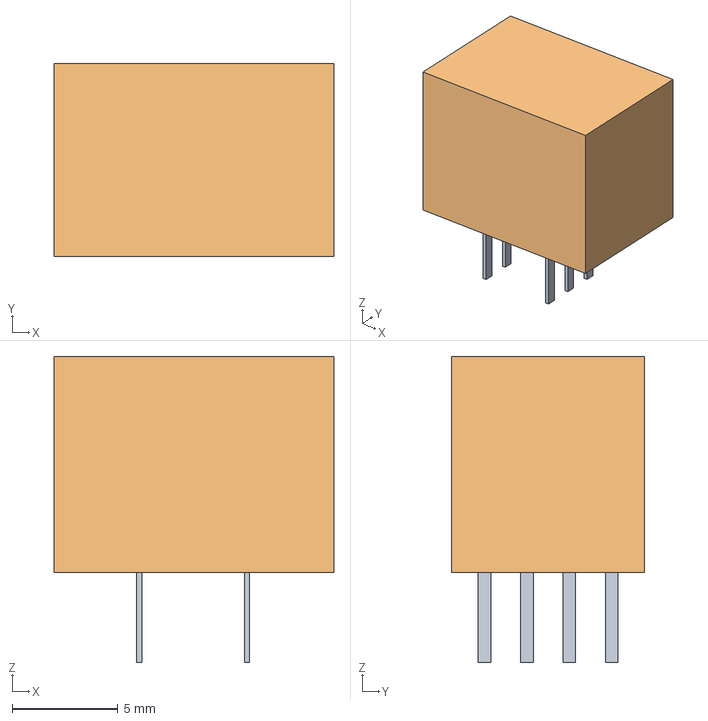
[picture p129: CAD file, 2020-12-03]
3D/GLINCS/TDN1WI.stp
13.2 x 9.10 x 14.4 mm
