TheTrueTom/GLINCS-KiCAD-Libraries/3D/GLINCS_Connectors/WR-WTB_6pins_2.54mm Coudé.stp

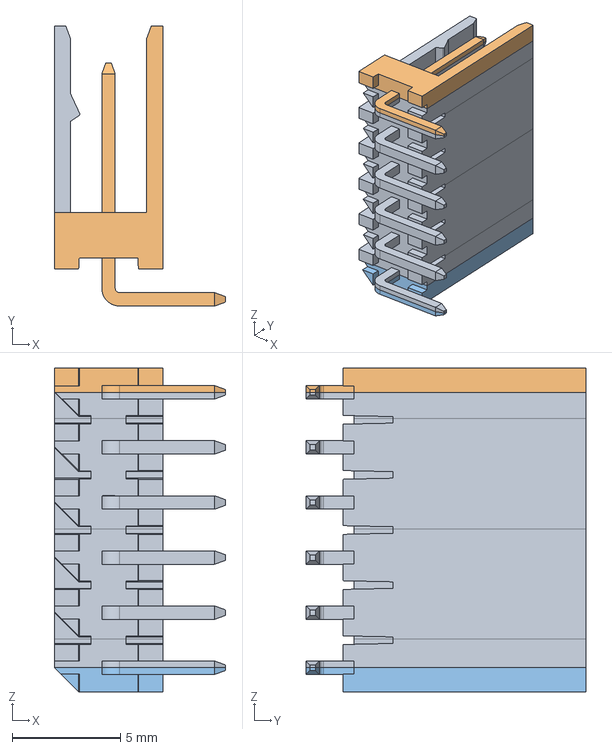
[picture p130: CAD file, 2020-12-03]
3D/GLINCS_Connectors/WR-WTB_6pins_2.54mm Coudé.stp
7.90 x 12.9 x 14.9 mm
