TheTrueTom/GLINCS-KiCAD-Libraries/3D/GLINCS_Connectors/Bornier WE 5mm x 2.stp

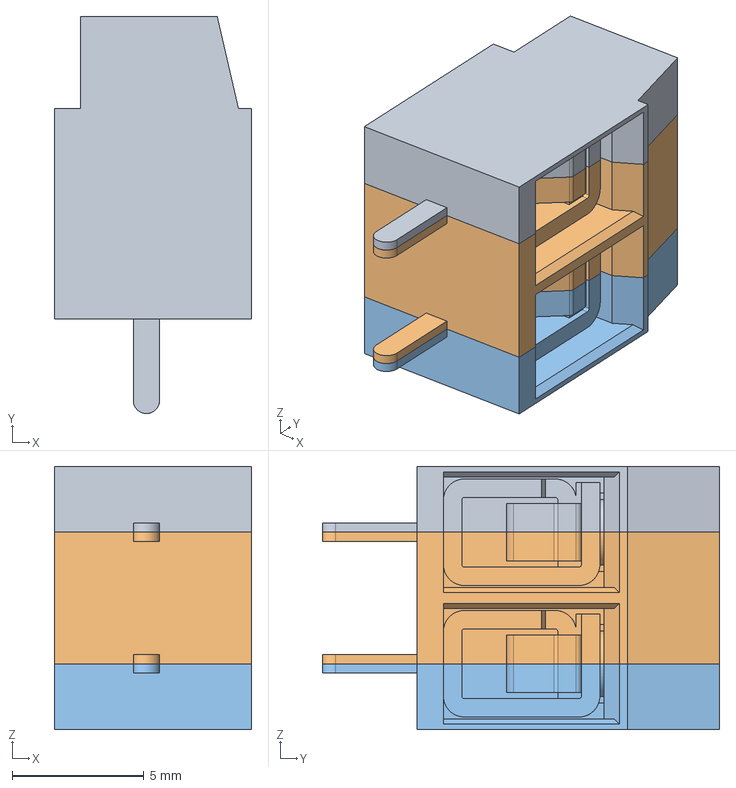
[picture p131: CAD file, 2020-09-14]
3D/GLINCS_Connectors/Bornier WE 5mm x 2.stp
7.50 x 15.1 x 10.0 mm
MRT12P5_SX
MRT12P5_CNT
MRT12P5_DX
