TheTrueTom/GLINCS-KiCAD-Libraries/3D/GLINCS_Connectors/WR-WTB_2pins_2.54mm.stp

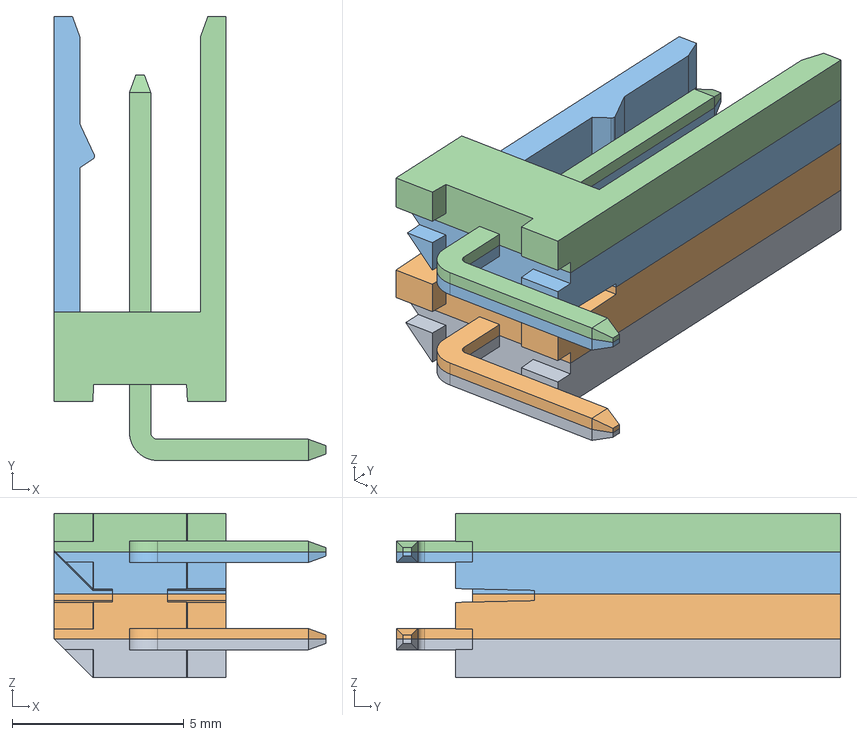
[picture p132: CAD file, 2020-08-31]
3D/GLINCS_Connectors/WR-WTB_2pins_2.54mm.stp
7.90 x 12.9 x 4.78 mm
