TheTrueTom/GLINCS-KiCAD-Libraries/3D/GLINCS/capteur pression.stp

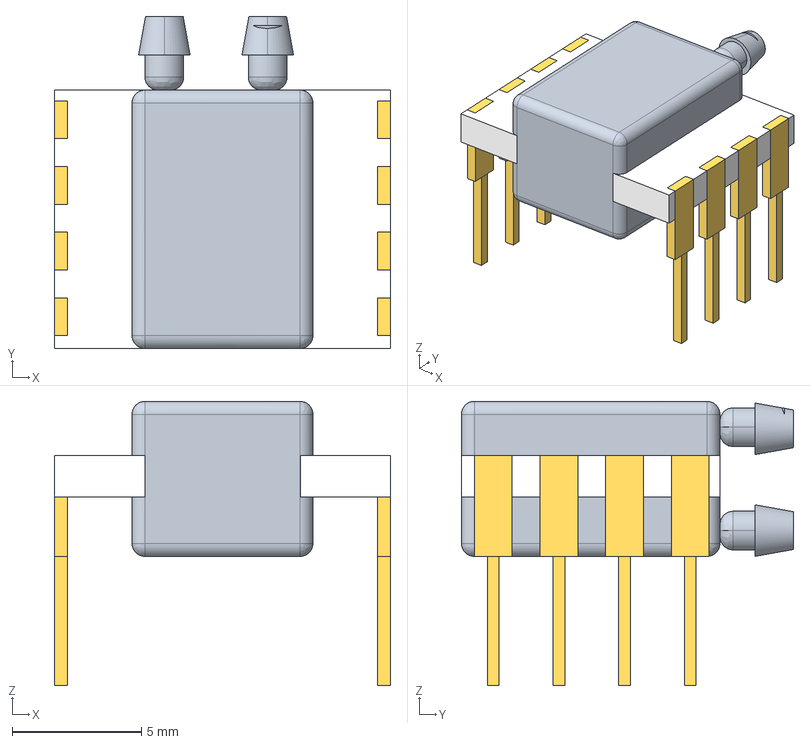
[picture p133: CAD file, 2019-10-30]
3D/GLINCS/capteur pression.stp
13.0 x 12.8 x 11.0 mm
