TheTrueTom/GLINCS-KiCAD-Libraries/3D/GLINCS_Connectors/SL-105-T-12.stp

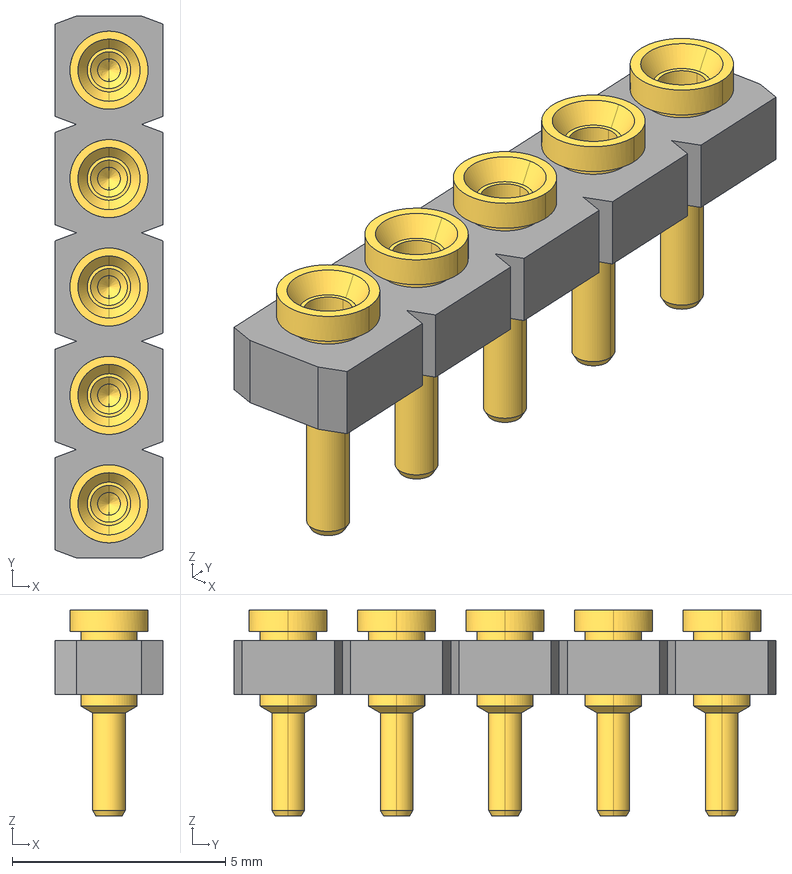
[picture p134: CAD file, 2020-01-22]
3D/GLINCS_Connectors/SL-105-T-12.stp
2.54 x 12.7 x 4.83 mm
