TheTrueTom/GLINCS-KiCAD-Libraries/3D/GLINCS/TSR2 package.stp

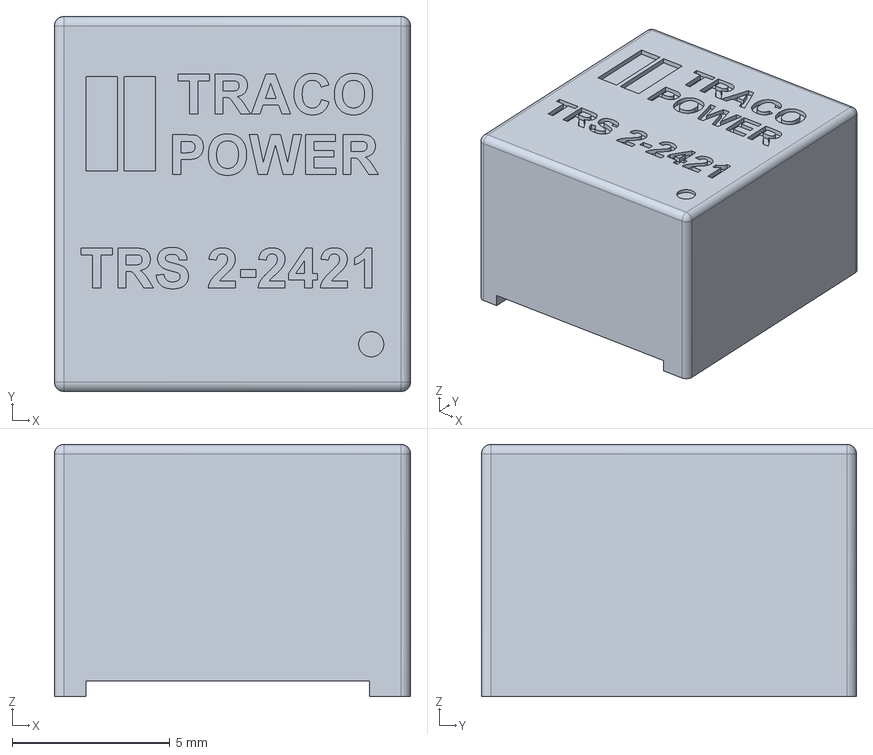
[picture p135: CAD file, 2019-08-29]
3D/GLINCS/TSR2 package.stp
11.3 x 11.9 x 8.00 mm
