TheTrueTom/GLINCS-KiCAD-Libraries/3D/GLINCS_Connectors/BBL-106-G-E.stp

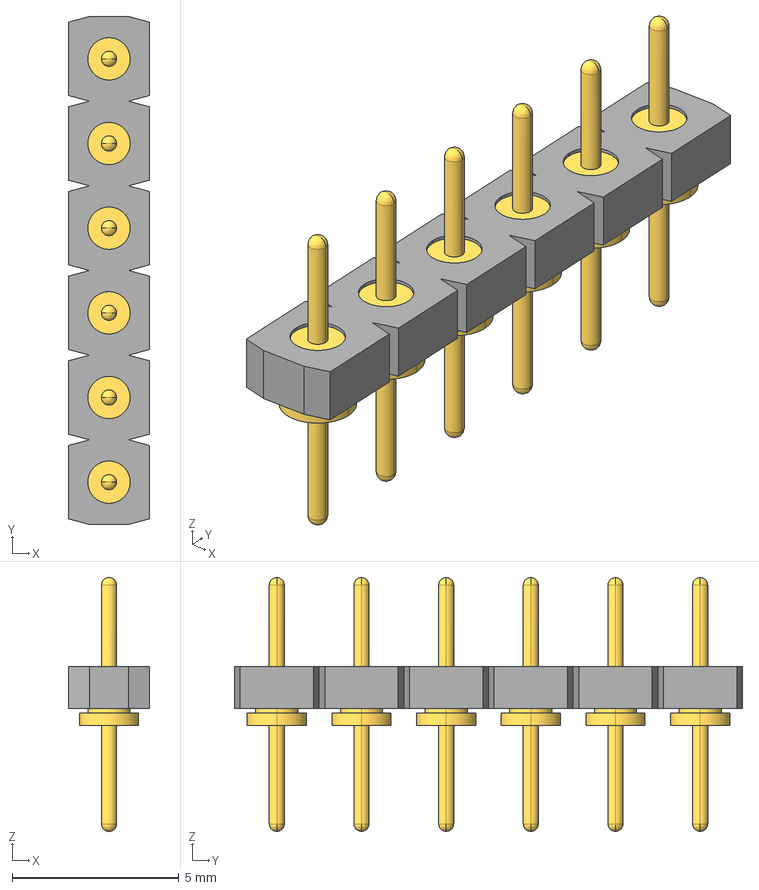
[picture p136: CAD file, 2020-01-22]
3D/GLINCS_Connectors/BBL-106-G-E.stp
2.44 x 15.2 x 7.62 mm
