TheTrueTom/GLINCS-KiCAD-Libraries/3D/GLINCS/CRYSTAL_16MHz_18pF_SMD.stp

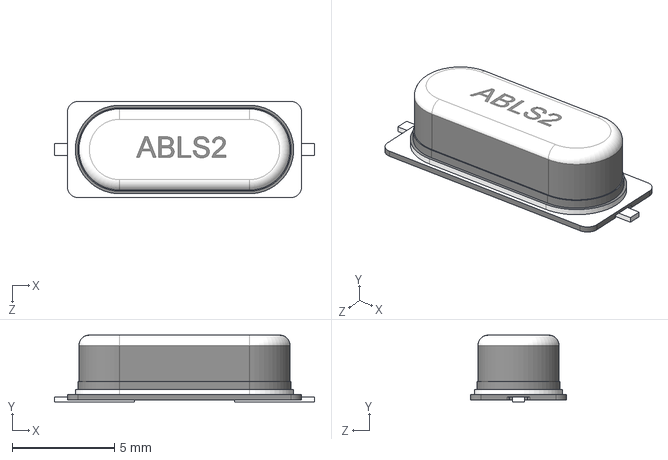
[picture p137: CAD file, 2018-11-24]
3D/GLINCS/CRYSTAL_16MHz_18pF_SMD.stp
12.7 x 3.27 x 4.70 mm
