TheTrueTom/GLINCS-KiCAD-Libraries/3D/GLINCS/dsPIC33EP512MC806IPT.stp

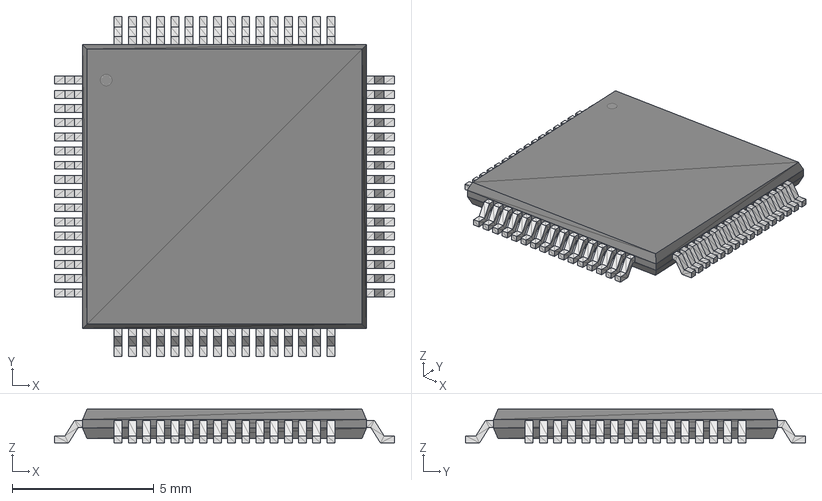
[picture p138: CAD file, 2018-11-23]
3D/GLINCS/dsPIC33EP512MC806IPT.stp
12.0 x 12.0 x 1.20 mm
