TheTrueTom/GLINCS-KiCAD-Libraries/(list of files, cad)

Other CAD files:
3D/GLINCS/MICROFJ_60035.stp
3D/GLINCS_Connectors/S3B-ZR-SM4A-TF.STEP
3D/GLINCS_Connectors/orange4.stp
3D/GLINCS_Connectors/orange6.stp
3D/GLINCS_Connectors/orange.stp
3D/GLINCS/RES_0603.step
3D/GLINCS_Connectors/S6B-XH-A-1.STEP
3D/GLINCS_Connectors/orange2.stp
3D/GLINCS_Connectors/orange5.stp
3D/GLINCS/DC-DC_5V_6W.stp
3D/GLINCS_Connectors/BBL-104-G-E.stp
3D/GLINCS/ARRAYC-60035-4P-BGA.3dm
3D/GLINCS/DC-DC_24V_30W.stp
3D/GLINCS/DC-DC_5V_8W.stp
3D/GLINCS/HAMAMATSU S5160.3dm
3D/GLINCS/LED 3MM RA.3dm
3D/GLINCS/LTC4020EUHF.stp
3D/GLINCS/MICROFJ_60035.stp.3dm
3D/GLINCS/RCD-24.3dm
3D/GLINCS/Relay_Module.3dm
3D/GLINCS/SIPMUFC60035.3dm
3D/GLINCS/TDN1WI.3dm
3D/GLINCS/TSR2 package.3dm
3D/GLINCS/UFJ30035.3dm
3D/GLINCS/UFJ30035.dxf
3D/GLINCS/UFJ30035.stp
3D/GLINCS/capteur pression.3dm
3D/GLINCS_Connectors/219-6MST DIP SWITCH 6 VOIES.3dm
3D/GLINCS_Connectors/452403012014 slide switch WE.stp
3D/GLINCS_Connectors/483930001.stp
3D/GLINCS_Connectors/61001221121 (rev1).stp
3D/GLINCS_Connectors/610012243021 (rev1).stp
3D/GLINCS_Connectors/626008210201_Embase_coudée.stp
3D/GLINCS_Connectors/626008220101_Embase_droite.stp
3D/GLINCS_Connectors/686104183822 (rev1).stp
3D/GLINCS_Connectors/68610614422.stp
3D/GLINCS_Connectors/686106183822.stp
3D/GLINCS_Connectors/68610814122.step
3D/GLINCS_Connectors/686108183822.step
3D/GLINCS_Connectors/68710614522_Download_STP_68710614522_rev1.stp
3D/GLINCS_Connectors/687306124422_Download_STP_687306124422_rev1.stp
3D/GLINCS_Connectors/731375003.stp
3D/GLINCS_Connectors/BBL-105-G-E.stp
3D/GLINCS_Connectors/Bornier WE 5mm x 2.3dm
3D/GLINCS_Connectors/CJT-T-P-HH-RA-BH1.3dm
3D/GLINCS_Connectors/CJT-T-P-HH-RA-TH1.3dm
3D/GLINCS_Connectors/CONN_BNC_JACK_STR_50_OHM_PCB.stp
3D/GLINCS_Connectors/Connecteur_Sub-D9_vertical.stp
3D/GLINCS_Connectors/HLE-110-02-L-SV.stp
3D/GLINCS_Connectors/Jumper_NC_Dual.stp
3D/GLINCS_Connectors/SL-104-T-12.stp
3D/GLINCS_Connectors/SL-106-T-12.stp
3D/GLINCS_Connectors/WR-COM_µUSB_Type_B_Vertical_5_Contacts.stp
3D/GLINCS_Connectors/WR-PHD_2x16_2.54mm.stp
3D/GLINCS_Connectors/WR-WTB_2x5pins_2.54mm_coude.stp
3D/GLINCS_Connectors/WR-WTB_4pins_1.25mm.stp
3D/GLINCS_Connectors/WR-WTB_4pins_2.54mm.stp
3D/GLINCS_Connectors/WR-WTB_4pins_2.54mm_vertical.stp
3D/GLINCS_Connectors/WR-WTB_5pins_2.54mm.stp
3D/GLINCS_Connectors/WR-WTB_6pins_2.54mm Coudé.3dm
3D/GLINCS_Connectors/c-282834-2-c-3d.stp
3D/GLINCS_L/74438335100.stp
3D/GLINCS_L/DFE252012P-1R0MP2.step
3D/GLINCS_L/MSS1260-104MLD.3dm
