TheTrueTom/GLINCS-KiCAD-Libraries/(commit log)

2018-11-21 add subD connector
    [Connecteur_Sub-D9_vertical.stp]
2018-11-23 Add dsPIC33EP512MC806IPT
    [dsPIC33EP512MC806IPT.stp]
2018-11-23 Add pin 1 markers
2018-11-23 Add connectors
    [CONN_BNC_JACK_STR_50_OHM_PCB.stp, WR-COM_µUSB_Type_B_Vertical_5_Contacts.stp, WR-WTB_4pins_1.25mm.stp, WR-WTB_4pins_2.54mm.stp, WR-WTB_4pins_2.54mm_vertical.stp, WR-WTB_5pins_2.54mm.stp]
2018-11-23 Update capacitor library
2018-11-24 Add coils
    [CRYSTAL_16MHz_18pF_SMD.stp]
2018-12-03 Update after 1001
    [CRYSTAL_32.768kHz_6pF_SMD.step, Jumper_NC_Dual.stp]
2019-02-15 updated some component
    [HLE-110-02-L-SV.stp]
2019-03-25 more traco power
    more traco power and qr codes components
2019-07-11 Remove custom footprints
    Remove OPAMP_ZERO_DRIFT_1.5 MHZ custom footprint to replace it with standard SOIC-8
    Remove 10BIT_FET_BUS_EX_SWITCH custom footprint to replace it with standard SOIC-24
2019-08-08 Add componants
    Add componants for ANDRABETAV2 project (beta probes ANDRA)
2019-08-12 add capacitor
    add capacitor
2019-08-28 Add some 3D models (anal plugs)
    [BOURNS SDR1006.stp, TSR2 package.stp, bobine Tayo yuden.stp]
2019-08-28 Modify 3D model (anal plug)
    [TSR2 package.3dm, TSR2 package.stp]
2019-08-29 Add resistor that BH deleted
2019-10-23 add arduino uno
2019-10-25 Add pressure sensor
2019-10-25 add TCK-048 inductor
    [TCK-048.stp]
2019-10-30 add CAD MODEL FOR PRESSURE SENSOR
    [capteur pression.3dm, capteur pression.stp]
2019-11-07 add dip switch
2019-11-22 add USB connector
2020-01-22 add new components for andra cards and fuck your dog.
    Very deep.
    [68710614522_Download_STP_68710614522_rev1.stp, 74438335100.stp, BBL-104-G-E.stp, BBL-105-G-E.stp, BBL-106-G-E.stp, SL-104-T-12.stp, SL-105-T-12.stp, SL-106-T-12.stp]
2020-02-12 ta mère en slip
    je pousse pour le plaisir
    [687306124422_Download_STP_687306124422_rev1.stp, SIPM UFC60035.stp, SIPMUFC60035.3dm]
2020-08-17 ajout de composants trop classes
    dans ton cul
2020-08-31 add more components
    non
    [DC-DC_5V_6W.stp, WR-WTB_2pins_2.54mm.stp]
2020-09-08 Create QR_ANDRABETA_V2.4.kicad_mod
    QR code ANDRABETA V2.4 créé avec la bite, poussé avec le fion. Le plus important étant d'être actif au bon moment.
2020-09-08 correction de référence
2020-09-09 correct dspic footprint
    le composant etait tagé traversant donc ne ortait pas correctement dans les fichiers de placement
2020-09-14 ajout des connecteurs JST-GH + ajout de quelques modèles 3D sur composants existants
    [BM02B-GHS-TBT.STEP, BM03B-GHS-TBT.STEP, BM04B-GHS-TBT.STEP, Bornier WE 5mm x 2.3dm, Bornier WE 5mm x 2.stp, GHR-02V-S.STEP, GHR-03V-S.STEP, GHR-04V-S.STEP]
2020-12-03 add various component
    [61001221121 (rev1).stp, 610012243021 (rev1).stp, BM06B-GHS-TBT.stp, MSS1260-104MLD.3dm, MSS1260-104MLD.stp, SM06B-GHS-TB(LF)(SN)--3DModel-STEP-56544.STEP, TDN1WI.3dm, TDN1WI.stp]
2021-05-18 recupéreation librairies non push sur PC HP
    [219-6MST DIP SWITCH 6 VOIES.3dm, 219-6MST DIP SWITCH 6 VOIES.stp, 483930001.stp, 61001221121 (rev1).stp, 610012243021 (rev1).stp, 68710614522_Download_STP_68710614522_rev1.stp, 687306124422_Download_STP_687306124422_rev1.stp, 74438335100.stp]
2021-05-26 updated library with the new stm32 chip
2021-05-31 added stm32 linkv3
2021-05-31 Revert "added stm32 linkv3"
    This reverts commit f2b6638a89ce45e25bbb20fd054e1f037516628e.
2021-05-31 correct glincs libraries
    STM32 footprint needs and tag connect for STM32 need to be added again because they caused a mistake in the glincs.lib symbol library
2021-06-01 updated the glincs library for the tag-stm32
2021-10-21 Add component + update many shortage cap and res
    [QFN-S28_6x6MC_MCH.step, UFJ30035.3dm, UFJ30035.dxf, UFJ30035.stp]
2021-10-29 add components
    [TQFP44_10x10MC_MCH.step, ten40e_3d_drawing.stp]
2021-11-29 add or update components
    [HARTING_64_F.stp, HARTING_64_M.stp, LED 3MM RA.3dm, LED _3MM_RA.stp]
2022-04-06 update components
    [731375003.stp, Relay_Module.3dm, Relay_Module.stp]
2022-06-15 Convert Libraries to Kicad 6
    From this point, V5 libraries will not be updated anymore
2022-11-09 Add components for videns switch
    [CAP_1206.step, DBV0005A.stp, IND_TAIYO_NRS4018_TAY.step, IRFZ34PBF.stp, LED_APT1608_KNB.step, LED_PA01_PLL.step, LXZ1-PR01 with reflector.stp, RCD-24.3dm]
2023-04-24 mise à jour composants
    [2320306_Batterie_24V_3.4AH.stp, IND_1210-WE-LQ_WRE.step, IND_TCK-097_TRP.step, INTERRUPTEUR SECTEUR.stp, R0.25D-053.3.step, RS3_RCP.step, SSOP-16_GN_LIT.step, THN-2030-2425WIR.STEP]
2023-06-19 add component for Excitabox
    [B4B-PH-SM4-TB.STEP, B8B-PH-SM4-TB.STEP, DW0024B.stp, PW0014A.stp, S8B-PH-SM4-TB.STEP, TMC5130-BOB.stp]
2025-09-26 update libraries
    [21-0041B_8.step, 452403012014 slide switch WE.stp, 686104183822 (rev1).stp, 68610614422.stp, 686106183822.stp, 70AAJ-4-F0.stp, 70AAJ-4-MO.stp, 813-S1-004-10-014101.stp]
2025-09-26 Update pin type
    Update pin type (output, input, power input ...) on VCAP DSPIC33EP512, AD8564ARU, LTC6993IS6
2025-09-26 Update pin type
2025-10-24 MAJ txt silkscreen thickness
2026-03-02 Maj composants divers
    [MICROFJ_60035.stp, MICROFJ_60035.stp.3dm, MICROFJ_60035_COLOR.stp, S3B-ZR-SM4A-TF-rhino.stp, S3B-ZR-SM4A-TF.STEP, S3B-ZR-SM4A-TF.STEP.stl]
2026-03-03 add B3B-ZR-SM4A-TF JST connector
    [B3B-ZR-SM4-TF--3DModel-STEP-56544.STEP]
2026-04-14 add Amphenol SFW16 and WE 686108183822 FPS connectors
    [68610814122.step, 686108183822.step, B10B-ZR-SM4-TF--3DModel-STEP-56544.STEP, BM03B-SRSS-TB-LFSN.STEP, SFW16R-1STE1LF.STEP, SFW16R-2STE1LF.step, SFW16S-2STE1LF.step, housing.stp]
2026-04-16 add phoenix contact connectors
2026-04-17 add WE WR-NPC2
    [626008210201_Embase_coudée.stp, 626008220101_Embase_droite.stp, B3B-ZR.STEP]
2026-05-06 MAJ Mounting_hole
    changement des pads de fixation en NPTH
