TheTrueTom/GLINCS-KiCAD-Libraries/(notices)

Notices in the files:
3D/GLINCS/Analog_LFCSP-16-1EP_4x4mm_P0.65mm_EP2.1x2.1mm.step:
Copyright (C) 2023, KiCAD
This work is licensed under the
[Creative Commons CC-BY-SA 4.0 License](https://creativecommons.org/licenses/by-sa/4.0/legalcode),
with the following exception:
project files under this or any other license agreement. However, if you wish to distribute
3D/GLINCS_Connectors/TSM-104-01-L-SV-P-TR.step:
author */ ('License CC BY-ND 4.0'),
